jocoteles/Stellector/horus/horus_esp32/horus32/README.MD

# horus32.ino

This is the code to be loaded in the ESP32 board which is part of the Horus hardware in the Stellector project. A ESP-WROOM-32 DevKitC V1 was used for this project.
