jocoteles/Stellector/horus/horus_3d_parts/README.MD

Horus 3D parts
==============

Horus 3D parts were written with Python codes using FreeCAD libraries.

Files in *obj* format were rendered with FreeCAD using the Python codes.
