jocoteles/Stellector/horus/horus_3d_parts/spiralCoil_5v_p100.obj

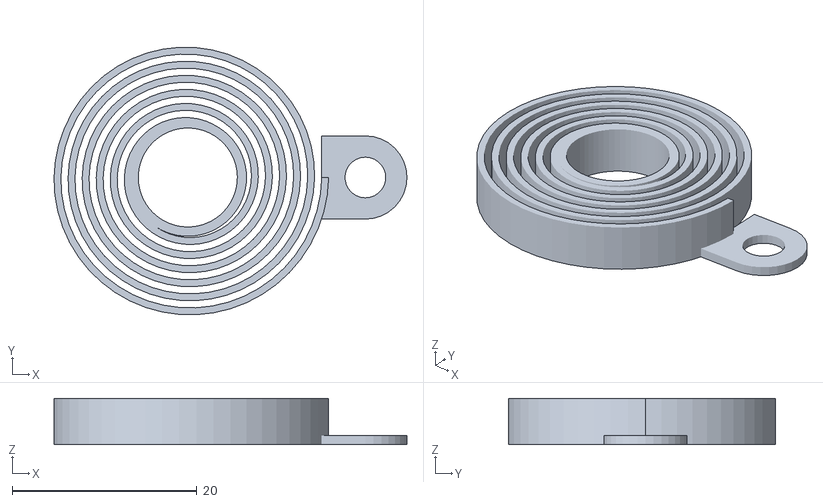
[picture p19: CAD file, 2021-11-09]
horus/horus_3d_parts/spiralCoil_5v_p100.obj
38.2 x 28.9 x 5.00
