jocoteles/Stellector/horus/horus_3d_parts/laserCase.obj

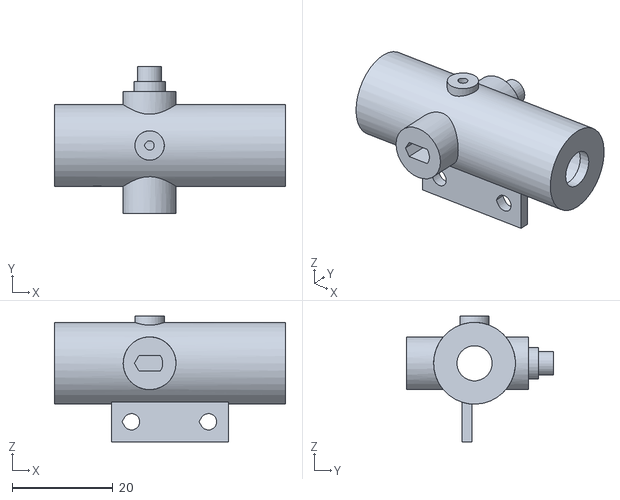
[picture p20: CAD file, 2021-11-01]
horus/horus_3d_parts/laserCase.obj
45.9 x 29.2 x 25.0
