jocoteles/Stellector/horus/horus_3d_parts/towerStepper.obj

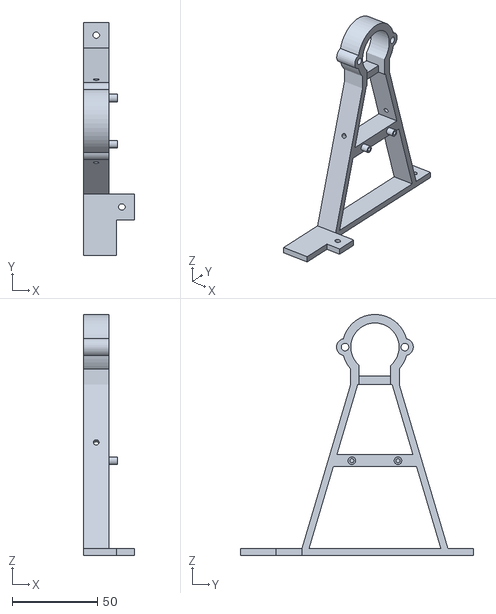
[picture p21: CAD file, 2021-11-01]
horus/horus_3d_parts/towerStepper.obj
30.0 x 136.5 x 141.1
