jocoteles/Stellector/horus/horus_3d_parts/towerBearing.obj

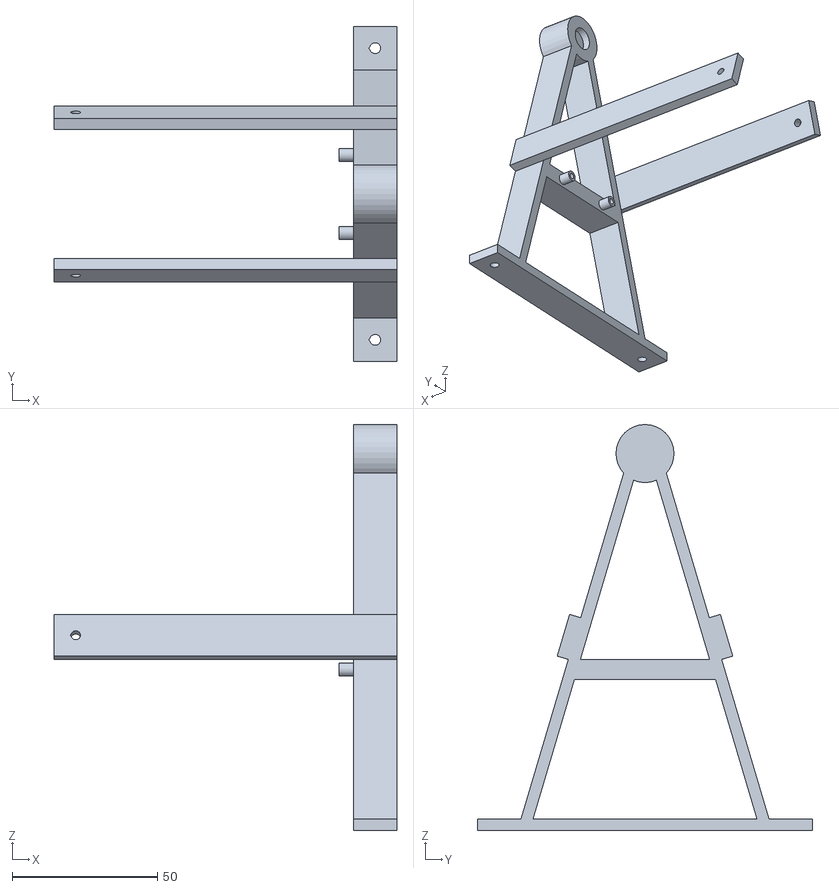
[picture p22: CAD file, 2021-11-01]
horus/horus_3d_parts/towerBearing.obj
118.2 x 115.5 x 140.0
