jocoteles/Stellector/horus/horus_3d_parts/laserShaftSupport.obj

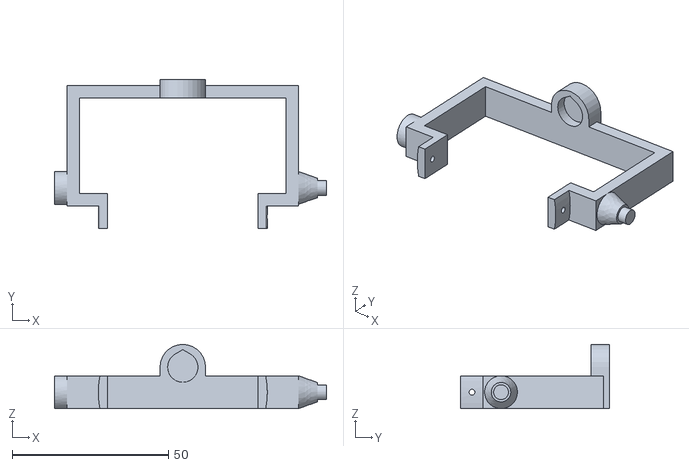
[picture p23: CAD file, 2021-11-01]
horus/horus_3d_parts/laserShaftSupport.obj
86.9 x 47.8 x 20.5
