jocoteles/Stellector/horus/horus_3d_parts/octagonalBase.obj

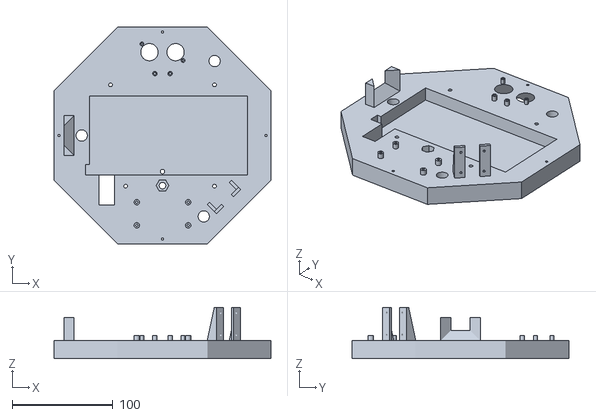
[picture p24: CAD file, 2021-11-01]
horus/horus_3d_parts/octagonalBase.obj
215.5 x 215.5 x 51.0
