jocoteles/Stellector/horus/horus_3d_parts/stepperMob.obj

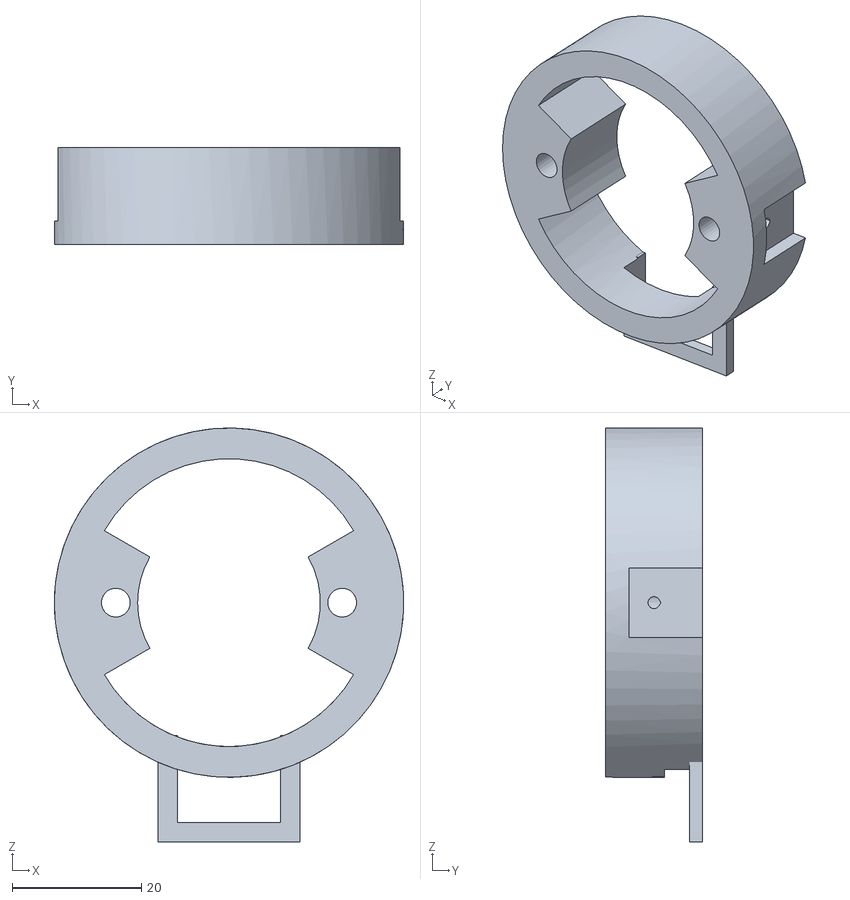
[picture p25: CAD file, 2021-11-01]
horus/horus_3d_parts/stepperMob.obj
54.0 x 15.0 x 64.0
