jocoteles/Stellector/horus/horus_electronics/Schematic_Stellector_2021-10-18.pdf

Fixed step motor | ESP32

## Fixed step motor driver

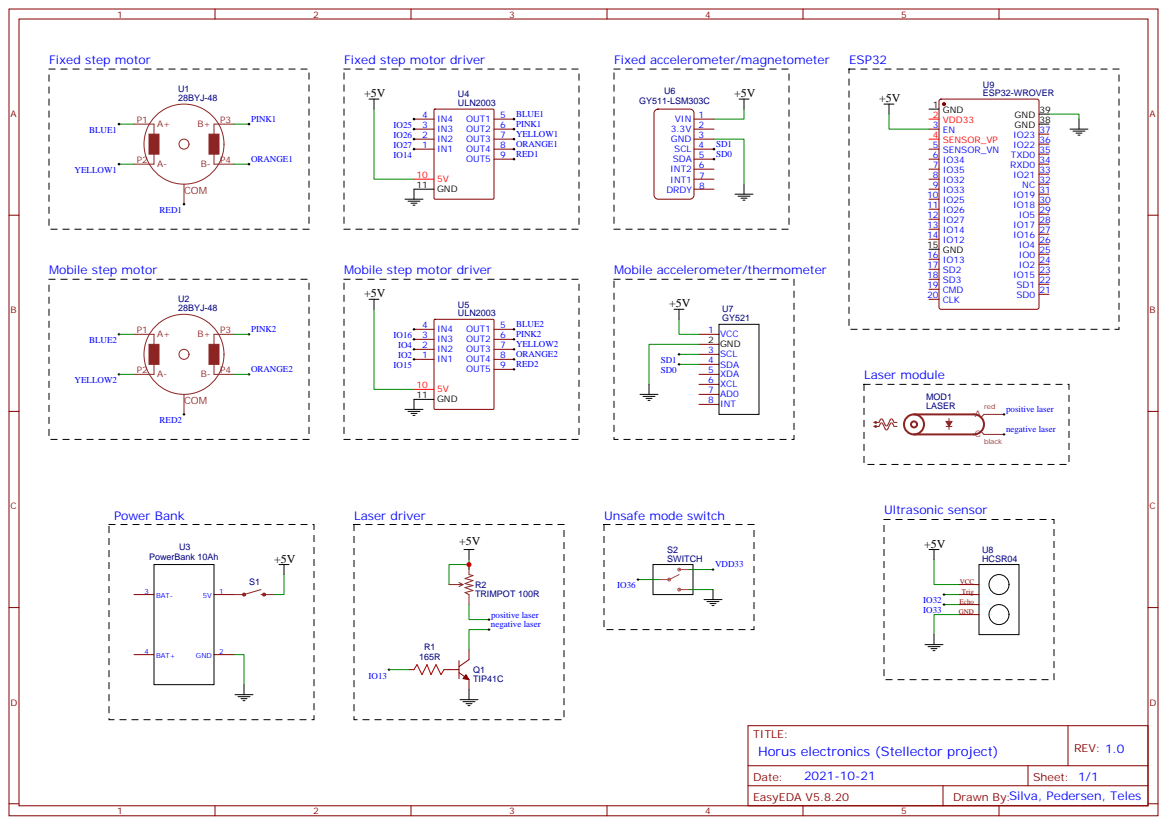
[picture p26: page 1]

TITLE:
Horus electronics (Stellector project)
