jocoteles/Stellector/images/stellector_diagram.pdf

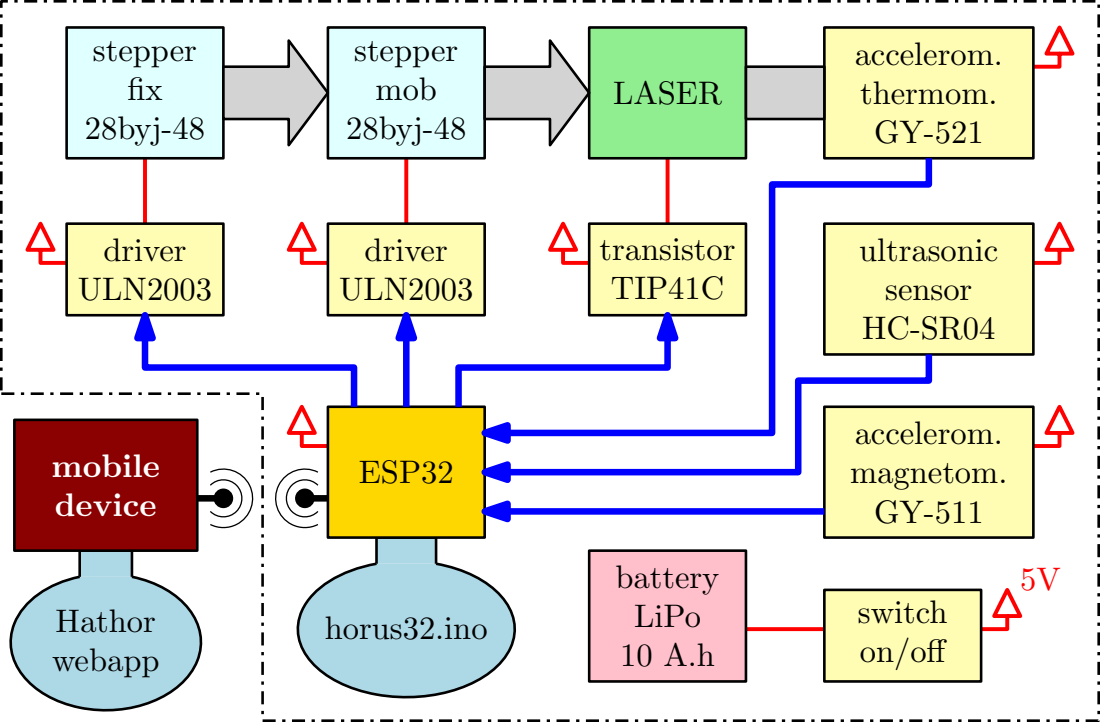
[picture p27: page 1]
stepper fix 28byj-48; stepper mob; 28byj-48; LASER; ultrasonic sensor HC-SR04; driver ULN2003; transistor TIP41C; accelerom. thermom. GY-521; accelerom. magnetom. GY-511; battery LiPo 10 A.h; switch on/off; Hathor horus32.ino webapp; mobile; device; ESP32
