jocoteles/Stellector/hathor/data/dsonames.js

/* 
Copyright (c) 2015, Olaf Frohn
All rights reserved.

Redistribution and use in source and binary forms, with or without modification, are permitted provided that the following conditions are met:

1. Redistributions of source code must retain the above copyright notice, this list of conditions and the following disclaimer.

2. Redistributions in binary form must reproduce the above copyright notice, this list of conditions and the following disclaimer in the documentation and/or other materials provided with the distribution.

3. Neither the name of the copyright holder nor the names of its contributors may be used to endorse or promote products derived from this software without specific prior written permission.

THIS SOFTWARE IS PROVIDED BY THE COPYRIGHT HOLDERS AND CONTRIBUTORS "AS IS" AND ANY EXPRESS OR IMPLIED WARRANTIES, INCLUDING, BUT NOT LIMITED TO, THE IMPLIED WARRANTIES OF MERCHANTABILITY AND FITNESS FOR A PARTICULAR PURPOSE ARE DISCLAIMED. IN NO EVENT SHALL THE COPYRIGHT HOLDER OR CONTRIBUTORS BE LIABLE FOR ANY DIRECT, INDIRECT, INCIDENTAL, SPECIAL, EXEMPLARY, OR CONSEQUENTIAL DAMAGES (INCLUDING, BUT NOT LIMITED TO, PROCUREMENT OF SUBSTITUTE GOODS OR SERVICES; LOSS OF USE, DATA, OR PROFITS; OR BUSINESS INTERRUPTION) HOWEVER CAUSED AND ON ANY THEORY OF LIABILITY, WHETHER IN CONTRACT, STRICT LIABILITY, OR TORT (INCLUDING NEGLIGENCE OR OTHERWISE) ARISING IN ANY WAY OUT OF THE USE OF THIS SOFTWARE, EVEN IF ADVISED OF THE POSSIBILITY OF SUCH DAMAGE.
*/

let dsonamesJSON = '{"18":{"name":"Calabash Nebula","ar":"‎‎سديم كالاباش‎‎","zh":"葫芦星云","fi":"Pullokurpitsasumu","fr":"Nébuleuse de la Calebasse","de":"Kürbis-Nebel","it":"Nebulosa Zucca","ko":"호리병박 성운","fa":"سحابی کدو قلیانی","es":"Nebulosa de la Calabaza","ru":"Туманность Калебаса"},"19":{"name":"Frosty Leo Nebula","ar":"‎‎سديم الأسد الصقيعي‎‎","zh":"霜狮星云","fi":"Leijonan huurresumu","fr":"Nébuleuse du Lion gelé","it":"Nebulosa Gelida del Leone","ko":"서리사자 성운","fa":"سحابی فراستی لئو","es":"Nebulosa del León Escarchado","ru":"Туманность Седой лев"},"20":{"name":"Gomez\'s Hamburger","ar":"‎‎هامبرجر جوميز‎‎","zh":"戈麦斯汉堡","fi":"Gomezin hampurilainen","fr":"Hamburger de Gomez","it":"Hamburger di Gomez","ko":"우주의 햄버거","fa":"سحابی همبرگرگومز","es":"Hamburguesa de Gomez","ru":"Гамбургер Гомеза"},"21":{"name":"Footprint Nebula","ar":"‎‎سديم أثر القدم‎‎","zh":"脚印星云","fi":"Jalanjälkisumu","fr":"Nébuleuse de l\'Empreinte de pas","de":"Fußabdruck-Nebel","it":"Nebulosa Orma","ja":"足跡星雲","ko":"발자국 성운","es":"Nebulosa de la Huella","ru":"Туманность След"},"22":{"name":"Sagittarius A East","ar":"‎‎القوس أ الشرقي‎‎","zh":"人马座东星","fi":"Sagittarius A itäinen","fr":"Sagittarius A Est","de":"Sagittarius A Ost","it":"Sagittarius A Est","ja":"いて座Aイースト","ko":"궁수자리 A 동쪽","la":"Sagittarius A orientalis","fa":"منطقه شرقی کماندار - A","es":"Sagittarius A Este","ru":"Восточный Стрелец А"},"23":{"name":"Sagittarius A West","ar":"‎‎القوس أ الغربي‎‎","zh":"人马座西星","fi":"Sagittarius A läntinen","fr":"Sagittarius A Ouest","it":"Sagittarius A Ovest","ja":"いて座Aウェスト","ko":"궁수자리 A 서쪽","la":"Sagittarius A occidentalis","fa":"منطقه غربی کماندار- A","es":"Sagittarius A Oeste","ru":"Западный Стрелец А"},"40":{"name":"Dark Doodad Nebula","ar":"‎سديم الشيء الداكن‎","zh":"黑饰品星云","fr":"Nébuleuse du Bidule sombre","de":"Dark Doodad","it":"Nebulosa Scura Marchingegno","ko":"다크 두데드 성운","es":"Nebulosa del Artilugio Oscuro","ru":"Туманность Тёмная штуковина"},"NGC 40":{"name":"Bow-Tie Nebula","ar":"‎‎سديم ربطة العنق‎‎","zh":"蝴蝶结星云","fi":"Rusettisumu","fr":"Nébuleuse du Nœud-Papillon","de":"Mascherl-Nebel","it":"Nebulosa Bow-Tie","ko":"부메랑 성운","fa":"سحابی پاپیون","es":"Nebulosa de lazo","ru":"Туманность Бабочка","tr":"Bumerang Bulutsusu"},"NGC 55":{"name":"String of Pearls","ar":"‎خيط اللؤلؤ‎","zh":"珍珠串星系","fi":"Helminauha","fr":"Collier de perles","de":"Perlenschnur","ko":"진주 고리","es":"Collar de Perlas","ru":"Жемчужная нить"},"NGC 87":{"name":"Robert\'s Quartet","ar":"‎‎رباعية روبرت‎‎","zh":"罗伯特四重星系","fi":"Robertin kvartetti","fr":"Quartette de Robert","de":"Roberts Quartett","it":"Quartetto di Robert","ko":"로버트의 사중주","fa":"چهارتایی رابرت","es":"Cuarteto de Robert","ru":"Квартет Роберта","tr":"Robert Dörtlüsü"},"NGC 88":{"name":"Robert\'s Quartet","ar":"‎‎رباعية روبرت‎‎","zh":"罗伯特四重星系","fi":"Robertin kvartetti","fr":"Quartette de Robert","de":"Roberts Quartett","it":"Quartetto di Robert","ko":"로버트의 사중주","fa":"چهارتایی رابرت","es":"Cuarteto de Robert","ru":"Квартет Роберта","tr":"Robert Dörtlüsü"},"NGC 89":{"name":"Robert\'s Quartet","ar":"‎‎رباعية روبرت‎‎","zh":"罗伯特四重星系","fi":"Robertin kvartetti","fr":"Quartette de Robert","de":"Roberts Quartett","it":"Quartetto di Robert","ko":"로버트의 사중주","fa":"چهارتایی رابرت","es":"Cuarteto de Robert","ru":"Квартет Роберта","tr":"Robert Dörtlüsü"},"NGC 92":{"name":"Robert\'s Quartet","ar":"‎‎رباعية روبرت‎‎","zh":"罗伯特四重星系","fi":"Robertin kvartetti","fr":"Quartette de Robert","de":"Roberts Quartett","it":"Quartetto di Robert","ko":"로버트의 사중주","fa":"چهارتایی رابرت","es":"Cuarteto de Robert","ru":"Квартет Роберта","tr":"Robert Dörtlüsü"},"NGC 104":{"name":"47 Tuc","ar":"‎‎47 الطوقان‎‎","zh":"杜鹃座47球状星团","de":"47 Tuc/NGC 104","el":"47 Τουκάνας","ja":"きょしちょう座47","ko":"큰부리새자리 47","fa":"47 تی یو سی","ru":"47 Тукана","he":"47 בטוקאן"},"NGC 128":{"name":"NGC 128 group","ar":"مجموعة إن جي سي ١٢٨","zh":"128星系群","fi":"NGC 128 -ryhmä","fr":"Groupe NGC 128","de":"NGC 128-Gruppe","ja":"NGC128銀河群","ko":"NGC 128 은하단","es":"Grupo NGC 128","ru":"Группа NGC 128"},"NGC 134":{"name":"Giant Squid Galaxy","ar":"‎‎مجرة الحبّار العملاق‎‎","zh":"大王乌贼星系","fi":"Jättiläiskalmarigalaksi","fr":"Galaxie du calmar géant","de":"Riesenkalmar-Galaxie","it":"NGC 134","ko":"대왕오징어 은하","fa":"کهکشان سرپاور عظیم","es":"Galaxia del calamar gigante","ru":"Галактика Гигантский кальмар"},"NGC 188":{"name":"Polarissima Cluster","ar":"‎حشد بولاريسيما‎","zh":"近极星团","fi":"Polarissima-joukko","fr":"Amas Polarissima","de":"Polarissima-Haufen","it":"Ammasso Polarissima","ko":"작은곰자리 성단","la":"Congregatio Polarissima","es":"Cúmulo Polarissima","ru":"Скопление Поляриссимы"},"NGC 206":{"name":"Great Star Cloud in Andromeda Galaxy","ar":"‎سحابة النجوم العظيمة في مجرة أندروميدا‎","zh":"仙女座星系中的大恒星云","fi":"Andromedan galaksin suuri tähtipilvi","fr":"Grand numage d\'étoiles de la Galaxie d\'Andromède","de":"Große Sternwolke in der Andromeda-Galaxie","it":"Grande Nube Stellare nella galassia di Andromeda","ja":"アンドロメダ銀河の大スタークラウド","ko":"안드로메다 은하의 대성운","la":"Magna Nubes Stellarum in Galaxia Andromedae","es":"Gran nube de estrellas en la galaxia de Andrómeda","ru":"Большое звёздное облако в галактике Андромеды","tr":"Andromeda Galaksi\'sinde Büyük Yıldız Bulutu"},"NGC 224":{"name":"Andromeda Galaxy","ar":"‎‎مجرة أندروميدا‎‎","zh":"仙女座星系","fi":"Andromedan galaksi","fr":"Galaxie d\'Andromède","de":"Andromeda-Galaxie","el":"Γαλαξίας της Ανδρομέδας","it":"Galassia di Andromeda","ja":"アンドロメダ銀河","ko":"안드로메다 은하","la":"Andromeda Nebula","fa":"کهکشان آندرومدا","es":"Galaxia Andrómeda","ru":"Галактика Андромеды","tr":"Andromeda Gökadası","he":"גלקסיית אנדרומדה"},"NGC 225":{"name":"Sailboat Cluster","ar":"‎‎حشد القارب الشراعي‎‎","zh":"帆船星团","fi":"Purjevenejoukko","fr":"Amas du Voilier","de":"Segelboot-Haufen","it":"Ammasso Barca a Vela","ko":"돛단배 성단","la":"Congregatio naviculi velati","fa":"خوشه کشتی بادبانی","es":"Cúmulo de Veleros","ru":"Скопление Парусник","tr":"Yelkenli Kümesi"},"NGC 246":{"name":"Skull Nebula","ar":"‎‎سديم الجمجمة‎‎","zh":"头骨星云","fi":"Pääkallosumu","fr":"Nébuleuse du Crâne","de":"Totenkopfnebel","it":"Nebulosa Teschio","ko":"해골 성운","fa":"سحابی جمجمه ای","es":"Nebulosa del cráneo","ru":"Туманность Череп","tr":"Kafatası Bulutsusu"},"NGC 247":{"name":"Burbidge Chain","ar":"‎سلسلة بربيدج‎","zh":"伯比奇链","fi":"Burbidgen ketju","fr":"La Chaîne de Burbidge","de":"Burbidge-Kette","it":"Catena Burbidge","ko":"버브리지의 사슬","la":"Catena Burbidgei","es":"Cadena de Burbidge","ru":"Цепочка Бербиджа","tr":"Burbidge Zinciri"},"PGC 2796":{"name":"Burbidge Chain","ar":"‎سلسلة بربيدج‎","zh":"伯比奇链","fi":"Burbidgen ketju","fr":"La Chaîne de Burbidge","de":"Burbidge-Kette","it":"Catena Burbidge","ko":"버브리지의 사슬","la":"Catena Burbidgei","es":"Cadena de Burbidge","ru":"Цепочка Бербиджа","tr":"Burbidge Zinciri"},"NGC 253":{"name":"Sculptor Galaxy","ar":"‎مجرة النحّات‎","zh":"玉夫座星系","fi":"Kuvanveistäjägalaksi","fr":"Galaxie du Sculpteur","de":"Sculptor-Galaxie","el":"Γαλαξίας του Γλύπτη","it":"Galassia dello Scultore","ja":"ちょうこくしつ座銀河","ko":"조각자리 은하","la":"Galaxia Sculptoris","fa":"کهکشان مجسمه‌ساز","es":"Galaxia del Escultor","ru":"Галактика Скульптора","tr":"Heykeltraş Gökadası","he":"גלקסיית הפסל"},"NGC 281":{"name":"Pacman Nebula","ar":"‎‎سديم باكمان‎‎","zh":"吃豆人星云","fi":"Pacman-sumu","fr":"Nébuleuse Pacman","de":"Pacman-Nebel","it":"Nebulosa Pacman","ja":"パックマン星雲","ko":"팩맨 성운","fa":"سحابی پکمن","es":"Nebulosa Pacman","ru":"Туманность Пакман"},"NGC 300":{"name":"Southern Pinwheel Galaxy","ar":"‎‎مجرة المروحة الجنوبية‎‎","zh":"南风车星系","fi":"Etelän tuulimyllygalaksi","fr":"Galaxie du Moulinet du Sud","de":"Südliche Feuerrad-Galaxie","it":"Galassia Girandola del Sud","ja":"南の回転花火銀河","ko":"남쪽바람개비 은하","fa":"کهکشان فرفره جنوبی","es":"Galaxia Molinillo Austral","ru":"Галактика Южная вертушка","tr":"Güney Fırıldak Gökadası"},"NGC 5236":{"name":"Southern Pinwheel Galaxy","ar":"‎‎مجرة المروحة الجنوبية‎‎","zh":"南风车星系","fi":"Etelän tuulimyllygalaksi","fr":"Galaxie du Moulinet du Sud","de":"Südliche Feuerrad-Galaxie","it":"Galassia Girandola del Sud","ja":"南の回転花火銀河","ko":"남쪽바람개비 은하","fa":"کهکشان فرفره جنوبی","es":"Galaxia Molinillo Austral","ru":"Галактика Южная вертушка","tr":"Güney Fırıldak Gökadası","he":"גלקסיית גלגל הרוח הדרומית"},"NGC 375":{"name":"Pisces Cloud","ar":"‎سحابة الحوت‎","zh":"双鱼座云","fi":"Kalojen pilvi","de":"Fische-Wolke","it":"Nube dei Pesci","ko":"물고기자리 성운","la":"Nubes Piscium","es":"Nube de Piscis","ru":"Облако Рыб","tr":"Balık Bulutu"},"NGC 383":{"name":"NGC 383 group","ar":"مجموعة إن جي سي ٣٨٣","zh":"383星系群","fi":"NGC 383 -ryhmä","fr":"Groupe NGC 383","de":"NGC 383-Gruppe","ja":"NGC383銀河群","ko":"NGC 383 은하단","es":"Grupo NGC 383","ru":"Группа NGC 383"},"NGC 262":{"name":"Markarian 348","ar":"‎‎ماركاريان 348‎‎","zh":"马卡良348","it":"NGC 262","ja":"マルカリアン348","ko":"마카리안 348","fa":"مارکارین 348","ru":"Маркариан 348"},"NGC 292":{"name":"Small Magellanic Cloud","ar":"‎‎السحابة الماجلانية الصغيرة‎‎","zh":"小麦哲伦云","fi":"Pieni Magellanin pilvi","fr":"Petit nuage de Magellan","de":"Kleine Magellanische Wolke","el":"Μικρό Μαγγελανικό Νέφος","it":"Piccola nube di Magellano","ja":"小マゼラン雲","ko":"소마젤란 성운","la":"Nubecula Minor","fa":"ابر کوچک ماژلانی","es":"Pequeña nube de Magallanes","ru":"Малое Магелланово облако","tr":"Küçük Macellan Bulutsusu","he":"ענן מגלן הקטן"},"NGC 404":{"name":"Mirach\'s Ghost","ar":"‎‎شبح ميراتش‎‎","zh":"奎宿九之魂","fi":"Mirachin varjo","fr":"Fantôme de Mirach","de":"Mirachs Geist","it":"Fantasma di Mirach","ko":"미라크의 유령","la":"Spiritus Mirachae","fa":"شبح میراچ","es":"Fantasma de Mirach","ru":"Призрак Мирака"},"NGC 507":{"name":"NGC 507 group","ar":"مجموعة إن جي سي ٥٠٧","zh":"507星系群","fi":"NGC 507 -ryhmä","fr":"Groupe NGC 507","de":"NGC 507-Gruppe","ja":"NGC507銀河群","ko":"NGC 507 은하단","es":"Grupo NGC 507","ru":"Группа NGC 507"},"NGC 457":{"name":"Dragonfly Cluster","ar":"‎‎حشد اليعسوب‎‎","zh":"蜻蜓星团","fi":"Sudenkorentojoukko","fr":"Amas de la Libellule","de":"Libellen-Haufen","it":"Ammasso Libellula","ko":"잠자리 성단","fa":"خوشه سنجاقک","es":"Cúmulo de la Libélula","ru":"Скопление Стрекоза","tr":"Dragonfly Kümesi"},"NGC 488":{"name":"Whirligig Galaxy","ar":"‎مجرة الدوامة‎","zh":"转马星系","fi":"Väkkärägalaksi","fr":"Galaxie de la Toupie","de":"Whirligig-Galaxie","it":"Galassia Trottola","ko":"회전목마 은하","es":"Galaxia Whirligig","ru":"Галактика Волчок"},"NGC 584":{"name":"Little Spindle Galaxy","ar":"‎مجرة المغزل الصغير‎","zh":"小主轴星系","fi":"Pieni värttinägalaksi","fr":"Galaxie du Petit Fuseau","de":"Kleine Spindel-Galaxie","it":"Galassia Piccolo Mandrino","ko":"작은방추 은하","es":"pequeña Galaxia de Spindle","ru":"Галактика Малое веретено"},"NGC 598":{"name":"Triangulum Galaxy","ar":"‎مجرة تريانجولوم‎","zh":"三角座星系","fi":"Kolmion galaksi","fr":"Galaxie du Triangle","de":"Dreiecksgalaxie","el":"Γαλαξίας του Τριγώνου","it":"Galassia del Triangolo","ja":"さんかく座銀河","ko":"삼각형자리 은하","la":"Triangulum Galaxia","fa":"کهکشان مثلثی","es":"Galaxia del Triángulo","ru":"Галактика Треугольника","tr":"Üçgen Gökadası","he":"גלקסיית המשולש"},"NGC 628":{"name":"Phantom Galaxy","ar":"‎مجرة الشبح‎","zh":"幻影星系","fi":"Kummitusgalaksi","fr":"Galaxie du Fantôme","de":"Phantom-Galaxie","it":"Galassia Fantasma","ko":"유령 은하","la":"Phantom Galaxia","es":"Galaxia del Abanico","ru":"Галактика Фантом"},"NGC 650":{"name":"Little Dumbbell Nebula","ar":"‎‎سديم الأثقال الصغير‎‎","zh":"小哑铃星云","fi":"Pieni nostopainosumu","fr":"Nébuleuse de la Petite haltère","de":"Kleiner Hantelnebel","it":"Nebulosa Piccola Campana","ja":"小亜鈴星雲","ko":"작은아령 성운","fa":"سحابی دمبل کوچک","es":"Pequeña Nebulosa Dumbbell","ru":"Туманность Малая гантель","tr":"Küçük Halter Bulutsusu","he":"ערפילית המשקולת הקטנה"},"NGC 651":{"name":"Little Dumbbell Nebula","ar":"‎‎سديم الأثقال الصغير‎‎","zh":"小哑铃星云","fi":"Pieni nostopainosumu","fr":"Nébuleuse de la Petite haltère","de":"Kleiner Hantelnebel","it":"Nebulosa Piccola Campana","ja":"小亜鈴星雲","ko":"작은아령 성운","fa":"سحابی دمبل کوچک","es":"Pequeña Nebulosa Dumbbell","ru":"Туманность Малая гантель","tr":"Küçük Halter Bulutsusu"},"NGC 654":{"name":"Fuzzy Butterfly Cluster","ar":"‎حشد الفراشة ذات الزغب‎","zh":"迷蝶星团","fi":"Sumea perhosjoukko","de":"Schmetterlingshaufen","it":"Ammasso Farfalla Sfocata","ko":"보송나비 성단","es":"Cúmulo de la Mariposa","ru":"Скопление Пушистая бабочка"},"NGC 659":{"name":"Yin-Yang Cluster","ar":"عنقود ين ويانغ","zh":"阴阳星团","fi":"Jin-Jang-joukko","fr":"Amas Yin-Yang","de":"Yin-Yang-Haufen","ko":"음양 성운","es":"Cúmulo Yin-Yang","ru":"Скопление Инь-Янь"},"NGC 663":{"name":"Lawnmower Cluster","ar":"‎حشد آلة قص العشب‎","zh":"割草机星团","fi":"Ruohonleikkurijoukko","fr":"Amas de la Tondeuse à gazon","de":"Rasenmäher-Haufen","it":"Ammasso Tagliaerba","ko":"잔디깍기 성단","es":"Cúmulo Lawnmower","ru":"Скопление Газонокосилка"},"NGC 772":{"name":"Fiddlehead Galaxy","ar":"‎مجرة نبات الفدلهيد‎","zh":"蕨菜星系","fi":"Saniaisenlehtigalaksi","fr":"Galaxie de la Crosse de fougère","de":"Fiedelkopf-Galaxie","it":"Galassia Testa di Violino","ko":"피들헤드 은하","es":"Galaxia Fiddlehead","ru":"Галактика Резное украшение на носу корабля"},"NGC 869":{"name":"h Persei","zh":"英仙座","ja":"h","ko":"NGC 869","ru":"h Персея","he":"h בפרסאוס"},"NGC 884":{"name":"χ Persei","zh":"英仙座χ","ja":"χ","ko":"페르세우스자리 X","ru":"χ Персея","he":"χ בפרסאוס"},"NGC 936":{"name":"Darth Vader\'s Starfighter","ar":"‎مقاتلة دارث فادر‎","zh":"达斯·维德的星际战舰","fi":"Darth Vaderin tähtihävittäjä","fr":"Starfighter de Dark Vador","de":"Darth Vaders Starfighter","ko":"다스베이더의 스타파이터","es":"Caza Estelar de Darth Vader","ru":"Истребитель Дарта Вейдера"},"NGC 1023":{"name":"Perseus Lenticular Galaxy","ar":"‎مجرة حامل رأس الغول العدسية‎","zh":"仙人掌星系","fi":"Perseuksen linssigalaksi","fr":"Galaxie lenticulaire de Persée","de":"Perseus-Linsengalaxie","it":"Galassia Lenticolare di Perseo","ko":"페르세우스 렌즈형 은하","es":"Galaxia Lenticular Perseo","ru":"Линзовидная галактика Персея"},"NGC 1039":{"name":"Spiral Cluster","ar":"‎‎حشد اللولب‎‎","zh":"螺旋星团","fi":"Spiraalijoukko","fr":"Amas spirale","de":"Spiral-Haufen","it":"Ammasso a Spirale","ko":"나선 성단","la":"Congregatio spiralis","fa":"خوشه مارپیچ","es":"Cúmulo Espiral","ru":"Спиральное скопление","tr":"Sarmal Yıldız Kümesi"},"NGC 1049":{"name":"Fornax Dwarf Cluster 3","ar":"‎حشد الفرن القزم 3‎","zh":"天炉座矮星系球状星团3","fi":"Sulatusuunin kääpiöjoukko 3","fr":"Amas nain du Fourneau 3","de":"Fornax Zwerghaufen 3","it":"Ammasso Nano della Fornace 3","ja":"ろ座矮小球状星団3","ko":"화로자리 왜소성단 3","es":"Cúmulo Enano de Fornax 3","ru":"3-е карликовое скопление Печи"},"NGC 1068":{"name":"Cetus A","ar":"‎‎مجرة قيطس A‎‎","zh":"鲸鱼座","fr":"Cetus A","el":"Κήτος Α","ja":"くじら座A","ko":"고래자리 알파","fa":"نهنگ A","es":"Ballena A","ru":"Кит А","tr":"Balina A"},"NGC 1232":{"name":"Eye of God Galaxy","ar":"‎مجرة العين الكبيرة‎","zh":"上帝之眼星系","fi":"Jumalan silmä","fr":"Galaxie de l\'Oeil de Dieu","de":"Auge Gottes-Galaxie","it":"Galassia Occhio di Dio","ko":"나선 성운","la":"Oculus dei galaxia","es":"Galaxia Ojo de Dios","ru":"Галактика Глаз Бога","tr":"Tanrının Gözü Gökadası"},"NGC 1245":{"name":"Patrick Starfish Cluster","ar":"‎حشد نجمة بحر باتريك‎","zh":"帕特里克海星星团","fi":"Patrick-meritähtijoukko","de":"Patrick Star-Haufen","it":"Ammasso Patrick Starfish","ko":"패트릭의 불가사리 성단","es":"Cúmulo Estrella de Mar Patrick","ru":"Скопление Морская звезда Патрик"},"NGC 1269":{"name":"Snow Collar Galaxy","ar":"‎مجرة طوق الثلج‎","zh":"雪领星系","fi":"Lumikaulusgalaksi","fr":"Galaxie du Collier de neige","de":"Schneekragen-Galaxie","ko":"스노우칼라 은하","es":"Galaxia Collar de Nieve","ru":"Галактика Снеговик"},"NGC 1275":{"name":"Perseus A","ar":"‎‎برشاوش ا‎‎","zh":"英仙座","fr":"Perseus A","el":"Περσέας Α","ja":"ペルセウス座A","ko":"페가수스 알파","fa":"پرساوش A","es":"Perseo A","ru":"Персей А","tr":"Kahraman A"},"NGC 1316":{"name":"Fornax A","ar":"‎‎الفرن ا‎‎","zh":"天炉座","fr":"Fornax A","el":"Καμίνι Α","ja":"ろ座A","ko":"화로자리 알파","fa":"کورۀ کیمیاگری A","ru":"Печь А","tr":"Ocak A"},"NGC 1317":{"name":"Fornax B","ar":"‎‎الفرن ب‎‎","zh":"天炉座","fr":"Fornax B","el":"Καμίνι B","ja":"ろ座B","ko":"화로자리 B","fa":"کوره B","ru":"Печь Б","tr":"Ocak B"},"NGC 1333":{"name":"Embryo Nebula","ar":"‎سديم الجنين‎","zh":"胚胎星云","fi":"Sikiösumu","fr":"Nébuleuse de l\'Embryon","de":"Embryo-Nebel","it":"Nebulosa Embrione","ko":"영혼 성운","es":"Nebulosa del Alma","ru":"Туманность Эмбрион"},"NGC 1342":{"name":"Little Scorpion Cluster","ar":"‎‎حشد العقرب الصغير‎‎","zh":"小蝎星团","fi":"Pieni skorpionijoukko","fr":"Amas du petit scorpion","de":"Kleiner Skorpion-Haufen","it":"Ammasso del Piccolo Scoprione","ko":"작은 전갈 성단","la":"Congregatio scorpionis parva","fa":"خوشه عقرب کوچک","es":"Cúmulo del Pequeño Escorpión","ru":"Скопление Малый скорпион","tr":"Küçük Akrep Yıldız Kümesi"},"NGC 5281":{"name":"Little Scorpion Cluster","ar":"‎‎حشد العقرب الصغير‎‎","zh":"小蝎星团","fi":"Pieni skorpionijoukko","fr":"Amas du petit scorpion","de":"Kleiner Skorpion-Haufen","it":"Ammasso del Piccolo Scoprione","ko":"작은 전갈 성단","la":"Congregatio scorpionis parva","fa":"خوشه عقرب کوچک","es":"Cúmulo del Pequeño Escorpión","ru":"Скопление Малый скорпион","tr":"Küçük Akrep Yıldız Kümesi"},"NGC 1350":{"name":"The Colossal Cosmic Eye","ar":"‎العين الكونية الهائلة‎","zh":"宇宙大眼睛星系","fi":"Suuri kosminen silmä","fr":"L’Œil cosmique colossal","de":"Kolossales Kosmisches Auge","ko":"거대한 우주의 눈","es":"El Ojo Cósmico Colosal","ru":"Колоссальный космический глаз"},"NGC 1360":{"name":"Robin\'s Egg Nebula","ar":"‎‎سديم بيضة عصفور أبو الحناء‎‎","zh":"知更鸟蛋星云","fi":"Robinin kananmunasumu","fr":"Nébuleuse de l\'Oeuf de Robin","de":"Rotkehlchenei-Nebel","it":"Nebulosa Uovo di Robin","ko":"로빈의 달걀 성운","fa":"سحابی تخم پرنده سینه سرخ","es":"Nebulosa Robin\'s Egg","ru":"Туманность Яйцо Робина"},"NGC 1365":{"name":"Great Barred Spiral Galaxy","ar":"‎المجرة الحلزونية القضيبية العظيمة‎","zh":"大棒旋星系","fi":"Suuri sauvaspiraaligalaksi","fr":"Grande Galaxie spirale barrée","de":"Große Balkenspiral-Galaxie","ko":"거대 줄무늬 나선 은하","es":"Gran Galaxia Espiral Barrada","ru":"Большая галактика с перемычкой","tr":"Büyük Çubuklu Sarmal Gökada"},"NGC 1407":{"name":"Eridanus A Group","ar":"‎مجموعة أي النهر‎","zh":"波江座星系群","fi":"Eridanus A -ryhmä","fr":"Groupe Eridanus A","de":"Eridanus A Gruppe","ja":"エリダヌス座A銀河群","ko":"에리다누스 A 은하단","es":"Grupo Eridanus A","ru":"Группа Эридан А"},"NGC 1432":{"name":"Maia Nebula","ar":"‎سديم مايا‎","zh":"昴宿四星云","fi":"Maiasumu","fr":"Nébuleuse de Maia","de":"Maia-Nebel","el":"Νεφέλωμα Μαία","it":"Nebulosa di Maia","ja":"マイア星雲","ko":"마이아 성운","fa":"سحابی مائیا","es":"Nebulosa Maia","ru":"Туманность Майи","tr":"Maia Bulutsusu"},"NGC 1435":{"name":"Merope Nebula","ar":"‎سديم ميروب‎","zh":"昴宿五星云","fi":"Meropesumu","fr":"Nébuleuse de Merope","de":"Merope-Nebel","el":"Νεφέλωμα Μερόπης","it":"Nebulosa di Merope","ja":"メローペ星雲","ko":"메로페 성운","fa":"سحابی مروپ","es":"Nebulosa de Merope","ru":"Туманность Меропы","tr":"Merope Bulutsusu"},"NGC 1491":{"name":"Fossil Footprint Nebula","ar":"‎سديم طبعة القدم الأحفورية‎","zh":"化石足迹星云","fi":"Fossiilijalanjälkisumu","fr":"Nébuleuse de l\'Empreinte fossile","de":"Fossilien-Fußabdruck-Nebel","it":"Nebulosa Orma Fossile","ko":"화석 발자국 성운","es":"Nebulosa Huella Fósil","ru":"Туманность След окаменелости"},"NGC 1499":{"name":"California Nebula","ar":"‎سديم كاليفورنيا‎","zh":"加利福尼亚星云","fi":"Kaliforniasumu","fr":"Nébuleuse de Californie","de":"Kalifornien-Nebel","el":"Νεφέλωμα Καλιφόρνια","it":"Nebulosa California","ja":"カリフォルニア星雲","ko":"캘리포니아 성운","fa":"سحابی کالیفرنیا","es":"Nebulosa de California","ru":"Туманность Калифорния","tr":"California Bulutsusu"},"NGC 1501":{"name":"Camel\'s Eye Nebula","ar":"‎‎سديم عين الجمل‎‎","zh":"骆驼之眼星云","fi":"Kamelinsilmäsumu","fr":"Nébuleuse de l\'Oeil du Chameau","de":"Kamelaugen-Nebel","it":"Nebulosa Occhio di Camello","ko":"낙타 눈 성운","la":"Oculus cameli nebula","fa":"سحابی چشم شتر","es":"Nebulosa Ojo de Camello","ru":"Туманность Верблюжий глаз","tr":"Deve\'nin Gözü Bulutsusu"},"NGC 1502":{"name":"Jolly Roger Cluster","ar":"‎حشد جولي روجر‎","zh":"海盗旗星团","fi":"Merirosvolippujoukko","fr":"Amas Jolly Roger","de":"Jolly Roger-Haufen","it":"Ammasso \\t Jolly Roger","ko":"졸리 로저 성단","la":"Congregatio Jolly Roger","fa":"خوشه پرچم دزد دریایی","es":"Cúmulo Jolly Roger","ru":"Скопление Весёлый Роджер"},"NGC 1514":{"name":"Crystal Ball Nebula","ar":"‎سديم كرة الكريستال‎","zh":"水晶球星云","fi":"Kristallipallosumu","fr":"Nébuleuse de la Boule de crystal","de":"Kristallkugel-Nebel","it":"Nebulosa Sfera di Cristallo","ko":"수정구 성운","la":"Nebula spherae crystallinae","fa":"سحابی گوی بلورین","es":"Nebulosa Bola de Cristal","ru":"Туманность Хрустальный шар"},"NGC 1528":{"name":"m & m Double Cluster","ar":"‎حشد إم & إم المزدوج‎","zh":"&双星团","fi":"m&m-kaksoisjoukko","de":"m&m Doppelhaufen","ko":"m & m 이중성단","es":"Cúmulo Doble m & m","ru":"Двойное скопление m & m"},"NGC 1545":{"name":"m & m Double Cluster","ar":"‎حشد إم & إم المزدوج‎","zh":"&双星团","fi":"m&m-kaksoisjoukko","de":"m&m Doppelhaufen","ko":"m & m 이중성단","es":"Cúmulo Doble m & m","ru":"Двойное скопление m & m"},"NGC 1535":{"name":"Cleopatra\'s Eye Nebula","ar":"‎‎سديم عين كليوباترا‎‎","zh":"埃及艳后之眼星云","fi":"Kleopatran silmä","fr":"Nébuleuse de l\'Oeil de Cléopâtre","de":"Kleopatras Auge-Nebel","it":"Nebulosa Occhio di Clepoatra","ko":"클레오파트라의 눈 성운","la":"Oculus Cleopatrae Nebula","fa":"سحابی چشم کلوپاترا","es":"Nebulosa Ojo de Cleopatra","ru":"Туманность Глаз Клеопатры","tr":"Kleopatra\'nın Gözü Bulutsusu"},"NGC 1554":{"name":"Struve\'s Lost Nebula","ar":"‎سديم ستروف المفقود‎","zh":"斯特鲁维遗失星云","fi":"Struven kadonnut kaasusumu","fr":"Nébuleuse perdue de Struve","de":"Struves Verlorener Nebel","el":"Χαμένο Νεφέλωμα του Στρούβε","it":"Nebulosa perduta di Struve","ja":"ストローブの失われた星雲","ko":"스트루브의 잃어버린 성운","fa":"سحابی مفقود اشترووه","es":"Nebulosa Perdida de Struve","ru":"Потерянная туманность Струве","tr":"Struve\'in Kayıp Bulutsusu"},"NGC 1555":{"name":"Hind\'s Variable Nebula","ar":"‎سديم هند المتغير‎","zh":"欣德变光星云","fi":"Hindin muuttuva sumu","fr":"Nébuleuse variable de Hind","de":"Hinds Variabler Nebel","it":"Nebulosa variabile di Hind","ja":"ハインドの変光星雲","ko":"하인드의 변동성운","es":"Nebulosa variable de Hind","ru":"Переменная туманность Хинда"},"NGC 1579":{"name":"Northern Trifid Nebula","ar":"‎سديم ثلاثي الفصوص الشمالي‎","zh":"北三裂星云","fi":"Pohjoinen trifidisumu","fr":"Nébuleuse Trifide septentrionale","de":"Nördlicher Trifidnebel","ko":"북쪽 삼렬성운","es":"Nebulosa Trífida del Norte","ru":"Северная трехраздельная туманность"},"NGC 1595":{"name":"Carafe Group","ar":"‎‎مجموعة مجرات القنينة‎‎","zh":"雕具座星系群","fi":"Carafe-ryhmä","fr":"Groupe Carafe","de":"Karaffen-Gruppe","el":"Σύμπλεγμα Καράφα","it":"Gruppo di Carafe","ja":"カラフェ銀河群","ko":"카라페 그룹","la":"Caetus caraffae","fa":"گروه کارافه","es":"Grupo Carafe","ru":"Группа Графина","tr":"Carafe Grubu"},"NGC 1598":{"name":"Carafe Group","ar":"‎‎مجموعة مجرات القنينة‎‎","zh":"雕具座星系群","fi":"Carafe-ryhmä","fr":"Groupe Carafe","de":"Karaffen-Gruppe","el":"Σύμπλεγμα Καράφα","it":"Gruppo di Carafe","ja":"カラフェ銀河群","ko":"카라페 그룹","la":"Caetus caraffae","fa":"گروه کارافه","es":"Grupo Carafe","ru":"Группа Графина","tr":"Carafe Grubu"},"NGC 1647":{"name":"Pirate Moon Cluster","ar":"‎حشد قمر القراصنة‎","zh":"海盗之月星团","fi":"Merirosvojoukko","de":"Piratenmond-Haufen","it":"Ammasso Luna del Pirata","ko":"해적 달 성운","es":"Cúmulo del Pirata Lunar","ru":"Скопление Пиратская луна"},"NGC 1664":{"name":"4-H cluster","ar":"‎حشد 4-H ‎","zh":"4- 星团","fi":"4-H-joukko","fr":"Amas 4-H","de":"4-H-Haufen","ko":"4-H 성단","es":"Cúmulo 4-H","ru":"Скопление 4-H"},"NGC 1788":{"name":"Cosmic Bat Nebula","ar":"سديم الخفاش الكوني","zh":"宇宙蝙蝠星云","fi":"Kosminen lepakko","fr":"Nébuleuse de la Chauve-souris Cosmique","de":"Kosmische Fledermaus-Nebel","ko":"우주 박쥐 성운","es":"Nebulosa del Murciélago Cósmico","ru":"Туманность Космическая летучая мышь"},"NGC 1807":{"name":"Poor Man\'s Double Cluster","ar":"‎حشد الرجل الفقير المزدوج‎","zh":"贫双星团","fi":"Köyhän miehen kaksoisjoukko","de":"Arme-Leute-Doppelhaufen","it":"Doppio Ammasso del Povero","ko":"거지의 이중성단","la":"Congregatio duplex viri pauperi","es":"Cúmulo Doble del Hombre Pobre","ru":"Скопление Двушка бедняка"},"NGC 1817":{"name":"Poor Man\'s Double Cluster","ar":"‎حشد الرجل الفقير المزدوج‎","zh":"贫双星团","fi":"Köyhän miehen kaksoisjoukko","de":"Arme-Leute-Doppelhaufen","it":"Doppio Ammasso del Povero","ko":"거지의 이중성단","la":"Congregatio duplex viri pauperi","es":"Cúmulo Doble del Hombre Pobre","ru":"Скопление Двушка бедняка"},"NGC 1893":{"name":"Letter Y Cluster","ar":"حشد حرف واي","zh":"字母星团","de":"Y-Haufen","it":"Ammasso Lettera Y","ko":"Y자 성단","es":"Cúmulo Letra Y","ru":"Скопление Буква Y"},"NGC 1910":{"name":"S Dor Cluster","ar":"‎حشد إس أبو سيف‎","zh":"剑鱼座星团","fi":"S Doradus -joukko","de":"S Dor-Haufen","ja":"かじき座S星団","ko":"S Dor 성단","es":"Cúmulo S Dor","ru":"Скопление S Золотой рыбы"},"NGC 1912":{"name":"Starfish Cluster","ar":"‎‎حشد سمكة النجمة‎‎","zh":"海星星团","fi":"Meritähtijoukko","fr":"Amas de l\'Étoile de mer","de":"Seestern-Haufen","it":"Amasso Stella Marina","ko":"불가사리 성단","fa":"خوشه ستاره دریایی","es":"Cúmulo Estrella de Mar","ru":"Скопление Морская звезда"},"NGC 1922":{"name":"Starfish Cluster","ar":"‎‎حشد سمكة النجمة‎‎","zh":"海星星团","fi":"Meritähtijoukko","fr":"Amas de l\'Étoile de mer","de":"Seestern-Haufen","it":"Amasso Stella Marina","ko":"불가사리 성단","fa":"خوشه ستاره دریایی","es":"Cúmulo Estrella de Mar","ru":"Скопление Морская звезда"},"NGC 6544":{"name":"Starfish Cluster","ar":"‎‎حشد سمكة النجمة‎‎","zh":"海星星团","fi":"Meritähtijoukko","fr":"Amas de l\'Étoile de mer","de":"Seestern-Haufen","it":"Amasso Stella Marina","ko":"불가사리 성단","fa":"خوشه ستاره دریایی","es":"Cúmulo Estrella de Mar","ru":"Скопление Морская звезда"},"NGC 1931":{"name":"The Fly Nebula","ar":"السديم الذبابة","zh":"苍蝇星云","fi":"Kärpässumu","fr":"Nébuleuse de la Mouche","de":"Fliegen-Nebel","ko":"파리 성운","es":"Nebulosa de la Mosca","ru":"Туманность Муха"},"NGC 1952":{"name":"Crab Nebula","ar":"‎سديم السرطان البحري‎","zh":"蟹状星云","fi":"Rapusumu","fr":"Nébuleuse du Crabe","de":"Krabben-Nebel","el":"Νεφέλωμα του Καρκίνου","it":"Nebulosa granchio","ja":"かに星雲","ko":"게 성운","la":"Cancer Nebula","fa":"سحابی خرچنگ","es":"Nebulosa del Cangrejo","ru":"Крабовидная туманность","tr":"Yengeç Bulutsusu","he":"ערפילית הסרטן"},"NGC 1960":{"name":"Pinwheel Cluster","ar":"‎حشد المروحة‎","zh":"风车星团","fi":"Tuulimyllyjoukko","fr":"Amas du Moulinet","de":"Feuerrad-Haufen","it":"Ammasso Girandola","ko":"바람개비 성단","fa":"خوشه فرفره","es":"Cúmulo del Molinillo","ru":"Скопление Вертушка","tr":"Fırıldak Yıldız Kümesi"},"NGC 1973":{"name":"Mermaid\'s Purse Nebula","ar":"‎حشد حقيبة عروس البحر‎","zh":"美人鱼的钱包星云","fi":"Merenneidon käsilaukkusumu","de":"Meerjungfraubörse-Nebel","it":"Nebulosa Borsa delle Sirena","ko":"인어의 지갑 성운","es":"Nebulosa Monedero de Sirena","ru":"Туманность Кошелек русалки"},"NGC 1975":{"name":"Running Man Nebula","ar":"‎‎سديم الرجل الراكض‎‎","zh":"跑步者星云","fi":"Juokseva mies","fr":"Nébuleuse du coureur","de":"Running Man-Nebel","it":"Nebulosa Running Man","ko":"런닝맨 성운","fa":"سحابی مرد دونده","es":"Nebulosa Hombre Corriendo","ru":"Туманность Бегущий человек","tr":"Koşan Adam Bulutsusu"},"NGC 1977":{"name":"Running Man Nebula","ar":"‎‎سديم الرجل الراكض‎‎","zh":"跑步者星云","fi":"Juokseva mies","fr":"Nébuleuse du coureur","de":"Running Man-Nebel","it":"Nebulosa Running Man","ko":"런닝맨 성운","fa":"سحابی مرد دونده","es":"Nebulosa Hombre Corriendo","ru":"Туманность Бегущий человек","tr":"Koşan Adam Bulutsusu"},"NGC 1976":{"name":"Orion Nebula","ar":"‎سديم الجبار‎","zh":"猎户座星云","fi":"Orionin sumu","fr":"Nébuleuse d\'Orion","de":"Orion-Nebel","it":"Nebulosa di Orione","ja":"オリオン星雲","ko":"오리온 성운","la":"Nebula Orionis","fa":"سحابی منظومۀ جبار","es":"Nebulosa de Orión","ru":"Туманность Ориона","tr":"Avcı Bulutsusu","he":"ערפילית אוריון"},"NGC 1980":{"name":"The Lost Jewel of Orion","ar":"‎جوهرة الجبار المفقودة‎","zh":"猎户座遗失宝石","fi":"Orionin kadonnut jalokivi","fr":"Le Joyau perdu d\'Orion","de":"Verlorenes Juwel des Orion","it":"Il Gioiello Perso di Orione","ko":"오리온의 잃어버린 장신구","es":"La joya perdida de Orión","ru":"Потерянный драгоценный камень Ориона"},"NGC 1981":{"name":"Coal Car Cluster","ar":"‎حشد سيارة الفحم‎","zh":"煤车星团","fi":"Hiilivaunujoukko","fr":"Amas du Tender","de":"Kohlewagen-Haufen","it":"Ammasso Macchhina di Carbone","ko":"탄광차 성단","es":"Cúmulo Carro de Carbón","ru":"Скопление Угольный вагон"},"NGC 1982":{"name":"de Mairan\'s Nebula","ar":"‎‎سديم دي ماريان‎‎","zh":"迪马伦星云","fi":"de Mairan’n sumu","fr":"Nébuleuse de de Mairan","de":"de Mairans Nebel","it":"Nebulosa De Mairan","ko":"드 모이란 성운","la":"Nebula de Mairanii","fa":"سحابی دی ماریان","es":"Nebulosa de Mairan\'s","ru":"Туманность де Мэйран","tr":"de Marian\'ın Bulutsusu"},"NGC 1990":{"name":"ε Ori Nebula","ar":"‎‎سديم إبسلون الجبار‎‎","zh":"参宿二星云","fi":"ε Orionis -sumu","fr":"Nébuleuse ε Ori","de":"ε Ori Nebel","it":"Nebulosa ε Ori","ja":"オリオン座ε星雲","ko":"오리온자리 엡실론 성운","fa":"سحابی اپسیلون شکارچی","es":"Nebulosa ε Ori","ru":"Туманность ε Ориона"},"NGC 1999":{"name":"13th Pearl Nebula","ar":"‎سديم اللؤلؤ الثالث عشر‎","zh":"第13珍珠星云","fi":"13. helmisumu","fr":"Nébuleuse de la 13ème perle","de":"Nebel der 13. Perle","it":"Nebulosa 13ma Perla","ko":"13번째 진주 성운","es":"Nebulosa 13ª Perla","ru":"Туманность 13-я жемчужина"},"NGC 2022":{"name":"Kissing Crescents Nebula","ar":"‎سديم الأهلة المتحابة‎","zh":"吻月星云","fi":"Suutelevat sirpit","fr":"Nébuleuse des Croissants qui s\'embrassent","de":"Sichelnebel","it":"Nebulosa Mezzelune Bacianti","ko":"입맞추는 초승달 성운","la":"Nebula osculantium crescentium","es":"Nebulosa Creciente","ru":"Туманность Целующиеся полумесяцы"},"NGC 2024":{"name":"Flame Nebula","ar":"‎‎سديم الشعلة‎‎","zh":"火焰星云","fi":"Liekkisumu","fr":"Nébuleuse de la Flamme","de":"Flammennebel","it":"Nebulosa Fiamma","ko":"화염 성운","la":"Flammae Nebula","fa":"سحابی مشتعل","es":"Nebulosa de la Flama","ru":"Туманность Пламя","he":"ערפילית הלהבה"},"NGC 2060":{"name":"30 Dor B","ar":"0 أبو سيف بي‎","zh":"剑鱼座30","fi":"30 Doradus B","ja":"かじき座30B","ko":"황새치자리 30 B","ru":"30 Золотой Рыбы B"},"NGC 2068":{"name":"Casper the Friendly Ghost Nebula","ar":"‎سديم كاسبر الشبح الودود‎","zh":"鬼马小精灵星云","fi":"Kiltti kummitus Kasper -sumu","fr":"Nébuleuse de Casper le Fantôme","de":"Casper, der freundliche Geist-Nebel","it":"Nebulosa Casper il Fantasma Amichevole","ko":"꼬마유령 캐스퍼 성운","es":"Nebulosa Gasparín","ru":"Туманность Каспер, дружелюбное привидение"},"NGC 2070":{"name":"Tarantula Nebula","ar":"‎‎سديم العنكبوت‎‎","zh":"狼蛛星云","fi":"Tarantulasumu","fr":"Nébuleuse de la Tarentule","de":"Tarantel-Nebel","it":"Nebulosa Taratola","ja":"タランチュラ星雲","ko":"타란툴라 성운","fa":"سحابی رتیل","es":"Nebulosa de la Tarántula","ru":"Туманность Тарантул","tr":"Tarantula Bulutsusu","he":"ערפילית הטרנטולה"},"NGC 2080":{"name":"Ghost Head Nebula","ar":"‎‎سديم رأس الشبح‎‎","zh":"鬼头星云","fi":"Aaveenpääsumu","fr":"Nébuleuse de la Tête de fantôme","de":"Geisterkopf-Nebel","it":"NGC 2080","ko":"유령 머리 성운","la":"Caput spiritus nebula","fa":"سحابی سر روح","es":"Nebulosa Cabeza de Fantasma","ru":"Туманность Голова привидения"},"NGC 2099":{"name":"January Salt-and-Pepper Cluster","ar":"‎حشد ملح وفلفل يناير‎","zh":"一月椒盐星团","fi":"Tammikuun suola- ja pippurijoukko","fr":"Amas Sel-et-Poivre de janvier","de":"Jänner-Salz-und-Pfeffer-Haufen","it":"Ammasso \\t January Salt-and-Pepper","ko":"1월의 소금과 후추 성단","fa":"خوشه نمک و فلفل ژانویه","es":"Cúmulo Sal y Pimienta de Enero","ru":"Скопление Январская проседь"},"NGC 2146":{"name":"Dusty Hand Galaxy","ar":"‎مجرة اليد المغبرة‎","zh":"脏手星系","fi":"Pölyinen käsi","fr":"Galaxie de la Main poussiéreuse","de":"Staubhand-Galaxie","it":"Galassia Mano Polverosa","ko":"더러운 손 은하","es":"Galaxia Mano de Polvo","ru":"Галактика Пыльная рука"},"NGC 2168":{"name":"Shoe-Buckle Cluster","ar":"‎حشدمشبك الحذاء‎","zh":"鞋扣星团","fi":"Kengänsolkijoukko","de":"Schuhschnallen-Haufen","ko":"구두 죔쇠 은하","es":"Cúmulo Hebilla de Zapato","ru":"Скопление Обувная пряжка"},"NGC 2169":{"name":"The 37 Cluster","ar":"‎‎حشد الرقم 37 النجمي‎‎","zh":"37星团","fi":"37-joukko","fr":"Le cluster 37","de":"37er-Haufen","it":"Gruppo 37","ko":"37 성단","la":"Congregatio 37","fa":"خوشه 37","es":"Cúmulo El 37","ru":"Скопление 37"},"NGC 2170":{"name":"Mon R2 IRS3","ar":"‎وحيد القرن آر 2 آي آر إس 3‎","zh":"麒麟座2","fi":"Monocretis R2 IRS3","ko":"외뿔소자리 R2 IRS3","ru":"Единорог R2 IRS3"},"NGC 2174":{"name":"Monkey Head Nebula","ar":"‎‎سديم رأس القرد‎‎","zh":"猴头星云","fi":"Apinanpääsumu","fr":"Nébuleuse de la Tête de singe","de":"Affenkopf-Nebel","it":"Nebulosa Testa di Scimmia","ko":"원숭이 머리 성운","fa":"سحابی سر میمون","es":"Nebulosa cabeza del mono","ru":"Туманность Обезьянья голова","tr":"Maymun Başı Bulutsusu"},"NGC 2194":{"name":"Intergalactic Wanderer","ar":"المتجول بين المجرات","zh":"漫游者星团","fi":"Galaksienvälinen vaeltaja","fr":"Vagabond intergalactique","de":"Intergalaktischer Wanderer","ko":"은하 사이의 방랑자","es":"Vagabundo Intergaláctico","ru":"Межгалактический странник"},"NGC 2419":{"name":"Intergalactic Wanderer","ar":"المتجول بين المجرات","zh":"漫游者星团","fi":"Galaksienvälinen vaeltaja","fr":"Vagabond intergalactique","de":"Intergalaktischer Wanderer","ko":"은하 사이의 방랑자","es":"Vagabundo Intergaláctico","ru":"Межгалактический странник"},"NGC 2232":{"name":"Double Wedge Cluster","ar":"‎حشد الوتد المزدوج‎","zh":"双锥状星团","fi":"Kaksoiskiilajoukko","de":"Doppelkeil-Haufen","ko":"이중 쐐기 성단","es":"Cúmulo Doble Cuña","ru":"Скопление Двойной клин"},"NGC 2237":{"name":"Rosette Nebula","ar":"‎سديم روزيت‎","zh":"玫瑰星云","fi":"Rosettesumu","fr":"Nébuleuse de Rosette","de":"Rosetten-Nebel","el":"Νεφέλωμα Ροζέτα","it":"Nebulosa rosetta","ja":"ばら星雲","ko":"로제타 성운","la":"Rosetta Nebula","fa":"سحابی گل کاغذی","es":"Nebulosa de Roseta","ru":"Туманность Розетка","tr":"Rozet Bulutsusu"},"NGC 2238":{"name":"Rosette Nebula","ar":"‎سديم روزيت‎","zh":"玫瑰星云","fi":"Rosettesumu","fr":"Nébuleuse de Rosette","de":"Rosetten-Nebel","el":"Νεφέλωμα Ροζέτα","it":"Nebulosa rosetta","ja":"ばら星雲","ko":"로제타 성운","la":"Rosetta Nebula","fa":"سحابی گل کاغذی","es":"Nebulosa de Roseta","ru":"Туманность Розетка","tr":"Rozet Bulutsusu"},"NGC 2244":{"name":"Rosette Nebula","ar":"‎سديم روزيت‎","zh":"玫瑰星云","fi":"Rosettesumu","fr":"Nébuleuse de Rosette","de":"Rosetten-Nebel","el":"Νεφέλωμα Ροζέτα","it":"Nebulosa rosetta","ja":"ばら星雲","ko":"로제타 성운","la":"Rosetta Nebula","fa":"سحابی گل کاغذی","es":"Nebulosa de Roseta","ru":"Туманность Розетка","tr":"Rozet Bulutsusu"},"NGC 2246":{"name":"Rosette Nebula","ar":"‎سديم روزيت‎","zh":"玫瑰星云","fi":"Rosettesumu","fr":"Nébuleuse de Rosette","de":"Rosetten-Nebel","el":"Νεφέλωμα Ροζέτα","it":"Nebulosa rosetta","ja":"ばら星雲","ko":"로제타 성운","la":"Rosetta Nebula","fa":"سحابی گل کاغذی","es":"Nebulosa de Roseta","ru":"Туманность Розетка","tr":"Rozet Bulutsusu"},"Sh2 275":{"name":"Rosette Nebula","ar":"‎سديم روزيت‎","zh":"玫瑰星云","fi":"Rosettesumu","fr":"Nébuleuse de Rosette","de":"Rosetten-Nebel","el":"Νεφέλωμα Ροζέτα","it":"Nebulosa rosetta","ja":"ばら星雲","ko":"로제타 성운","la":"Rosetta Nebula","fa":"سحابی گل کاغذی","es":"Nebulosa de Roseta","ru":"Туманность Розетка","tr":"Rozet Bulutsusu"},"DWB 26":{"name":"Rosette Nebula","ar":"‎سديم روزيت‎","zh":"玫瑰星云","fi":"Rosettesumu","fr":"Nébuleuse de Rosette","de":"Rosetten-Nebel","el":"Νεφέλωμα Ροζέτα","it":"Nebulosa rosetta","ja":"ばら星雲","ko":"로제타 성운","la":"Rosetta Nebula","fa":"سحابی گل کاغذی","es":"Nebulosa de Roseta","ru":"Туманность Розетка","tr":"Rozet Bulutsusu"},"NGC 2261":{"name":"Hubble\'s Variable Nebula","ar":"‎سديم هابل المتغير‎","zh":"哈勃变光星云","fi":"Hubblen muuttuva sumu","fr":"Nébuleuse variable de Hubble","de":"Hubbles Veränderlicher Nebel","it":"Nebulosa variabile di Hubble","ja":"ハッブル変光星雲","ko":"허블의 변광 성운","la":"Nebula Hubblei Variabilis","es":"Nebulosa variable de Hubble","ru":"Переменная туманность Хаббла","tr":"Hubble\'ın Değişken Bulutsusu"},"NGC 2264":{"name":"Fox Fur Nebula","ar":"‎سديم فرو الثعلب‎","zh":"狐皮星云","fr":"Nébuleuse de la Fourrure de Renard","de":"Fuchsfell-Nebel","it":"Nebulosa Pelliccia di Volpe","ko":"여우털 성운","es":"Nebulosa Pelaje de Zorro","ru":"Туманность Лисий мех"},"NGc 2269":{"name":"Head Hunter Cluster","ar":"‎حشد الباحث عن الموهوبين‎","zh":"猎头星团","fi":"Pääkallonmetsästäjäjoukko","fr":"Amas de la Tête du chasseur","de":"Kopfjäger-Haufen","it":"Ammasso Cacciatore di Teste","ko":"머리 사냥꾼 성단","es":"Cúmulo Cazador de Cabeza","ru":"Скопление Охотник за головами"},"NGC 2281":{"name":"Broken Heart Cluster","ar":"‎حشد القلب المكسور‎","zh":"碎心星团","fi":"Särkynyt sydän","fr":"Amas du Coeur brisé","de":"Gebrochenes-Herz-Haufen","it":"Ammasso Cuore Spezzato","ko":"부서진 하트 성단","es":"Cúmulo Corazón Roto","ru":"Скопление Разбитое сердце","tr":"Kırık Kalp Yıldız Kümesi"},"NGC 2287":{"name":"Little Beehive Cluster","ar":"‎حشد الخلية الصغيرة‎","zh":"小蜂巢星团","fi":"Pieni mehiläispesäjoukko","fr":"Amas du petit Rucher","de":"Kleiner Bienenkorb-Haufen","it":"Ammasso Piccolo Alveare","ko":"작은 벌집 성단","es":"Cúmulo de la Pequeña Colmena","ru":"Скопление Малый улей"},"NGC 2301":{"name":"Hagrid\'s Dragon Cluster","ar":"‎حشد تنين هاجريد‎","zh":"海格的龙星团","fi":"Hagridin lohikäärme","fr":"Amas du Dragon de Hagrid","de":"Hagrids Drachen-Haufen","it":"Ammasso Drago di Hagrid","ko":"해그리드의 용 성단","la":"Congregatio Draconis Hagridi","es":"Cúmulo Dragón de Hagrid","ru":"Скопление Дракон Хагрида"},"NGC 2323":{"name":"Heart-Shaped Cluster","ar":"‎‎حشد شكل القلب‎‎","zh":"心状星团","fi":"Sydänjoukko","fr":"Amas en forme de Cœur","de":"Herzförmiger Haufen","it":"Ammasso Heart-Shaped","ko":"하트 모양 성단","la":"Congregatio cordiforma","fa":"سحابی قلبی شکل","es":"Cúmulo Forma de Corazón","ru":"Сердцеобразное скопление"},"NGC 2343":{"name":"Doublemint Cluster","ar":"‎حشد النعناع المزدوج‎","zh":"箭头星团","fi":"Doublemint-joukko","de":"Doublemint-Haufen","ko":"더블민트 성단","es":"Cúmulo del Doblete","ru":"Скопление Двойная мята"},"NGC 2346":{"name":"Butterfly Nebula","ar":"‎سديم الفراشة‎","zh":"蝴蝶星云","fi":"Perhossumu","fr":"Nébuleuse du papillon","de":"Schmetterling-Nebel","el":"Νεφέλωμα Πεταλούδα","it":"Nebulosa farfalla","ja":"バタフライ星雲","ko":"나비 성운","fa":"سحابی پروانه‌ای","es":"Nebulosa de la Mariposa","ru":"Туманность Бабочка","tr":"Kelebek Bulutsusu"},"NGC 2353":{"name":"Avery\'s Island","ar":"‎جزيرة أفيري‎","zh":"艾弗里岛星团","fi":"Averyn saari","de":"Averys Insel","ko":"에이버리의 섬","es":"Isla de Avery","ru":"Остров Эйвери"},"NGC 2359":{"name":"Thor\'s Helmet","ar":"‎‎خوذة تور‎‎","zh":"雷神的头盔","fi":"Thorin kypärä","fr":"Casque de Thor","de":"Thors Helm","it":"Elmo di Thor","ko":"토르의 헬멧","la":"Galea Thori","fa":"سحابی کلاه خود ثور","es":"Casco de Thor","ru":"Шлем Тора"},"NGC 2360":{"name":"Caroline\'s Cluster","ar":"‎‎حشد كارولين‎‎","zh":"卡罗琳星团","fi":"Carolinen joukko","fr":"Amas de Caroline","de":"Carolines Haufen","it":"Amasso Caroline","ko":"캐롤라인의 성단","la":"Congregatio Carolinae","fa":"خوشه کارولین","es":"Cúmulo de Carolina","ru":"Скопление Каролины","tr":"Karolin\'in Yıldız Kümesi"},"NGC 2362":{"name":"τ CMa Cluster","ar":"‎حشد تاو الكلب الأكبر‎","zh":"弧矢增六星团","fi":"τ CMa -joukko","fr":"Amas τ CMa","de":"τ CMa Haufen","it":"Ammasso τ CMa","ja":"おおいぬ座τ星団","ko":"큰개자리 타우 성단","es":"Cúmulo τ CMa","ru":"Скопление τ Малого Пса"},"NGC 2367":{"name":"Charlie Brown\'s Christmas Tree","ar":"‎شجرة كريسمس تشارلي براون‎","zh":"查理·布朗的圣诞树","fi":"Jaska Jokusen joulukuusi","de":"Charlie Browns Weihnachtsbaum","ja":"チャーリーブラウンのクリスマスツリー","ko":"찰리 브라운의 크리스마스 트리","es":"Árbol de Navidad de Charlie Brown","ru":"Рождественское дерево Чарли Брауна","tr":"Charlie Brown\'un Yılbaşı Ağacı"},"NGC 2371":{"name":"Gemini Nebula","ar":"‎‎سديم التوأمين‎‎","zh":"双子座星云","fi":"Kaksosten sumu","fr":"Nébuleuse des Gémeaux","de":"Gemini-Nebel","ko":"쌍둥이 성운","fa":"سحابی دوپیکر","es":"Nebulosa Gemini","ru":"Туманность Близнецов","tr":"İkizler Bulutsusu"},"NGC 2392":{"name":"Eskimo Nebula","ar":"‎سديم الاسكيمو‎","zh":"爱斯基摩星云","fi":"Eskimosumu","fr":"Nébuleuse Eskimo","de":"Eskimo-Nebel","el":"Νεφέλωμα Εσκιμώος","it":"Nebulosa Eskimo","ja":"エスキモー星雲","ko":"에스키모 성운","la":"Nebula Piscivori","fa":"سحابی اسکیمو","es":"Nebulosa Esquimal","ru":"Туманность Эскимос","tr":"Eskimo Bulutsusu"},"NGC 2409":{"name":"Firsse 213","ar":"‎فيرسي 213‎","zh":"菲尔瑟213","ko":"FIRSEE 213","ru":"Фирссе 213"},"NGC 2420":{"name":"Twinkling Comet Cluster","ar":"‎حشد المذنب المتلأليء‎","zh":"彗闪星团","fi":"Tuikkiva komeetta","fr":"Amas de la Comète scintillante","de":"Blinkender Komet-Haufen","it":"Ammasso Cometa Scintillande","ko":"반짝이는 혜성 성단","es":"Cúmulo del Cometa Brillante","ru":"Скопление Мерцающая комета"},"NGC 2439":{"name":"Bold Arrow Cluster","ar":"حشد السهم السميك","zh":"宽箭头星团","de":"Dicker-Pfeil-Haufen","it":"Ammasso Freccia in Grassetto","es":"Cúmulo Flecha Negra","ru":"Скопление Жирная стрелка"},"NGC 2440":{"name":"Albino Butterfly Nebula","ar":"‎سديم فراشة ألبينو‎","zh":"白蝴蝶星云","fi":"Albiinoperhossumu","fr":"Nébuleuse du Papillon albinos","de":"Albino-Schmetterlings-Nebel","it":"Nebulosa Farfalla Albina","ko":"백색증 나비 성운","es":"Nebulosa de la Mariposa Albina","ru":"Туманность Бабочка-альбинос"},"NGC 2442":{"name":"Meathook Galaxy","ar":"‎مجرّة معلاق اللحم‎","zh":"肉钩星系","fi":"Lihakoukkugalaksi","de":"Fleischerhaken-Galaxie","ko":"정육 갈고리 은하","es":"Galaxia del Gancho Carnicero","ru":"Галактика Мясной крюк"},"NGC 2447":{"name":"Butterfly Cluster","ar":"‎تجمع الفراشة‎","zh":"蝴蝶星团","fi":"Perhosjoukko","fr":"Amas du Papillon","de":"Schmetterling-Haufen","el":"Σμήνος Πεταλούδα","it":"Ammasso farfalla","ja":"バタフライ星団","ko":"나비 성단","fa":"خوشۀ پروانه‌ای","es":"Cúmulo Mariposa","ru":"Скопление Бабочка","tr":"Kelebek Kümesi"},"NGC 6405":{"name":"Butterfly Cluster","ar":"‎تجمع الفراشة‎","zh":"蝴蝶星团","fi":"Perhosjoukko","fr":"Amas du Papillon","de":"Schmetterling-Haufen","el":"Σμήνος Πεταλούδα","it":"Ammasso farfalla","ja":"バタフライ星団","ko":"나비 성단","fa":"خوشۀ پروانه‌ای","es":"Cúmulo Mariposa","ru":"Скопление Бабочка","tr":"Kelebek Kümesi","he":"צביר הפרפר"},"NGC 2451":{"name":"Stinging Scorpion Cluster","ar":"‎حشد العقرب اللادغ‎","zh":"刺蝎星团","fi":"Pistävä skorpioni","fr":"Amas du Scorpion qui pique","de":"Stechender Skorpion-Haufen","it":"Ammasso Scorpione Pungente","ko":"쐐기 전갈 성단","es":"Cúmulo del Escorpión Ortigante","ru":"Скопление Жалящий скорпион"},"NGC 2467":{"name":"Skull and Crossbones Nebula","ar":"‎‎سديم الجمجمة والعظمتين المتقاطعتين‎‎","zh":"骷髅头星云","fi":"Pääkallo ja reisiluut","fr":"Nébuleuse de la Tête de mort","de":"Totenkopf-Nebel","it":"Skull Nebula","ko":"두개골과 대퇴골 성운","fa":"سحابی کله اسکلت و استخوان صلیبی","es":"Nebulosa de Calabera y Tibias Cruzadas","ru":"Туманность Череп и скрещенные кости"},"NGC 2477":{"name":"Electric Guitar Cluster","ar":"‎‎حشد الجيتار الكهربائي‎‎","zh":"电吉他星团","fi":"Sähkökitarajoukko","fr":"Amas de la Guitare électrique","de":"E-Gitarren-Haufen","it":"Cluster Electric Guitar","ko":"전자 기타 성단","fa":"خوشه گیتار الکتریک","es":"Cúmulo Guitarra Eléctrica","ru":"Скопление Электрогитара","tr":"Elektrik Gitar Yıldız Kümesi"},"NGC 2516":{"name":"Diamond Cluster","ar":"‎حشد الألماس‎","zh":"钻石星团","fi":"Timanttijoukko","fr":"Amas du Diamant","de":"Diamanten-Haufen","it":"Ammasso Diamante","ko":"다이아몬드 성단","es":"Cúmulo del Diamante","ru":"Скопление Бриллиант","tr":"Elmas Yıldız Kümesi"},"NGC 2537":{"name":"Bear\'s Paw Galaxy","ar":"‎‎مجرة مخالب الدب‎‎","zh":"熊掌星系","fi":"Karhunkäpäläsumu","fr":"Galaxie de la Patte d\'ours","de":"Bärentatzen-Galaxie","it":"Galassia Zampa d\'Orso","ko":"곰 발 은하","fa":"کهکشان پنجه خرس","es":"Galaxia Garra del Oso","ru":"Галактика Медвежья лапа"},"NGC 2539":{"name":"The Dish Cluster","ar":"‎حشد الطبق‎","zh":"盘状星团","fi":"Vatijoukko","fr":"Amas du Plat","de":"Schüssel-Haufen","it":"Ammasso Il Piatto","ko":"그릇 성단","es":"Cúmulo del Plato","ru":"Скопление Блюдо"},"NGC 2546":{"name":"Heart and Dagger Cluster","ar":"‎حشد القلب والخنجر‎","zh":"心与匕首星团","fi":"Sydän ja tikari","fr":"Amas Coeur et Poignard","de":"Herz-und-Dolch-Haufen","it":"Ammasso Cuore e Pugnale","ko":"심장과 단검 성단","es":"Cúmulo Corazón y Daga","ru":"Скопление Сердце и кинжал"},"NGC 2547":{"name":"Golden Earring Cluster","ar":"‎حشد القرط الذهبي‎","zh":"金耳环星团","fi":"Kultainen korvarengas","de":"Goldohrring-Haufen","ko":"금귀걸이 성단","es":"Cúmulo Pendiente Dorado","ru":"Скопление Золотая серьга"},"NGC 2557":{"name":"Malus Cluster","ar":"‎حشد مالوس‎","zh":"马吕斯星系团","fi":"Maston joukko","de":"Malus-Haufen","ko":"말루스 성단","es":"Cúmulo Malus","ru":"Скопление Малус"},"NGC 2573":{"name":"Polarissima Australis","ar":"‎‎بولاريسيما الجنوبية‎‎","zh":"南极星系","el":"Όμορος του Νότιου Πόλου","he":"פולריסימה אוסטרליס","it":"Polarissima Australe","ja":"南極銀河","ko":"남쪽의 폴라리시마","hi":"पोलारिसीमा ऑस्ट्रालिस","fa":"ستارۀ قطبی جنوبی","es":"Del Polo austral","ru":"Поляриссима Аустралис"},"NGC 2632":{"name":"Praesepe","ar":"‎‎النثرة‎‎","zh":"鬼星团","fi":"Mehiläispesäjoukko","fr":"la Crèche","de":"Krippe","el":"Σμήνος Φάτνη","he":"פרספה","it":"Presepe","ja":"プレセペ","ko":"프레세페","fa":"پری سی پی","es":"El Pesebre","ru":"Ясли","tr":"Arıkovanı kümesi"},"NGC 2682":{"name":"Golden-Eye Cluster","ar":"‎حشد العين الذهبية‎","zh":"金眼星团","fi":"Kultainen silmä","de":"Golden-Eye-Haufen","ko":"흰뺨오리 성단","es":"Cúmulo Ojo Dorado","ru":"Скопление Золотой глаз"},"NGC 2683":{"name":"UFO Galaxy","ar":"‎حشد الطبق الطائر‎","zh":"星系","fi":"Ufo-galaksi","fr":"Galaxie OVNI","de":"UFO-Galaxie","it":"Galassia UFO","ko":"UFO 은하","es":"Galaxia OVNI","ru":"Галактика НЛО"},"NGC 2685":{"name":"Helix Galaxy","ar":"‎مجرة هيلكس‎","zh":"螺旋星系","fi":"Helix-galaksi","fr":"Galaxie d\'Hélix","de":"Spiralen-Galaxie","el":"Γαλαξίας του Έλικα","it":"Galassia Elica","ja":"らせん銀河","ko":"나사 은하","la":"Helix Galaxia","fa":"کهکشان مارپیچ","es":"Galaxia Hélice","ru":"Галактика Улитка","tr":"Helis Gökadası"},"NGC 2686":{"name":"Spindle Galaxy","ar":"‎مجرة المغزل‎","zh":"纺锤星系","fi":"Värttinägalaksi","fr":"Galaxie du Fuseau","de":"Spindel-Galaxie","el":"Γαλαξίας Ατράκτου","it":"Galassia fuso","ja":"紡錘銀河","ko":"방추 은하","fa":"کهکشان دوکی","es":"Galaxia del Huso","ru":"Галактика Веретено","tr":"Mil Gökadası"},"NGC 3115":{"name":"Spindle Galaxy","ar":"‎مجرة المغزل‎","zh":"纺锤星系","fi":"Värttinägalaksi","fr":"Galaxie du Fuseau","de":"Spindel-Galaxie","el":"Γαλαξίας Ατράκτου","it":"Galassia fuso","ja":"紡錘銀河","ko":"방추 은하","fa":"کهکشان دوکی","es":"Galaxia del Huso","ru":"Галактика Веретено","tr":"Mil Gökadası"},"NGC 5866":{"name":"Spindle Galaxy","ar":"‎مجرة المغزل‎","zh":"纺锤星系","fi":"Värttinägalaksi","fr":"Galaxie du Fuseau","de":"Spindel-Galaxie","el":"Γαλαξίας Ατράκτου","it":"Galassia fuso","ja":"紡錘銀河","ko":"방추 은하","fa":"کهکشان دوکی","es":"Galaxia del Huso","ru":"Галактика Веретено","tr":"Mil Gökadası"},"NGC 2736":{"name":"Pencil Nebula","ar":"‎‎سديم المرسمة‎‎","zh":"铅笔星云","fi":"Lyijykynäsumu","fr":"Nébuleuse du Crayon","de":"Bleistift-Nebel","it":"Nebulosa Matita","ko":"연필 성운","fa":"سحابی مداد","es":"Nebulosa del lápiz","ru":"Туманность Карандаш"},"NGC 2769":{"name":"NGC 2769 Group","ar":"‎مجموعة إن جي سي 2769‎","zh":"2769星系群","fi":"NGC 2769 -ryhmä","fr":"Groupe NGC 2769","de":"NGC 2769-Gruppe","it":"Gruppo NGC 2769","ja":"NGC2769銀河群","ko":"NGC 2769 은하단","es":"Grupo NGC 2769","ru":"Группа NGC 2769"},"NGC 2770":{"name":"Supernova Factory","ar":"‎‎مصنع المستعرات العظيمة‎‎","zh":"超新星工厂星系","fi":"Supernovatehdas","fr":"L\'Usine à Supernovae","de":"Supernova-Fabrik","it":"Fabbrica di supernova","ja":"超新星工場","ko":"초신성 공장","la":"Fabrica supernovarum","fa":"کارخانه ابر نواختر","es":"Fábrica de Supernovas","ru":"Фабрика сверхновых"},"NGC 2841":{"name":"Tiger\'s Eye Galaxy","ar":"‎مجرة عين النمر‎","zh":"虎眼星系","fi":"Tiikerinsilmägalaksi","fr":"Galaxie de l\'Oeil du Tigre","de":"Tigeraugen-Galaxie","it":"Galassia Occhio di Tigre","ja":"虎の目銀河","ko":"호랑이 눈 은하","la":"Oculus Tigris Galaxia","es":"Galaxia Ojo de Tigre","ru":"Галактика Глаз тигра"},"NGC 2936":{"name":"The Penguin Galaxy","ar":"‎مجرة البطريق‎","zh":"企鹅星系","fi":"Pingviinigalaksi","fr":"Galaxie du Pingouin","de":"Pinguin-Galaxie","it":"Galassia Pinguino","ja":"ペンギン銀河","ko":"펭귄 은하","es":"Galaxia del Pingüino","ru":"Галактика Пингвин"},"NGC 2937":{"name":"The Egg Galaxy","ar":"‎مجرة البيضة‎","zh":"蛋星系","fi":"Munagalaksi","fr":"Galaxie de l\'Oeuf","de":"Ei-Galaxie","it":"Galassia Uovo","ko":"달걀 은하","es":"Galaxia del Huevo","ru":"Галактика Яйцо"},"NGC 3031":{"name":"Bode\'s Galaxy","ar":"‎مجرة بود‎","zh":"波德星系","fi":"Boden galaksi","fr":"Galaxie de Bode","de":"Bodes Galaxie","el":"Γαλαξίας του Μπόντε","it":"Galassia di Bode","ja":"ボーデの銀河","ko":"보데의 은하","la":"Galaxia Bodei","fa":"کهکشان بود","es":"Galaxia Bode","ru":"Галактика Боде","tr":"Bode\'nin Gökadası","he":"גלקסיית בודה"},"NGC 3034":{"name":"Cigar Galaxy","ar":"‎‎مجرة السيجار‎‎","zh":"雪茄星系","fi":"Sikarigalaksi","fr":"Galaxie du Cigare","de":"Zigarrengalaxie","el":"Γαλαξίας Πούρο","it":"Galassia Sigaro","ja":"葉巻銀河","ko":"시가 은하","la":"Galaxia Cigarriforma","fa":"کهکشان سیگار","es":"Galaxia del Cigarro","ru":"Галактика Сигара","he":"גלקסיית הסיגר"},"NGC 3077":{"name":"The Garland Galaxy","ar":"‎مجرة جارلاند‎","zh":"花环星系","fi":"Seppelegalaksi","fr":"Galaxie Garland","de":"Garland-Galaxie","it":"Galassia Ghirlanda","ko":"갈런드 은하","es":"Galaxia Guirnalda","ru":"Галактика Гирлянда"},"PGC 29167":{"name":"The Garland Galaxy","ar":"‎مجرة جارلاند‎","zh":"花环星系","fi":"Seppelegalaksi","fr":"Galaxie Garland","de":"Garland-Galaxie","it":"Galassia Ghirlanda","ko":"갈런드 은하","es":"Galaxia Guirnalda","ru":"Галактика Гирлянда"},"NGC 3079":{"name":"The Phantom Frisbee Galaxy","ar":"‎مجرة الفريزبي الشبح‎","zh":"幻影飞碟星系","fi":"Haamufrisbeegalaksi","fr":"Galaxie du Frisbee fantôme","de":"Phantom-Frisbee-Galaxie","it":"Galassia Frisbee Fantasma","ko":"프리스비의 환영 은하","es":"Galaxia del Frisbee Fantasma","ru":"Галактика Фантомный фрисби"},"NGC 3114":{"name":"Hand Cluster","ar":"حشد اليد","zh":"手状星团","de":"Hand-Haufen","it":"Ammasso Mano","es":"Cúmulo Mano","ru":"Скопление Рука"},"NGC 3132":{"name":"Eight-Burst Planetary Nebula","ar":"‎سديم الإنفجارات الثمانية الكوكبي‎","zh":"双环星云","fi":"Kahdeksan purkauksen planetaarinen","fr":"Nébuleuse planétaire des Huit-Poussées","de":"Südlicher Ringnebel","it":"Nebulosa Planetaria Eight-Burst","ko":"8중 폭발 행성상 성운","fa":"سحابی سیاره نمای انفجار هشتی","es":"Nebulosa Planetaria Ocho Estallidos","ru":"Планетарная туманность Восьмёрка"},"NGC 3172":{"name":"Polarissima Borealis","ar":"‎‎بولاريسيما الشمالية‎‎","zh":"北极星系","el":"Όμορος του Βόρειου Πόλου","he":"פולריסימה בוריאליס","it":"Polarissima Boreale","ja":"北極銀河","ko":"북쪽의 폴라리시마","hi":"पोलारिसिमा बोरेआलिस","fa":"ستارۀ قطبی شمالی","es":"Del Polo boreal","ru":"Поляриссима Бореалис"},"NGC 3180":{"name":"Little Pinwheel Galaxy","ar":"‎مجرة المروحة الصغيرة‎","zh":"小风车星系","fi":"Pieni tuulimyllygalaksi","fr":"Galaxie du petit Moulinet","de":"Kleine Feuerrad-Galaxie","it":"Galassia Piccola Pinza","ko":"작은 바람개비 은하","es":"Galaxia del Pequeño Molinillo","ru":"Галактика Малая вертушка"},"NGC 3185":{"name":"Leo Quartet","ar":"‎رباعية ليو‎","zh":"狮子座四重星系","fi":"Leijonan kvartetti","de":"Leo Quartett","ko":"사자자리 사중주","es":"Cuarteto de Leo","ru":"Квартет Льва"},"NGC 3187":{"name":"Leo Quartet","ar":"‎رباعية ليو‎","zh":"狮子座四重星系","fi":"Leijonan kvartetti","de":"Leo Quartett","ko":"사자자리 사중주","es":"Cuarteto de Leo","ru":"Квартет Льва"},"NGC 3193":{"name":"Leo Quartet","ar":"‎رباعية ليو‎","zh":"狮子座四重星系","fi":"Leijonan kvartetti","de":"Leo Quartett","ko":"사자자리 사중주","es":"Cuarteto de Leo","ru":"Квартет Льва"},"NGC 3189":{"name":"NGC 3190 Group","ar":"‎مجموعة إن جي سي 3190‎","zh":"3190星系群","fi":"NGC 3190 -ryhmä","fr":"Groupe NGC 3190","de":"NGC 3190-Gruppe","ja":"NGC3190銀河群","ko":"NGC 3190 은하단","es":"Grupo NGC 3190","ru":"Группа NGC 3190"},"NGC 3228":{"name":"Queen\'s Cache Cluster","ar":"‎حشد خزانة الملكة‎","zh":"女王的私藏星团","fi":"Kuningattaren kätkö","de":"Königinnenschatz-Haufen","ko":"여왕의 은닉처 성단","es":"Cúmulo Escondite de la Reina","ru":"Скопление Кэш королевы"},"NGC 3242":{"name":"Ghost of Jupiter Nebula","ar":"‎سديم شبح المشتري‎","zh":"木魂星云","fi":"Jupiterin haamu","fr":"Nébuleuse du Fantôme de Jupiter","de":"Jupiters Geist-Nebel","it":"Nebulosa Fantasma di Giove","ja":"木星状星雲","ko":"목성의 유령 성운","la":"Spiritus Jovis Nebula","fa":"سحابی شبح ژوپیتر","es":"Nebulosa del Fantasma de Júpiter","ru":"Туманность Призрак Юпитера"},"NGC 3293":{"name":"Gem Cluster","ar":"‎حشد الجوهرة‎","zh":"宝石星团","fi":"Jalokivijoukko","fr":"Amas de Gem","de":"Edelstein-Haufen","it":"Ammasso gemma","ko":"보석 성단","es":"Cúmulo de Gemas","ru":"Скопление Жемчужина"},"NGC 3324":{"name":"Keyhole Nebula","ar":"‎سديم ثقب المفتاح‎","zh":"钥匙孔星云","fi":"Avaimenreikäsumu","fr":"Nébuleuse du Trou de serrure","de":"Schlüsselloch-Nebel","it":"Nebulosa Bucco della Serratura","ja":"キーホール星雲","ko":"열쇠구멍 성운","es":"Nebulosa Ojo de Cerradura","ru":"Туманность Замочная скважина"},"NGC 3344":{"name":"Sliced Onion Galaxy","ar":"‎مجرة شرائح البصل‎","zh":"洋葱切片星系","fi":"Sipuliviipalegalaksi","fr":"Galaxie de l\'Onion coupé","de":"Zwiebelscheiben-Galaxie","it":"Galassia Fetta di Cipolla","ko":"양파조각 은하","es":"Galaxia Cebolla Rebanada","ru":"Галактика Нарезанный лук"},"NGC 3372":{"name":"η Car Nebula","ar":"‎‎سديم إيتا كارينا‎‎","zh":"船底座星云","fi":"η Carinae -sumu","fr":"Nébuleuse η Car","de":"η Car Nebel","it":"Nebulosa η Car","ja":"エータ・カリーナ星雲","ko":"용골자리 에타 성운","fa":"سحابی اتومبیل اتا","es":"Nebulosa de η Car","ru":"Туманность η Киля","he":"ערפילית שדרית"},"NGC 3432":{"name":"Knitting Needle Galaxy","ar":"‎مجرة إبرة الغزل‎","zh":"编制针星系","fi":"Sukkapuikkogalaksi","fr":"Galaxie de l\'Aiguille à tricoter","de":"Stricknadel-Galaxie","it":"Galassia Ferri da Maglia","ko":"뜨개질바늘 은하","es":"Galaxia Aguja de Tejer","ru":"Галактика Вязальная спица"},"NGC 3532":{"name":"Wishing Well Cluster","ar":"‎‎حشد بئر الأمنيات‎‎","zh":"许愿井星团","fi":"Toivomuskaivojoukko","fr":"Amas des Bons vœux","de":"Wünschelbrunnen-Haufen","it":"Ammasso Pozzo dei desideri","ko":"소원을 비는 우물 성단","fa":"خوشه چشمه آرزو","es":"Cúmulo Deseando Bien","ru":"Скопление Колодец желаний"},"NGC 3556":{"name":"Surfboard Galaxy","ar":"‎‎مجرة لوح الأمواج‎‎","zh":"冲浪板星系","fi":"Surffilautagalaksi","fr":"Galaxie de la Planche de surf","de":"Surfboard-Galaxie","it":"Galassia Tavola da Surf","ko":"서핑보드 은하","fa":"کهکشان تخته اسکی روی آب","es":"Galaxia Tabla de Surf","ru":"Галактика Доска для серфинга"},"NGC 3561":{"name":"Ambartsumian\'s Knot","ar":"‎‎مجرة عقدة أمبارتسوميا القزمة‎‎","zh":"安巴楚勉之结","fi":"Ambartsumianin solmu","fr":"Noeud d\'Ambartsumian","de":"Ambartsumians Knoten","it":"Nodo di Ambartsumian","ko":"암바트수미안의 매듭","la":"Nodus Ambartsumiani","fa":"گره آمبارتسومیان","es":"Nudo de Ambartsumian","ru":"Узел Амбарцумяна"},"NGC 3576":{"name":"Statue of Liberty Nebula","ar":"‎سديم تمثال الحرية‎","zh":"自由女神星云","fi":"Vapaudenpatsassumu","fr":"Nébuleuse de la Statue de la Liberté","de":"Freiheitsstatuen-Nebel","it":"Nebulosa  Statua della Libertà","ko":"자유의 여신상 성운","es":"Nebulosa Estatua de la Libertad","ru":"Туманность Статуя свободы"},"NGC 3587":{"name":"Owl Nebula","ar":"‎سديم البومة‎","zh":"夜枭星云","fi":"Pöllösumu","fr":"Nébuleuse de la Chouette","de":"Eulen-Nebel","el":"Νεφέλωμα της Γλαυκός","it":"Nebulosa Gufo","ja":"ふくろう星雲","ko":"올빼미 성운","fa":"سحابی جغد","es":"Nebulosa de la Lechuza","ru":"Туманность Сова","tr":"Baykuş Bulutsusu","he":"ערפילית הינשוף"},"NGC 3621":{"name":"Frame Galaxy","ar":"‎مجرة الإطار‎","zh":"眼镜框星系","fi":"Kehysgalaksi","fr":"Galaxie du Cadre","de":"Gestell-Galaxie","it":"Galassia Telaio","ko":"뼈대 은하","es":"Galaxia Marco","ru":"Галактика Рама"},"NGC 3623":{"name":"Leo Triplet","ar":"‎‎ثلاثية الأسد‎‎","zh":"狮子座三重星系","fi":"Leijonan kolmikko","fr":"Triplet du Lion","de":"Leo Triplett","it":"Gemello del Leone","ko":"사자자리 삼중주","fa":"کهکشان سه گانه برج اسد","es":"Trío de Leo","ru":"Триплет Льва"},"NGC 3627":{"name":"Leo Triplet","ar":"‎‎ثلاثية الأسد‎‎","zh":"狮子座三重星系","fi":"Leijonan kolmikko","fr":"Triplet du Lion","de":"Leo Triplett","it":"Gemello del Leone","ko":"사자자리 삼중주","fa":"کهکشان سه گانه برج اسد","es":"Trío de Leo","ru":"Триплет Льва"},"NGC 3628":{"name":"Hamburger Galaxy","ar":"‎‎مجرة الهامبرجر‎‎","zh":"汉堡星系","fi":"Hampurilaisgalaksi","fr":"Galaxie du Hamburger","de":"Hamburger-Galaxie","it":"Galassia Hamburger","ja":"ハンバーガー銀河","ko":"햄버거 은하","fa":"کهکشان همبرگر","es":"Galaxia Hamburguesa","ru":"Галактика Гамбургер"},"NGC 3745":{"name":"Copeland\'s Septet","ar":"‎‎سباعية كوبلاند‎‎","zh":"科普兰七重星系","fi":"Copelandin seitsikko","fr":"Septet de Copeland","de":"Copeland-Septett","el":"Η Επτάδα του Κόουπλαντ","it":"Settetto di Copeland","ja":"コープランドの七つ子","ko":"코프랜드의 칠중주","fa":"هفت قلوی کوپ لند","es":"Septeto de Coperland","ru":"Септет Коупленда","tr":"Copeland\'s Yedilisi"},"NGC 3746":{"name":"Copeland\'s Septet","ar":"‎‎سباعية كوبلاند‎‎","zh":"科普兰七重星系","fi":"Copelandin seitsikko","fr":"Septet de Copeland","de":"Copeland-Septett","el":"Η Επτάδα του Κόουπλαντ","it":"Settetto di Copeland","ja":"コープランドの七つ子","ko":"코프랜드의 칠중주","fa":"هفت قلوی کوپ لند","es":"Septeto de Coperland","ru":"Септет Коупленда","tr":"Copeland\'s Yedilisi"},"NGC 3748":{"name":"Copeland\'s Septet","ar":"‎‎سباعية كوبلاند‎‎","zh":"科普兰七重星系","fi":"Copelandin seitsikko","fr":"Septet de Copeland","de":"Copeland-Septett","el":"Η Επτάδα του Κόουπλαντ","it":"Settetto di Copeland","ja":"コープランドの七つ子","ko":"코프랜드의 칠중주","fa":"هفت قلوی کوپ لند","es":"Septeto de Coperland","ru":"Септет Коупленда","tr":"Copeland\'s Yedilisi"},"NGC 3750":{"name":"Copeland\'s Septet","ar":"‎‎سباعية كوبلاند‎‎","zh":"科普兰七重星系","fi":"Copelandin seitsikko","fr":"Septet de Copeland","de":"Copeland-Septett","el":"Η Επτάδα του Κόουπλαντ","it":"Settetto di Copeland","ja":"コープランドの七つ子","ko":"코프랜드의 칠중주","fa":"هفت قلوی کوپ لند","es":"Septeto de Coperland","ru":"Септет Коупленда","tr":"Copeland\'s Yedilisi"},"NGC 3751":{"name":"Copeland\'s Septet","ar":"‎‎سباعية كوبلاند‎‎","zh":"科普兰七重星系","fi":"Copelandin seitsikko","fr":"Septet de Copeland","de":"Copeland-Septett","el":"Η Επτάδα του Κόουπλαντ","it":"Settetto di Copeland","ja":"コープランドの七つ子","ko":"코프랜드의 칠중주","fa":"هفت قلوی کوپ لند","es":"Septeto de Coperland","ru":"Септет Коупленда","tr":"Copeland\'s Yedilisi"},"NGC 3753":{"name":"Copeland\'s Septet","ar":"‎‎سباعية كوبلاند‎‎","zh":"科普兰七重星系","fi":"Copelandin seitsikko","fr":"Septet de Copeland","de":"Copeland-Septett","el":"Η Επτάδα του Κόουπλαντ","it":"Settetto di Copeland","ja":"コープランドの七つ子","ko":"코프랜드의 칠중주","fa":"هفت قلوی کوپ لند","es":"Septeto de Coperland","ru":"Септет Коупленда","tr":"Copeland\'s Yedilisi"},"NGC 3754":{"name":"Copeland\'s Septet","ar":"‎‎سباعية كوبلاند‎‎","zh":"科普兰七重星系","fi":"Copelandin seitsikko","fr":"Septet de Copeland","de":"Copeland-Septett","el":"Η Επτάδα του Κόουπλαντ","it":"Settetto di Copeland","ja":"コープランドの七つ子","ko":"코프랜드의 칠중주","fa":"هفت قلوی کوپ لند","es":"Septeto de Coperland","ru":"Септет Коупленда","tr":"Copeland\'s Yedilisi"},"NGC 3766":{"name":"Pearl Cluster","ar":"‎‎حشد اللؤلؤ‎‎","zh":"珍珠星团","fi":"Helmijoukko","fr":"Amas de la Perle","de":"Perlen-Haufen","it":"Ammasso Perla","ko":"진주 은하","fa":"خوشه مروارید","es":"Cúmulo Perla","ru":"Скопление Жемчужина"},"NGC 3918":{"name":"Blue Planetary Nebula","ar":"‎السديم الكوكبي الأزرق‎","zh":"蓝行星状星云","de":"Blauer Planetarischer Nebel","it":"Nebulosa Planetaria Blu","ko":"푸른 행성상 성운","es":"Nebulosa Planetaria Azul","ru":"Голубая планетарная туманность"},"NGC 3928":{"name":"Miniature Spiral","ar":"‎‎اللولبية الصغيرة‎‎","zh":"微螺旋星系","fi":"Pienoisspiraali","fr":"Spirale miniature","de":"Miniatur-Spirale","el":"Μικρογραφεία Σπείρας","it":"Spirale in miniatura","ko":"소형 나선 은하","fa":"مارپیچ مینیاتور","es":"Espiral en Miniatura","ru":"Маленькая спираль","tr":"Minyatür Spiral"},"NGC 3992":{"name":"Vacuum Cleaner Galaxy","ar":"‎‎مجرة المكنسة الكهربائية‎‎","zh":"吸尘器星系","fi":"Pölynimurigalaksi","fr":"Galaxie de l\'Aspirateur","de":"Staubsauger-Galaxie","it":"Galassia Aspirapolvere","ko":"진공청소기 은하","fa":"کهکشان جارو برقی","es":"Galaxia de la aspiradora","ru":"Галактика Пылесос"},"NGC 4005":{"name":"NGC 4005 group","ar":"مجموعة إن جي سي ٤٠٠٥","zh":"4005星系群","fi":"NGC 4005 -ryhmä","fr":"Groupe NGC 4005","de":"NGC 4005-Gruppe","ja":"NGC4005銀河群","ko":"NGC 4005 은하단","es":"Grupo NGC 4005","ru":"Группа NGC 4005"},"NGC 4038":{"name":"Antennae","ar":"‎‎قرون الاستشعار‎‎","zh":"触须星系","fi":"Tuntosarvigalaksit","fr":"Galaxies des Antennes","de":"Antennen","el":"Κεραίες","he":"אנטנות","it":"Antenna","ja":"アンテナ銀河","ko":"안테나","fa":"توکان","es":"Antena","ru":"Антенна","tr":"Anten"},"NGC 4039":{"name":"Antennae","ar":"‎‎قرون الاستشعار‎‎","zh":"触须星系","fi":"Tuntosarvigalaksit","fr":"Galaxies des Antennes","de":"Antennen","el":"Κεραίες","he":"אנטנות","it":"Antenna","ja":"アンテナ銀河","ko":"안테나","fa":"توکان","es":"Antena","ru":"Антенна","tr":"Anten"},"NGC 4103":{"name":"The Longtail","ar":"‎الذيل الطويل‎","zh":"长尾星团","fi":"Pitkähäntä","de":"Langschwanz","ko":"롱테일","es":"La Cola Larga","ru":"Длиннохвостое"},"NGC 4147":{"name":"Kick the Can Cluster","ar":"‎حشد لعبة اركل العلبة‎","zh":"踢罐星团","de":"Versteckspiel-Haufen","ko":"깡통차기 성단","es":"Cúmulo Patear el Can","ru":"Скопление Пни банку"},"NGC 4169":{"name":"The Box","ar":"‎الصندوق‎","zh":"方盒星系群","de":"Die Kiste","ko":"상자","es":"La Caja","ru":"Коробка"},"NGC 4170":{"name":"The Box","ar":"‎الصندوق‎","zh":"方盒星系群","de":"Die Kiste","ko":"상자","es":"La Caja","ru":"Коробка"},"NGC 4174":{"name":"The Box","ar":"‎الصندوق‎","zh":"方盒星系群","de":"Die Kiste","ko":"상자","es":"La Caja","ru":"Коробка"},"NGC 4175":{"name":"The Box","ar":"‎الصندوق‎","zh":"方盒星系群","de":"Die Kiste","ko":"상자","es":"La Caja","ru":"Коробка"},"NGC 4194":{"name":"Medusa Galaxy","ar":"‎مجرة ميدوسا‎","zh":"美杜莎星系","fi":"Meduusagalaksi","fr":"Galaxie de la Méduse","de":"Medusa-Galaxie","it":"Galassia Medusa","ko":"메두사 은하","es":"Galaxia Medusa","ru":"Галактика Медуза"},"NGC 4216":{"name":"Silver Streak Galaxy","ar":"‎مجرة الوميض الفضي‎","zh":"银纹星系","fr":"Galaxie de la Trainée d\'argent","de":"Silberstreif-Galaxie","it":"Galassia Stricia di Argento","ko":"실버 스트리크 은하","es":"Galaxia Racha de Plata","ru":"Галактика Серебряная полоса"},"NGC 4254":{"name":"Virgo Cluster Pinwheel","ar":"‎‎مروحة حشد العذراء‎‎","zh":"室女座星系团风车","fi":"Neitsyen tuulimyllygalaksi","fr":"Moulinet de l\'amas de la Vierge","de":"Virgohaufen-Feuerrad","it":"Ammasso della Vergine Girandola","ko":"처녀자리 성단 바람개비","fa":"فرفره خوشه دوشیزه","es":"Molinillo del Cúmulo de Virgo","ru":"Вертушка скопления Девы"},"NGC 4276":{"name":"Faust V023","ar":"‎V023 فاوست‎","zh":"浮士德023","ko":"파우스트 V023","ru":"Фауст  V023"},"NGC 4303":{"name":"Swelling Spiral Galaxy","ar":"‎مجرة الإنتفاخ اللولبية‎","zh":"胖螺旋星系","fr":"Galaxie spirale de l\'Enflure","de":"Anschwellende Spiralgalaxie","it":"Galassia Spirale Gonfiabile","ko":"팽창 나선 은하","es":"Galaxia Espiral Hinchada","ru":"Галактика Набухающая спираль"},"NGC 4321":{"name":"Blowdryer Galaxy","ar":"‎‎مجرة المجفف الهوائي‎‎","zh":"吹风机星系","fi":"Hiustenkuivaingalaksi","fr":"Galaxie du Sèche-cheveux","de":"Haarföhn-Galaxie","it":"Galassia Asciugacapelli","ko":"헤어드라이어 은하","fa":"کهکشان سشوار","es":"Galaxia Secadora de Cabello","ru":"Галактика Фен"},"NGC 4325":{"name":"Galaxy Cluster","ar":"‎‎حشد المجرة‎‎","zh":"室女座星系团","fi":"Galaksijoukko","fr":"Amas de galaxies","de":"Galaxienhaufen","it":"Ammasso di Galassie","ko":"은하단","fa":"خوشه کهکشانی","es":"Cúmulo de Galaxia","ru":"Скопление галактик"},"NGC 4361":{"name":"Lawn Sprinkler Nebula","ar":"‎سديم رشاش الماء‎","zh":"洒水器星云","fr":"Nébuleuse de l\'Arroseur de gazon","de":"Rasensprenger-Nebel","it":"Nebulosa Irrigatore da Prato","ko":"잔디밭의 스프링쿨러 성운","es":"Nebulosa Rociador de Césped","ru":"Туманность Машина для поливки газонов"},"NGC 4374":{"name":"Markarian\'s Chain","ar":"‎‎سلسلة ماكاريان‎‎","zh":"马卡良星系链","fi":"Markarianin ketju","fr":"Chaîne de Markarian","de":"Markarjansche Kette","it":"Catena di Markarian","ja":"マルカリアンの鎖","ko":"마카리안의 사슬","fa":"سلسله مارکارین","es":"Cadena de Markarian","ru":"Цепочка Маркаряна"},"NGC 4473":{"name":"Markarian\'s Chain","ar":"‎‎سلسلة ماكاريان‎‎","zh":"马卡良星系链","fi":"Markarianin ketju","fr":"Chaîne de Markarian","de":"Markarjansche Kette","it":"Catena di Markarian","ja":"マルカリアンの鎖","ko":"마카리안의 사슬","fa":"سلسله مارکارین","es":"Cadena de Markarian","ru":"Цепочка Маркаряна"},"NGC 4477":{"name":"Markarian\'s Chain","ar":"‎‎سلسلة ماكاريان‎‎","zh":"马卡良星系链","fi":"Markarianin ketju","fr":"Chaîne de Markarian","de":"Markarjansche Kette","it":"Catena di Markarian","ja":"マルカリアンの鎖","ko":"마카리안의 사슬","fa":"سلسله مارکارین","es":"Cadena de Markarian","ru":"Цепочка Маркаряна"},"NGC 4387":{"name":"Great Galactic Face","ar":"‎الوجه المجرّي العظيم‎","zh":"星系构成的脸","de":"Großes Galaktisches Gesicht","ko":"은하계의 거대한 얼굴","es":"Gran Rostro Galáctico","ru":"Большое галактическое лицо"},"NGC 4406":{"name":"Faust V051","ar":"‎‎ V051 سديم فاوست‎‎","zh":"浮士德051","ko":"파우스트 V051","fa":"فاوست V051","ru":"Фауст V051"},"NGC 4435":{"name":"The Eyes","ar":"‎‎العينان‎‎","zh":"双眼星系","fi":"Silmät","fr":"Galaxie des Yeux","el":"Γαλαξίες Μάτια","it":"Gli Occhi","ko":"눈","la":"Oculi","fa":"چشمها","es":"los ojos","ru":"Глаза","tr":"Gözler"},"NGC 4438":{"name":"The Eyes","ar":"‎‎العينان‎‎","zh":"双眼星系","fi":"Silmät","fr":"Galaxie des Yeux","el":"Γαλαξίες Μάτια","it":"Gli Occhi","ko":"눈","la":"Oculi","fa":"چشمها","es":"los ojos","ru":"Глаза","tr":"Gözler"},"NGC 4486":{"name":"Virgo Galaxy","ar":"‎‎مجرة العذراء‎‎","zh":"室女座星系","fi":"Neitsyen galaksi","fr":"Galaxie Virgo","de":"Virgo-Galaxie","it":"Galassia della Vergine","ja":"おとめ座銀河","ko":"처녀자리 은하","fa":"کهکشان دوشیزه","es":"Galaxia Virgo","ru":"Галактика Девы","he":"בתולה A"},"NGC 4490":{"name":"Cocoon Galaxy","ar":"‎‎مجرة الشرنقة‎‎","zh":"茧星系","fi":"Kotelosumu","fr":"Galaxie du Cocon","de":"Kokon-Galaxie","it":"Galassia Bozzolo","ja":"まゆ銀河","ko":"번대기 은하","fa":"کهکشان پیله ابریشم","es":"galaxia Cocoon","ru":"Галактика Кокон"},"NGC 4990":{"name":"Cocoon Galaxy","ar":"‎‎مجرة الشرنقة‎‎","zh":"茧星系","fi":"Kotelosumu","fr":"Galaxie du Cocon","de":"Kokon-Galaxie","it":"Galassia Bozzolo","ja":"まゆ銀河","ko":"번대기 은하","fa":"کهکشان پیله ابریشم","es":"galaxia Cocoon","ru":"Галактика Кокон"},"NGC 4507":{"name":"Shapley-Ames 2","ar":"‎شابلي أيمز 2‎","zh":"夏普利-艾姆斯2","fi":"Shapley–Ames 2","ko":"셰이프리-에임스 2","fa":"شپلی-ایمز 2","ru":"Шепли-Эймс 2"},"NGC 4526":{"name":"Lost Galaxy","ar":"‎‎المجرة الضائعة‎‎","zh":"遗失星系","fi":"Kadonnut galaksi","fr":"Galaxie perdue","de":"Verlorene Galaxie","it":"Galassia Persa","ko":"잃어버린 은하","fa":"کهکشان گمشده","es":"Galaxia Perdida","ru":"Потерянная галактика"},"NGC 4535":{"name":"The Lost Galaxy of Copeland","ar":"‎مجرة كوبلاند المفقودة‎","zh":"科普兰遗失星系","fr":"Galaxie perdue de Copeland","de":"Copelands verlorene Galaxie","it":"La Galassia Persa di Copeland","ko":"코프랜드의 잃어버린 은하","es":"Galaxia Perdida de Copeland","ru":"Потерянная галактика Коупленда"},"NGC 4559":{"name":"Koi Fish Galaxy","ar":"‎مجرة سمكة كوي‎","zh":"锦鲤星系","fr":"Galaxie de la Carpe Koï","de":"Koi-Fisch-Galaxie","it":"Galassia Pesce Koi","ko":"비단잉어 은하","es":"Galaxia Pez Koi","ru":"Галактика Полосатая зубатка"},"NGC 4565":{"name":"Needle Galaxy","ar":"‎‎مجرة الإبرة‎‎","zh":"针状星系","fi":"Neulagalaksi","fr":"Galaxie de l\'Aiguille","de":"Nadel-Galaxie","it":"Galassia Ago","ko":"바늘 은하","fa":"کهکشان سوزن","es":"Galaxia de la Aguja","ru":"Галактика Игла"},"NGC 4567":{"name":"Siamese Twins","ar":"‎‎التوأم السيامي‎‎","zh":"双胞胎星系","fi":"Siamilaiset kaksoset","fr":"Frères siamois","de":"Siamesische Zwillinge","el":"Σιαμαίοι Δίδυμοι","he":"תאומים סיאמיים","it":"Gemelli siamesi","ja":"シャム双生児銀河","ko":"샴쌍둥이","hi":"सियामी जुड़वां","fa":"دوقلوهای تایلندی","es":"Gemelos siameses","ru":"Сиамские близнецы","tr":"Siyam İkizleri"},"NGC 4568":{"name":"Siamese Twins","ar":"‎‎التوأم السيامي‎‎","zh":"双胞胎星系","fi":"Siamilaiset kaksoset","fr":"Frères siamois","de":"Siamesische Zwillinge","el":"Σιαμαίοι Δίδυμοι","he":"תאומים סיאמיים","it":"Gemelli siamesi","ja":"シャム双生児銀河","ko":"샴쌍둥이","hi":"सियामी जुड़वां","fa":"دوقلوهای تایلندی","es":"Gemelos siameses","ru":"Сиамские близнецы","tr":"Siyam İkizleri"},"NGC 4594":{"name":"Sombrero Galaxy","ar":"‎مجرة سمبرورو‎","zh":"草帽星系","fi":"Sombrerogalaksi","fr":"Galaxie du Sombrero","de":"Sombrero-Galaxie","el":"Γαλαξίας Σομπρέρο","it":"Galassia sombrero","ja":"ソンブレロ銀河","ko":"솜브레오 은하","fa":"کهکشان کلاه اسپانیولی","es":"Galaxia del Sombrero","ru":"Галактика Сомбреро","tr":"Meksikalı Şapkası Gökadası","he":"גלקסיית הסומבררו"},"NGC 4605":{"name":"Faberge Egg Galaxy","ar":"‎مجرة بيض فابرجيه‎","zh":"俄罗斯彩蛋星系","fr":"Galaxie de l\'Oeuf de Fabergé","de":"Faberge-Ei-Galaxie","it":"Galassia Uovo di Faberge","ko":"파르베제 달걀 은하","es":"Galaxia Huevo Faberge","ru":"Галактика Яйцо Фаберже"},"NGC 4609":{"name":"Coalsack Cluster","ar":"‎حشد كيس الفحم‎","zh":"煤袋星团","fi":"Hiilisäkkijoukko","fr":"Amas du Sac à charbon","de":"Kohlensack-Haufen","it":"Ammasso Sacco di Carbone","ja":"コールサック星団","ko":"콜색 성단","es":"Cúmulo Saco de Carbón","ru":"Скопление Угольный мешок"},"NGC 4622":{"name":"Centaurus Chain","ar":"‎سلسلة قنطورس‎","zh":"半人马座星系链","de":"Centaurus-Kette","ko":"센타우루스 사슬","es":"Cadena de Centaurus","ru":"Цепочка Центавра"},"NGC 4650":{"name":"Centaurus Chain","ar":"‎سلسلة قنطورس‎","zh":"半人马座星系链","de":"Centaurus-Kette","ko":"센타우루스 사슬","es":"Cadena de Centaurus","ru":"Цепочка Центавра"},"PGC 42911":{"name":"Centaurus Chain","ar":"‎سلسلة قنطورس‎","zh":"半人马座星系链","de":"Centaurus-Kette","ko":"센타우루스 사슬","es":"Cadena de Centaurus","ru":"Цепочка Центавра"},"NGC 4631":{"name":"Whale Galaxy","ar":"‎‎مجرة الحوت‎‎","zh":"鲸鱼星系","fi":"Valasgalaksi","fr":"Galaxie de la Baleine","de":"Wal-Galaxie","it":"Galassia Balena","ko":"고래 은하","fa":"کهکشان نهنگ","es":"Galaxia de la ballena","ru":"Галактика Кит"},"NGC 4651":{"name":"Umbrella Galaxy","ar":"‎مجرة المظلة‎","zh":"伞星系","fr":"Galaxie de l\'Ombrelle","de":"Regenschirm-Galaxie","it":"Galassia Ombrello","ko":"우산 은하","es":"Galaxia de la Sombrilla","ru":"Галактика Зонт"},"NGC 4656":{"name":"Crowbar Galaxy","ar":"‎‎مجرة العتلة‎‎","zh":"撬棒星系","fi":"Sorkkarautagalaksi","fr":"Galaxie du Levier","de":"Brecheisen-Galaxie","it":"Galassia Piede di Porco","ko":"쇠지렛대 은하","fa":"کهکشان اهرم","es":"Galaxia de la Palanca","ru":"Галактика Лом"},"NGC 4657":{"name":"Fishhook Galaxy","ar":"‎مجرة خطاف صيد السمك‎","zh":"鱼钩星系","fr":"Galaxie du Hameçon","de":"Angelhaken-Galaxie","it":"Galassia Amo da Pesca","ko":"낚싯바늘 은하","es":"Galaxia del Anzuelo","ru":"Галактика Рыболовный крючок"},"NGC 4666":{"name":"Superwind-Galaxy","ar":"‎‎مجرة الريح الشديدة‎‎","zh":"超级风星系","fi":"Supertuuligalaksi","fr":"Galaxie à Super-vent","de":"Superwind-Galaxie","it":"Supervento della galassia","ko":"강풍 은하","fa":"کهکشان ابر باد","es":"Galaxia Superviento","ru":"Галактика-суперветер"},"NGC 4676":{"name":"Mice Galaxies","ar":"‎‎مجرات الفئران‎‎","zh":"双鼠星系","fi":"Hiirigalaksit","fr":"Galaxies des Souris","de":"Die Mäuse","it":"Galassie Topo","ja":"ねずみ銀河","ko":"생쥐 은하","fa":"کهکشان موشها","es":"Galaxias Ratones","ru":"Галактики Мыши"},"NGC 4669":{"name":"Vinyl LP Galaxy","ar":"‎مجرة فينيل إل بي‎","zh":"黑胶唱片星系","fr":"Galaxie du disque vinyle","de":"Vinyl-LP-Galaxie","it":"Galassia LP in Vinile","ko":"비닐 LP 은하","es":"Galaxia Vinilo LP","ru":"Галактика Виниловая грамппалстинка"},"NGC 4736":{"name":"Croc\'s Eye Galaxy","ar":"‎مجرة عين كروك‎","zh":"鳄鱼眼星系","fr":"Galaxie de l\'Oeil du Crocodile","de":"Crocs Auge-Galaxie","it":"Galassia Occhio di Coccodrillo","ko":"악어의 눈 은하","es":"Galaxia Ojo de Cocodrilo","ru":"Галактика Глаз крокодила"},"NGC 4753":{"name":"Dust Devil Galaxy","ar":"‎مجرة شيطان الغبار‎","zh":"尘卷暴星系","de":"Sandteufel-Galaxie","ko":"회오리바람 은하","es":"Galaxia Polvo del Diablo","ru":"Галактика Пыльный дьявол"},"NGC 4755":{"name":"Jewel Box","ar":"‎‎صندوق المجوهرات‎‎","zh":"宝盒星团","fi":"Korulipas","fr":"Boîte à Bijoux","de":"Schmuckkästchen","el":"Κοσμηματοθήκη","he":"קופסת התכשיטים","it":"Scrigno di Gioie","ja":"宝石箱","ko":"보석 상자","hi":"ज्वेल बक्सा","fa":"جعبۀ جواهر","es":"Joyero","ru":"Шкатулка","tr":"Mücevher Kutusu"},"NGC 4762":{"name":"Paper-Kite Galaxy","ar":"‎مجرة الطائرة الورقية‎","zh":"纸风筝星系","de":"Papierdrachen-Galaxie","ko":"종이연 은하","es":"Galaxia Cometa de Papel","ru":"Галактика Воздушный змей"},"NGC 4774":{"name":"Kidney Bean Galaxy","ar":"‎مجرة لوبياء‎","zh":"腰豆星系","fi":"Kidney Beanin galaksi","fr":"Galaxie du Haricot","de":"Kidney-Bohnen-Galaxie","el":"Γαλαξίας του Νεφρίτη","it":"Galassia fagiolo bianco","ja":"キドニー・ビーン銀河","ko":"강낭콩 은하","fa":"کهکشان Kidney Bean","es":"Galaxia de la Judía","ru":"Галактика Фасоль","tr":"Barbunya Fasulyesi Gökadası"},"NGC 4826":{"name":"Black Eye Galaxy","ar":"‎مجرة العين السوداء‎","zh":"黑眼星系","fi":"Mustasilmägalaksi","de":"Blaues Auge-Galaxie","ja":"黒眼銀河","ko":"검은 눈 은하","es":"Galaxia Ojo Negro","ru":"Галактика Чёрный Глаз","he":"גלקסיית העין השחורה"},"NGC 4833":{"name":"The Southern Butterfly","ar":"‎الفراشة الجنوبية‎","zh":"南天蝴蝶星团","de":"Südlicher Schmetterling","ko":"남쪽 나비","es":"Mariposa del Sur","ru":"Южная бабочка"},"NGC 4889":{"name":"Coma B","ar":"‎‎الذؤابة ب‎‎","zh":"后发座","it":"NGC 4889","ja":"かみのけ座B","ko":"머리털자리 B","fa":"برج گیسو B","ru":"Волосы Вероники B"},"NGC 4898":{"name":"Z Coma Coma","ar":"‎زي الذؤابة‎","zh":"后发座彗发星系","it":"Chioma Z Coma","ko":"Z 코마 코마","ru":"Кома Z Волос Вероники"},"NGC 4945":{"name":"The Tweezers Galaxy","ar":"‎مجرة الملقاط‎","zh":"镊子星系","de":"Pinzetten-Galaxie","ko":"핀셋 은하","es":"Galaxia de las Pinzas","ru":"Галактика Пинцет"},"NGC 5033":{"name":"Waterbug Galaxy","ar":"‎مجرة حشرة الماء‎","zh":"田鳖星系","de":"Wasserkäfer-Galaxie","ko":"수생곤충 은하","es":"Galaxia Bicho de Agua","ru":"Галактика Водяной клоп"},"NGC 5044":{"name":"NGC 5044 group","ar":"‎مجموعة إن جي سي 5044‎","zh":"5044星系群","fi":"NGC 5044 -ryhmä","fr":"Groupe NGC 5044","de":"NGC 5044-Gruppe","ja":"NGC5044銀河群","ko":"NGC 5044 은하단","es":"Grupo NGC 5044","ru":"Группа NGC 5044"},"NGC 5055":{"name":"Sunflower Galaxy","ar":"‎مجرة عبّاد الشمس‎","zh":"向日葵星系","fi":"Auringonkukkagalaksi","fr":"Galaxie du Tournesol","de":"Sonnenblumen-Galaxie","el":"Γαλαξίας Ηλιοτρόπιο","it":"Galassia girasole","ja":"ひまわり銀河","ko":"해바라기 은하","fa":"کهکشان گل آفتاب‌گردان","es":"Galaxia del Girasol","ru":"Галактика Подсолнечник","tr":"Ayçiçeği Gökadası","he":"גלקסיית החמניה"},"NGC 5102":{"name":"Iota\'s Ghost","ar":"‎شبح أيوتا‎","zh":"柱十一之魂","fr":"Fantôme du Iota","de":"Iotas Geist","it":"Fantasma di Iota","ko":"이오타의 유령","es":"Fantasma de Iota","ru":"Призрак йоты"},"NGC 5128":{"name":"Centaurus A","ar":"‎‎قنطورس A‎‎","zh":"半人马座","fr":"Centaurus A","el":"Κένταυρος Α","ja":"ケンタウルス座A","ko":"센타우루스 알파","fa":"آ قنطروس","es":"Centauro A","ru":"Центавр А","tr":"Erboğa A","he":"קנטאור A"},"NGC 5139":{"name":"ω Cen Cluster","ar":"‎‎حشد أوميغا قنطورس‎‎","zh":"半人马座奥米茄星团","fi":"ω Centauri -joukko","fr":"Amas ω Cen","de":"ω Cen Haufen","it":"Ammasso ω Cen","ja":"ω星団","ko":"센타우루스자리 오메가 성단","fa":"خوشه امگا قنطورس","es":"Cluster ω Cen","ru":"Скопление ω Центавра","he":"אומגה בקנטאור"},"NGC 5189":{"name":"Spiral Planetary Nebula","ar":"‎السديم الحلزوني الكوكبي‎","zh":"螺旋行星状星云","de":"Spiralförmiger planetarer Nebel","ko":"나선형 행성상 성운","es":"Nebulosa Planetaria Espiral","ru":"Планетарная туманность Спираль"},"NGC 5194":{"name":"Whirlpool Galaxy","ar":"‎المجرة الدوّامة‎","zh":"涡状星系","fi":"Pyörregalaksi","fr":"Galaxie du Tourbillon","de":"Whirlpool-Galaxie","el":"Γαλαξίας της Δίνης","it":"Galassia vortice","ja":"子持ち銀河","ko":"소용돌이 은하","fa":"کهکشان گردابی","es":"Galaxia del Remolino","ru":"Галактика Водоворот","tr":"Girdap Gökadası","he":"גלקסיית המערבולת"},"NGC 5195":{"name":"A Justifiable Replacement for M51","ar":"‎بديل مبرر لـ M51‎","zh":"51替代者","de":"Ein gerechtfertigter Ersatz für M51","ko":"M51의 정당한 교체품","es":"Un reemplazo justificable para M51","ru":"Обоснованная замена для M51"},"NGC 5216":{"name":"Keenan\'s System","ar":"‎‎نظام كينان‎‎","zh":"基南系统","fi":"Keenanin järjestelmä","fr":"Système de Keenan","de":"Keenans System","el":"Σύστημα του Κίναν","it":"Sistema di Keenan","ja":"キーナンの系","ko":"키난의 시스템","fa":"سامانه کینان","es":"Sistema de Keenan","ru":"Система Кинана","tr":"Keenan Sistemi"},"NGC 5218":{"name":"Keenan\'s System","ar":"‎‎نظام كينان‎‎","zh":"基南系统","fi":"Keenanin järjestelmä","fr":"Système de Keenan","de":"Keenans System","el":"Σύστημα του Κίναν","it":"Sistema di Keenan","ja":"キーナンの系","ko":"키난의 시스템","fa":"سامانه کینان","es":"Sistema de Keenan","ru":"Система Кинана","tr":"Keenan Sistemi"},"NGC 5291":{"name":"Seashell Galaxy","ar":"‎‎مجرة الصدفة‎‎","zh":"贝壳星系","fi":"Näkinkenkägalaksi","fr":"Galaxie du Coquillage","de":"Seemuschel-Galaxie","it":"Galassia Conchiglia","ja":"貝殻銀河","ko":"조개 은하","fa":"کهکشان صدفی","es":"Galaxia de la Concha","ru":"Галактика Морская ракушка"},"IC 4321":{"name":"Seashell Galaxy","ar":"‎‎مجرة الصدفة‎‎","zh":"贝壳星系","fi":"Näkinkenkägalaksi","fr":"Galaxie du Coquillage","de":"Seemuschel-Galaxie","it":"Galassia Conchiglia","ja":"貝殻銀河","ko":"조개 은하","fa":"کهکشان صدفی","es":"Galaxia de la Concha","ru":"Галактика Морская ракушка"},"NGC 5353":{"name":"NGC 5353 group","ar":"‎مجموعة إن جي سي 5353‎","zh":"5353星系群","fi":"NGC 5353 -ryhmä","fr":"Groupe NGC 5353","de":"NGC 5353-Gruppe","ja":"NGC5353銀河群","ko":"NGC 5353 은하단","es":"Grupo NGC 5353","ru":"Группа NGC 5353"},"NGC 5394":{"name":"The Heron Galaxy","ar":"‎مجرة البلشون‎","zh":"苍鹭星系","fr":"Galaxie de Héron","de":"Heron-Galaxie","it":"Galassia Erone","ko":"왜가리 은하","es":"Galaxia de la Garza","ru":"Галактика Цапля"},"NGC 5395":{"name":"The Heron Galaxy","ar":"‎مجرة البلشون‎","zh":"苍鹭星系","fr":"Galaxie de Héron","de":"Heron-Galaxie","it":"Galassia Erone","ko":"왜가리 은하","es":"Galaxia de la Garza","ru":"Галактика Цапля"},"NGC 5416":{"name":"NGC 5416 group","ar":"‎مجموعة إن جي سي 5416‎","zh":"5416星系群","fi":"NGC 5416 -group","fr":"Groupe NGC 5416","de":"NGC 5416-Gruppe","ja":"NGC5416銀河群","ko":"NGC 5416 은하단","es":"Grupo NGC 5416","ru":"Группа NGC 5416"},"NGC 5457":{"name":"Pinwheel Galaxy","ar":"‎مجرة بينويل‎","zh":"风车星系","fi":"Tuulimyllygalaksi","fr":"Galaxie du Moulinet","de":"Pinwheel-Galaxie","el":"Γαλαξίας Ανεμόμυλος","it":"Galassia girandola","ja":"回転花火銀河","ko":"바람개비 은하","fa":"کهکشان فرفره‌ای","es":"Galaxia de Molinillo","ru":"Галактика Вертушка","tr":"Fırıldak Gökadası","he":"גלקסיית גלגל הרוח"},"NGC 5466":{"name":"Snowglobe Cluster","ar":"‎حشد الكرة الثلجية‎","zh":"雪球星团","de":"Schneekugel-Haufen","ko":"스노 글로브 성단","es":"Cúmulo Globo de Nieve","ru":"Скопление Снежный шар"},"NGC 5617":{"name":"Dracula Cluster","ar":"عنقود دراكولا","zh":"德古拉星团","de":"Dracula-Haufen","ko":"드라큘라 성단","es":"Cúmulo Drácula","ru":"Скопление Дракула"},"NGC 5623":{"name":"Dragon Nebula","ar":"‎‎سديم التنين‎‎","zh":"龙星云","fi":"Lohikäärmesumu","fr":"Nébuleuse du Dragon","de":"Drachen-Nebel","it":"Nebulosa Drago","ko":"용 성운","fa":"سحابی اژدها","es":"Nebulosa del Dragón","ru":"Туманность Дракон"},"NGC 5629":{"name":"NGC 5629 group","ar":"‎مجموعة إن جي سي 5629‎","zh":"5629星系群","fi":"NGC 5629 -ryhmä","fr":"Groupe NGC 5629","de":"NGC 5629-Gruppe","ja":"NGC5629銀河群","ko":"NGC 5629 은하단","es":"Grupo NGC 5629","ru":"Группа NGC 5629"},"NGC 5662":{"name":"Gypsy Moth Cluster","ar":"‎حشد فراشة الغجر‎","zh":"舞毒蛾星团","de":"Schwammspinner-Haufen","ko":"유럽매미나방 성단","es":"Cúmulo Polilla Gitana","ru":"Скопление Цыганская моль"},"NGC 5746":{"name":"Blade and Pearl Galaxy","ar":"‎مجرة الموس واللؤلؤة‎","zh":"刃珠星系","fr":"Galaxie de la Lame et de la Perle","de":"Klinge und Perle-Galaxie","it":"Galassia Spada e Perla","ko":"칼과 진주 은하","es":"Galaxia Cuchilla y Perla","ru":"Туманность Лезвие и жемчуг"},"NGC 5882":{"name":"Ghost of Uranus","ar":"شبح أورانوس","zh":"天王星之魂星云","fi":"Uranuksen haamu","de":"Geist des Uranus","ko":"우라노스의 유령","es":"Fantasma de Urano","ru":"Призрак Урана"},"NGC 5892":{"name":"Fath 703","ar":"‎‎فاذ 703‎‎","zh":"法思703","ko":"패덤 703","fa":"فاد 703","ru":"Фатх 703"},"NGC 5897":{"name":"Ghost Globular Cluster","ar":"‎حشد الشبح الكروي‎","zh":"鬼魂球状星团","fr":"Amas globulaire du Fantôme","de":"Geist-Kugelsternhaufen","it":"Ammasso Globulare Fantasma","ko":"유령 구상성단","es":"Cúmulo Fantasma Globular","ru":"Шаровое скопление Призрак"},"NGC 5904":{"name":"Rose Cluster","ar":"‎حشد الوردة‎","zh":"玫瑰星团","fr":"Amas de la Rose","de":"Rosenhaufen","it":"Ammasso Rosa","ko":"장미 성단","es":"Cúmulo Rosa","ru":"Скопление Роза"},"NGC 5906":{"name":"Splinter Galaxy","ar":"‎مجرة الشظية‎","zh":"分裂星系","fi":"Sirpalegalaksi","fr":"Galaxie de l\'Écharde","de":"Splitter-Galaxie","it":"Galassia Scheggia","ko":"조각 은하","fa":"کهکشان باريکه چوب","es":"Galaxia de la astilla","ru":"Галактика Осколок"},"NGC 6027":{"name":"Seyfert\'s Sextet","ar":"‎‎سداسية سيفيرت‎‎","zh":"赛弗特六重星系","fi":"Seyfertin kuusikko","fr":"Sextuor de Seyfert","de":"Seyferts Sextett","it":"Sestetto di Seyfert","ja":"セイファートの六つ子","ko":"세이퍼트의 육중주","fa":"شش‌قلوی سیفرت","es":"Sexteto Seyfert","ru":"Секстет Сейферта"},"NGC 6087":{"name":"S Nor Cluster","ar":"‎حشد إس مسطرة النقاش‎","zh":"矩尺座星团","fi":"S Nor -joukko","fr":"Amas S Nor","de":"S Nor-Haufen","it":"Ammasso S Nor","ko":"직각자자리 S 성단","es":"Cúmulo S Nor","ru":"Скопление S Наугольника"},"NGC 6121":{"name":"Crab Globular Cluster","ar":"‎حشد السرطان الكروي‎","zh":"蟹状星团","fr":"Amas globulaire du Crabe","de":"Krebs-Kugelsternhaufen","it":"Ammasso Globulare Granchio","ko":"게 구상성단","es":"Cúmulo Globular del Cangrejo","ru":"Шаровое скопление Краб"},"NGC 6134":{"name":"Little Pincushion","ar":"‎وسادة الدبابيس الصغيرة‎","zh":"小枕星团","de":"Kleines Nadelkissen","ko":"작은 바늘꽂이","es":"Pequeño Cojín de Alfiler","ru":"Булавочная подушечка"},"NGC 6171":{"name":"The Crucifix Cluster","ar":"‎حشد الصليب‎","zh":"十字架星团","fr":"Amas du Crucifix","de":"Kruzifix-Haufen","it":"Ammasso Crocifisso","ko":"십자가상 성단","es":"Cúmulo del Crucifijo","ru":"Скопление Распятие"},"NGC 6188":{"name":"Rim Nebula","ar":"‎‎سديم الإطار‎‎","zh":"环星云","fi":"Vannesumu","fr":"Nébuleuse de l\'arête","de":"Randnebel","it":"Nebulosa Orlo","ko":"테 성운","fa":"سحابی حاشیه دار","es":"nebulosa Rim","ru":"Туманность Обод"},"NGC 6169":{"name":"μ Normae Cluster","ar":"‎‎حشد ميو مسطرة النقاش‎‎","zh":"矩尺座μ星团","fi":"μ Normae -joukko","fr":"Amas de μ Normae","de":"μ Normae-Haufen","it":"Ammasso μ Normae","ja":"じょうぎ座μ星団","ko":"직각가자리 뮤 성단","fa":"خوشه مو-گونیا","es":"Cúmulo μ Normae","ru":"Скопление μ Наугольника"},"NGC 6205":{"name":"Great Star Cluster in Hercules","ar":"‎حشد النجوم العظيم في هرقل‎","zh":"武仙座球状星团","fi":"Herkuleksen suuri pallomainen tähtijoukko","de":"Großer Sternhaufen im Herkules","ja":"ヘルクレス座大球状星団","ko":"허큘레스자리 대성단","es":"Gran Cúmulo Estelar en Hércules","ru":"Большое звёздное скопление в Геркулесе","he":"צביר הרקולס"},"NGC 6210":{"name":"Turtle Nebula","ar":"‎سديم السلحفاة‎","zh":"乌龟星云","fi":"Kilpikonnasumu","de":"Schildkröten-Nebel","ko":"거북 성운","es":"Nebulosa de la Tortuga","ru":"Туманность Черепаха"},"NGC 6218":{"name":"Gumball Globular Cluster","ar":"حشد كرة العلك الكروي","zh":"口香糖球状星团","de":"Gummiball-Kugelsternhaufen","it":"Ammasso  Globulare Pallina di Gomma","es":"Cúmulo Globular Gumball","ru":"Шаровое скопление Жвачка"},"NGC 6229":{"name":"Prize Comet Globular Cluster","ar":"‎حشد مذنب برايز الكروي‎","zh":"彗星奖球状星团","de":"Siegerkomet-Kugelsternhaufen","ko":"상 혜성 구상성단","es":"Cúmulo Globular Cometa Premiado","ru":"Шаровое скопление Призовая комета"},"NGC 6231":{"name":"False Comet Nebula","ar":"‎سديم المذنب المزيف‎","zh":"伪彗星星云","fi":"Valekomeettasumu","fr":"Nébuleuse de la Fausse comète","de":"Scheinkomet-Nebel","it":"Nebulosa Falsa Cometa","ko":"가짜 혜성 성단","es":"Nebulosa del Cometa Falso","ru":"Туманность Ложная комета"},"NGC 6266":{"name":"Flickering Globular Cluster","ar":"‎الحشد الكروي المومض‎","zh":"闪球星团","fr":"Amas globulaire vacillant","de":"Flimmernder Kugelsternhaufen","it":"Ammasso Globulare Tremolante","ko":"깜빡이는 구상성단","es":"Cúmulo Globular del Parpadeo","ru":"Мигающее шаровое скопление"},"NGC 6281":{"name":"Moth Wing Cluster","ar":"‎حشد جناح الفراشة‎","zh":"蛾翼星团","fr":"Amas de l\'Aile de papillon","de":"Mottenflügel-Haufen","it":"Ammasso delle Falene","ko":"모스윙나방 성단","es":"Cúmulo Ala de Polilla","ru":"Скопление Крыло моли"},"NGC 6302":{"name":"Bug Nebula","ar":"‎سديم البقِّة‎","zh":"小虫星云","fi":"Ludesumu","fr":"Nébuleuse de l\'Insecte","de":"Wanzen-Nebel","el":"Νεφέλωμα Έντομο","it":"Nebulosa insetto","ja":"バグ星雲","ko":"벌레 성운","fa":"سحابی حشره","es":"Nebulosa del Insecto","ru":"Туманность Жук","tr":"Böcek Bulutsusu"},"NGC 6309":{"name":"Box Nebula","ar":"‎سديم بوكس‎","zh":"方盒星云","fi":"Box-sumu","fr":"Nébuleuse de la Boîte","de":"Boxen-Nebel","el":"Νεφέλωμα Κουτί","it":"Nebulosa scatola","ja":"ボックス星雲","ko":"상자 성운","fa":"سحابی جعبه‌ای","es":"Nebulosa de la Caja","ru":"Туманность Коробки","tr":"Box Bulutsusu"},"NGC 6334":{"name":"Cat\'s Paw Nebula","ar":"‎‎سديم مخلب القط‎‎","zh":"猫掌星云","fi":"Kissankäpäläsumu","fr":"Nébuleuse de la Patte de chat","de":"Katzenpfoten-Nebel","it":"Nebulosa Zampa di Gatto","ko":"고양이 발 성운","fa":"سحابی پنجه گربه","es":"Nebulosa Pata de  Gato","ru":"Туманность Кошачья лапа","he":"ערפילית טלף החתול"},"NGC 6337":{"name":"Cheerio Nebula","ar":"‎‎سديم الطارة‎‎","zh":"麦圈星云","fi":"Cheeriosumu","fr":"Nébuleuse Cheerio","de":"Cheerio-Nebel","it":"Nebulosa Ciao","ko":"건배 성운","fa":"سحابی خداحافظ","es":"Nebulosa Cheerio","ru":"Туманность Салют"},"NGC 6357":{"name":"Lobster Nebula","ar":"‎‎سديم سرطان البحر‎‎","zh":"龙虾星云","fi":"Hummerisumu","fr":"Nébuleuse du Homard","de":"Hummer-Nebel","it":"Nebulosa Aragosta","ja":"ロブスター星雲","ko":"바닷가재 성운","fa":"سحابی خرچنگ دریایی","es":"Nebulosa de la Langosta","ru":"Туманность Омар"},"NGC 6369":{"name":"Little Ghost Nebula","ar":"‎‎سديم الشبح الصغير‎‎","zh":"小鬼魂星云","fi":"Pieni aavesumu","fr":"Nébuleuse du Petit fantôme","de":"Kleiner Geistnebel","it":"Nebulosa Piccolo Fantasma","ko":"작은 유령 성운","fa":"سحابی شبح کوچک","es":"Nebulosa Pequeño Fantasma","ru":"Туманность Малый призрак"},"NGC 6380":{"name":"Tonantzintla 1","ar":"‎تونانتزينتلا 1‎","zh":"托南钦特拉1球状星团","ko":"토넌틴트라 1","ru":"Тонантзинтла 1"},"NGC 6400":{"name":"Phantom Cluster","ar":"‎حشد الشبح‎","zh":"幻影星团","fr":"Amas du Fantôme","de":"Phantom-Haufen","it":"Ammasso Fantasma","ko":"유령 성단","es":"Cúmulo Fantasma","ru":"Скопление Фантом"},"NGC 6441":{"name":"Silver Nugget Cluster","ar":"‎حشد البيضة الفضية‎","zh":"银块星团","fr":"Amas de la Pépite d\'argent","de":"Silbernugget-Haufen","it":"Ammasso Pepita d\'Argento","ko":"은덩이 성단","es":"Cúmulo Pepita Plateada","ru":"Скопление Серебряный самородок"},"NGC 6445":{"name":"Little Gem Nebula","ar":"‎‎سديم الجوهرة الصغيرة‎‎","zh":"小宝石星云","fi":"Pieni jalokivisumu","fr":"Nébuleuse de la Petite pierre précieuse","de":"Kleiner Edelstein-Nebel","it":"Nebulosa Piccolo Gioiello","ko":"작은 보석 성단","fa":"سحابی گوهر کوچک","es":"Nebulosa Pequeña Gema","ru":"Туманность Малая жемчужина"},"NGC 6818":{"name":"Little Gem Nebula","ar":"‎‎سديم الجوهرة الصغيرة‎‎","zh":"小宝石星云","fi":"Pieni jalokivisumu","fr":"Nébuleuse de la Petite pierre précieuse","de":"Kleiner Edelstein-Nebel","it":"Nebulosa Piccolo Gioiello","ko":"작은 보석 성단","fa":"سحابی گوهر کوچک","es":"Nebulosa Pequeña Gema","ru":"Туманность Малая жемчужина"},"NGC 6451":{"name":"Tom Thumb Cluster","ar":"‎حشد إصبع توم‎","zh":"汤姆拇指星团","fi":"Tom Thumb -joukko","fr":"Amas Tom Pouce","de":"Däumlings-Haufen","it":"Ammasso Pollicino","ko":"톰 텀브 성단","fa":"خوشه آدم کوتوله","es":"Cúmulo Tom Thumb","ru":"Скопление Пальчик"},"NGC 6475":{"name":"Ptolemy\'s Cluster","ar":"‎عنقود بتوليمي‎","zh":"托勒密星团","fi":"Ptolemaioksen tähtijoukko","fr":"Amas de Ptolémée","de":"Ptolemäus-Haufen","el":"Σμήνος του Πτολεμαίου","it":"Ammasso di Tolomeo","ja":"トレミー星団","ko":"프톨레미 성단","fa":"خوشۀ بطلیموس","es":"Cúmulo de Ptolomeo","ru":"Скопление Птолемея","tr":"Ptolemy Kümesi","he":"צביר תלמי"},"NGC 6503":{"name":"Lost in Space Galaxy","ar":"‎المجرة الضائعة في الفضاء‎","zh":"太空迷航星系","fr":"Galaxie Perdue dans l\'espace","de":"Verloren-im-Raum-Galaxie","it":"Galassia Persi nello Spazio","ko":"로스트 인 스페이스 은하","es":"Galaxia Perdida en el Espacio","ru":"Затерянная в космосе галактика"},"NGC 6514":{"name":"Trifid Nebula","ar":"‎سديم تريفيد‎","zh":"三裂星云","fi":"Trifidsumu","fr":"Nébuleuse de Trifid","de":"Trifid-Nebel","el":"Τρισχιδές Νεφέλωμα","it":"Nebulosa trifida","ja":"三裂星雲","ko":"삼렬 성운","fa":"سحابی سه جزئی","es":"Nebulosa Trífida","ru":"Трёхраздельная туманность","tr":"Üç Boğumlu Bulutsu","he":"ערפילית הטריפיד"},"NGC 6520":{"name":"Dead Man\'s Chest Cluster","ar":"‎حشد صدر الرجل الميت‎","zh":"亡灵宝藏星团","fr":"Amas de la Poitrine du mort","de":"Brust des Toten Mannes-Haufen","it":"Ammasso della Scatola dell\'Uomo Morto","ko":"죽은 사람의 상자 성단","es":"Cúmulo el Cofre del Hombre Muerto","ru":"Скопление Сундук мертвеца"},"NGC 6522":{"name":"Baade\'s Window","ar":"نافذة باد","zh":"巴德窗","de":"Baade-Fenster","it":"Finestra di Baade","ko":"바데의 창","es":"Ventana de Baade","ru":"Окно Бааде"},"NGC 6523":{"name":"Lagoon Nebula","ar":"‎كجرة لاجون‎","zh":"礁湖星云","fi":"Laguunisumu","fr":"Nébuleuse du Lagon","de":"Lagunen-Nebel","el":"Νεφέλωμα Λίμνης","it":"Nebulosa Laguna","ja":"干潟星雲","ko":"석호 석운","la":"Laguna Nebula","fa":"سحابی مرداب","es":"Nebulosa del Lago","ru":"Туманность Лагуна","tr":"Deniz Kulağı Bulutsusu","he":"ערפילית הלגונה"},"M 8":{"name":"Lagoon Nebula","ar":"‎كجرة لاجون‎","zh":"礁湖星云","fi":"Laguunisumu","fr":"Nébuleuse du Lagon","de":"Lagunen-Nebel","el":"Νεφέλωμα Λίμνης","it":"Nebulosa Laguna","ja":"干潟星雲","ko":"석호 석운","la":"Laguna Nebula","fa":"سحابی مرداب","es":"Nebulosa del Lago","ru":"Туманность Лагуна","tr":"Deniz Kulağı Bulutsusu"},"NGC 6530":{"name":"Herschel 36","ar":"‎هرشل 36‎","zh":"赫歇尔36","ja":"ハーシェル36","ko":"허셜 36","fa":"هرشل 36","ru":"Гершель 36"},"NGC 6531":{"name":"Webb\'s Cross","ar":"‎صليب ويب‎","zh":"韦伯的十字架","fr":"Croix de Webb","de":"Webbs Kreuz","it":"Croce di Webb","ko":"웹의 십자가","es":"Cruz de Webb","ru":"Крест Вебба"},"NGC 6537":{"name":"Red spider Nebula","ar":"‎‎سديم العنكبوت الأحمر‎‎","zh":"红蜘蛛星云","fi":"Punainen hämähäkkisumu","fr":"Nébuleuse de l\'Araignée rouge","de":"Rote-Spinnen-Nebel","it":"Nebulosa Ragno Rosso","ko":"붉은 거미 성운","fa":"سحابی عنکبوت قرمز","es":"Nebulosa de la Araña Roja","ru":"Туманность Красный паук"},"NGC 6541":{"name":"Cacciatore Cluster","ar":"‎حشد الصياد‎","zh":"砂锅星团","de":"Cacciatore-Haufen","ko":"카시아토레 성단","es":"Cúmulo Cacciatore","ru":"Скопление Охотник"},"NGC 6543":{"name":"Cat\'s Eye Nebula","ar":"‎‎سديم عين القط‎‎","zh":"猫眼星云","fi":"Kissansilmäsumu","fr":"Nébuleuse de l\'Oeil de chat","de":"Katzenaugen-Nebel","it":"Nebulosa Occhio di Gatto","ja":"キャッツアイ星雲","ko":"고양이 눈 성운","fa":"سحابی چشم گربه","es":"Nebulosa Ojo de Gato","ru":"Туманность Кошачий глаз","he":"ערפילית עין החתול"},"NGC 6563":{"name":"Southern Ring Nebula","ar":"‎سديم الحلقة الجنوبي‎","zh":"南指环星云","fi":"Etelän rengassumu","fr":"Nébuleuse de l\'Anneau du Sud","de":"Südlicher Ringnebel","it":"Nebulosa Anello del Sud","ja":"南のリング星雲","ko":"남쪽 고리 성운","la":"Nebula Anularis Australis","fa":"سحابی حلقه جنوبی","es":"Nebulosa Anillo del Sur","ru":"Туманность Южное кольцо"},"NGC 6572":{"name":"Blue Racquetball Nebula","ar":"‎‎سديم كرة المضرب الزرقاء‎‎","zh":"蓝壁球星云","fi":"SIninen racquetballsumu","fr":"Nébuleuse de la Racquetball bleue","de":"Blauer Racquetball-Nebel","it":"Nebulosa Blue Racquetball","ko":"파란 라켓볼 성운","fa":"سحابی توپ تنیس آبی","es":"Nebulosa Racquetball Azul","ru":"Туманность Синий ракетбол"},"NGC 6611":{"name":"Eagle Nebula","ar":"‎سديم النسر‎","zh":"鹰星云","fi":"Kotkasumu","fr":"Nébuleuse de l\'Aigle","de":"Adler-Nebel","el":"Νεφέλωμα Αετός","it":"Nebulosa aquila","ja":"わし星雲","ko":"독수리 성운","fa":"سحابی عقاب","es":"Nebulosa del Águila","ru":"Туманность Орёл","tr":"Kartal Bulutsusu","he":"ערפילית הנשר"},"NGC 6613":{"name":"Black Swan Cluster","ar":"‎حشد البجعة السوداء‎","zh":"黑天鹅星团","fr":"Amas du Cygne noir","de":"Schwarzer Schwan-Haufen","it":"Ammasso Cigno Nero","ko":"흑고니 성단","es":"Cúmulo Cisne Negro","ru":"Скопление Черный лебедь"},"NGC 6618":{"name":"Omega Nebula","ar":"‎‎سديم أوميجا‎‎","zh":"奥米茄星云","fi":"Omegasumu","fr":"Nébuleuse Oméga","de":"Omega-Nebel","it":"Nebulosa Omega","ja":"オメガ星雲","ko":"오메가 성운","fa":"سحابی اومگا","es":"Nebulosa Omega","ru":"Туманность Омега","he":"ערפילית אומגה"},"NGC 6621":{"name":"Edward\'s Galaxy","ar":"‎مجرة إدوارد‎","zh":"爱德华星系","fr":"Galaxie de Edward","de":"Edwards Galaxie","it":"Galassia di Edward","ko":"에드워드의 은하","la":"Galaxia Edwardi","es":"Galaxia de Edward","ru":"Галактика Эдварда"},"NGC 6622":{"name":"Edward\'s Galaxy","ar":"‎مجرة إدوارد‎","zh":"爱德华星系","fr":"Galaxie de Edward","de":"Edwards Galaxie","it":"Galassia di Edward","ko":"에드워드의 은하","la":"Galaxia Edwardi","es":"Galaxia de Edward","ru":"Галактика Эдварда"},"NGC 6633":{"name":"Tweedledum Cluster","ar":"‎حشد تويتلدم‎","zh":"双胞胎星团","de":"Tweedledum-Haufen","ko":"트위들덤 성단","es":"Cúmulo Tweedledum","ru":"Скопление Труляля"},"NGC 6642":{"name":"Tadpole Cluster","ar":"‎حشد الشرغوف‎","zh":"蝌蚪星团","fi":"Nuijapääjoukko","de":"Kaulquappen-Haufen","ko":"올챙이 성단","es":"Cúmulo Renacuajo","ru":"Скопление Головастик"},"NGC 6656":{"name":"Great Sagittarius Cluster","ar":"‎حشد القوس العظيم‎","zh":"人马座大星团","fr":"Grand Amas du Sagittaire","de":"Großer Sagittarius-Haufen","it":"Ammasso del Gran Sagittario","ko":"궁수자리 대성단","la":"Congregatio magna Sagittarii","es":"Gran Cúmulo de Sagitario","ru":"Большое скопление Стрельца"},"NGC 6664":{"name":"Santa\'s Sleigh Cluster","ar":"‎حشد سانتا سلي‎","zh":"圣诞雪橇星团","fr":"Amas du Traineau du Père Noël","de":"Weihnachtsmannschlitten-Haufen","it":"Ammasso Slitta di Babbo Natale","ko":"산타의 썰매 성단","es":"Cúmulo Trineo de Santa Claus","ru":"Скопление Санки Санты"},"NGC 6705":{"name":"Wild Duck Cluster","ar":"‎‎حشد البطة البرية‎","zh":"野鸭星团","fi":"Villisorsajoukko","fr":"Amas du Canard Sauvage","de":"Wilde Enten-Cluster","el":"Σμήνος Αγριόπαπιας","it":"Ammasso anatra selvatica","ja":"わし星団","ko":"야생오리 성단","la":"Congregatio anatis ferae","fa":"خوشۀ مرغابی وحشی","es":"Cúmulo del Pato salvaje","ru":"Скопление Дикая утка","tr":"Vahşi Ördek Kümesi","he":"צביר ברווז הבר"},"NGC 6709":{"name":"Flying Unicorn Cluster","ar":"‎حشد وحيد القرن الطائر‎","zh":"飞独角兽星团","de":"Fliegendes-Einhorn-Haufen","ko":"나는 유니콘 성단","es":"Cúmulo Unicornio Volador","ru":"Скопление Летящий единорог"},"NGC 6720":{"name":"Ring Nebula","ar":"‎سديم الخاتم‎","zh":"指环星云","fi":"Lyyran rengassumu","fr":"Nébuleuse de l\'Anneau","de":"Ring-Nebel","el":"Νεφέλωμα Δακτυλίου","it":"Nebulosa anello","ja":"環状星雲","ko":"고리 성운","la":"Anulus nebula","fa":"سحابی حلقه","es":"Nebulosa del Anillo","ru":"Туманность Кольцо","tr":"Halka Bulutsusu","he":"ערפילית הטבעת"},"NGC 6723":{"name":"Chandelier Cluster","ar":"‎حشد ثريا الإنارة‎","zh":"吊灯星团","fr":"Amas du Chandelier","de":"Armleuchter-Haufen","it":"Ammasso Lampadario","ko":"샹들리에 성단","la":"Congregatio candelabriforma","es":"Cúmulo del Candelabro","ru":"Скопление Канделябр"},"NGC 6729":{"name":"R CrA Nebula","ar":"‎‎سديم آر الإكليل الجنوبي‎‎","zh":"南冕座星云","fi":"R Coronae Australis -sumu","fr":"Nébuleuse R CrA","de":"R CrA Nebel","it":"Nebulosa R CrA","ja":"かんむり座R星雲","ko":"R CrA 성운","fa":"سحابی آر-اکلیل جنوبی","es":"Nebulosa de R CrA","ru":"Туманность R Южной короны"},"NGC 6741":{"name":"Phantom Streak Nebula","ar":"‎‎سديم الشعاع الشبحي‎‎","zh":"幻影条纹星云","fi":"Aavejuovasumu","fr":"Nébuleuse de la Trace de fantôme","de":"Phantomstreifen-Nebel","it":"Nebulosa Phantom Streak","ko":"유령 흔적 성운","es":"Nebulosa Racha Fantasma","ru":"Туманность Фантомная жилка"},"NGC 6745":{"name":"Bird\'s Head","ar":"‎‎رأس الطير‎‎","zh":"鸟头星系","fi":"Linnunpää","fr":"Galaxie de ka tête d\'oiseau","de":"Vogelkopf","it":"Testa di Uccello","ko":"새의 머리","la":"Caput avis","fa":"سر پرنده","es":"Cabeza de pájaro","ru":"Птичья голова"},"NGC 6751":{"name":"Dandelion Puffball Nebula","ar":"‎سديم زهرة الهندباء‎","zh":"蒲公英星云","fi":"Haivenpallosumu","fr":"Nébuleuse des Aigrettes de pissenlit","de":"Pusteblumen-Nebel","it":"Nebulosa Dandelion Puffball","ko":"민들레 홀씨 성운","es":"Nebulosa Puffball Diente de León","ru":"Туманность Одуванчик"},"NGC 6752":{"name":"Pavo Globular Cluster","ar":"‎‎حشد الطاووس الكروي‎‎","zh":"孔雀座球状星团","fi":"Riikinkukon pallomainen joukko","fr":"Amas globulaire du Paon","de":"Pavo-Kugelsternhaufen","it":"Ammasso Globulare Pavone","ja":"くじゃく座球状星団","ko":"파보 구상성단","la":"Congregatio globiforma Pavonis","fa":"خوشه کروی طاووس","es":"Cúmulo Globular del Pavo","ru":"Шаровое скопление Павлина"},"NGC 6755":{"name":"Possible Binary Cluster","ar":"‎احتمال حشد مزدوج‎","zh":"可能的双星团","de":"Möglicher Doppelhaufen","ko":"이중성단 추정 천체","es":"Posible Cúmulo Binario","ru":"Возможно двойное скопление"},"NGC 6756":{"name":"Possible Binary Cluster","ar":"‎احتمال حشد مزدوج‎","zh":"可能的双星团","de":"Möglicher Doppelhaufen","ko":"이중성단 추정 천체","es":"Posible Cúmulo Binario","ru":"Возможно двойное скопление"},"NGC 6776":{"name":"Pentagon","ar":"‎الخماسي‎","zh":"五角星系","fr":"Pentagone","de":"Fünfeck","it":"Pentagono","ko":"오각형","es":"Pentágono","ru":"Пентагон"},"NGC 6778":{"name":"Son of M76","ar":"إبن م ٧٦","zh":"76之子","de":"Sohn von M76","ja":"M76の息子","ko":"M76의 아들","es":"Hijo de M76","ru":"Сын M76"},"NGC 6781":{"name":"Snowball Nebula","ar":"‎سديم كرة الثلج‎","zh":"雪球星云","fi":"Lumipallosumu","fr":"Nébuleuse de la Boule de neige","de":"Schneeball-Nebel","it":"Nebulosa Palla di Neve","ko":"눈덩이 성운","la":"Sphaera nivis nebula","fa":"سحابی گلوله برفی","es":"Nebulosa Bola de Nieve","ru":"Туманность Снежок"},"NGC 6804":{"name":"Incredible Shrinking Nebula","ar":"‎السديم المتقلص الغريب‎","zh":"收缩星云","de":"Unfassbar schrumpfender Nebel","ko":"엄청나게 가라앉는 성운","es":"Nebulosa Encogimiento Increíble","ru":"Туманность Невероятное сокращение"},"NGC 6809":{"name":"Specter Cluster","ar":"‎حشد سبكتر‎","zh":"幽灵星团","fr":"Amas du Spectre","de":"Gespenst-Haufen","it":"Ammasso Spettro","ko":"망령 성단","es":"Cúmulo Espectro","ru":"Скопление Призрак"},"NGC 6811":{"name":"Hole in a Cluster","ar":"‎‎ثقب في الحشد‎‎","zh":"洞穴星团","fi":"Reikäjoukko","fr":"Le Trou dans un amas","de":"Loch im Haufen","it":"Buco in un Ammasso","ko":"성단의 구멍","la":"Lacuna in Congregatio","es":"Agujero en un Cúmulo","ru":"Дыра в скоплении"},"NGC 6819":{"name":"The Foxhead Cluster","ar":"‎‎حشد رأس الثعلب‎‎","zh":"狐头星团","fi":"Ketunpääjoukko","fr":"Amas de la Tête de renard","de":"Fuchskopf-Haufen","it":"Ammasso Testa di Volpe","ko":"여우 머리 성단","la":"Caput vulpeculae congregatio","fa":"خوشه کله روباه","es":"Cúmulo Cabeza de Zorro","ru":"Скопление Лисья голова"},"NGC 6822":{"name":"Barnard\'s Galaxy","ar":"‎مجرة برنارد‎","zh":"巴纳德星系","fi":"Barnardin galaksi","fr":"Galaxie de Barnard","de":"Barnards Galaxie","el":"Γαλαξίας του Μπάρναρντ","it":"Galassia di Barnard","ja":"バーナード銀河","ko":"버나드 은하","la":"Galaxia Barnardi","fa":"کهکشان بارنارد","es":"Galaxia de Barnard","ru":"Галактика Барнарда","tr":"Barnard\'s Gökadası","he":"גלקסיית ברנרד"},"NGC 6826":{"name":"Blinking Planetary Nebula","ar":"‎السديم الكوكبي المومض‎","zh":"眨眼行星状星云","de":"Blinkender Planetarischer Nebel","it":"Nebulosa Planetaria Intermittente","ko":"깜빡이는 행성상 성운","es":"Nebulosa Planetaria Parpadeante","ru":"Мигающая планетарная туманность"},"NGC 6830":{"name":"Poodle Cluster","ar":"‎حشد كلب البودل‎","zh":"贵宾犬星团","fr":"Amas du Caniche","de":"Pudel-Haufen","it":"Ammasso Barboncino","ko":"푸들 성단","es":"Cúmulo Poodle","ru":"Скопление Пудель"},"NGC 6838":{"name":"Angelfish Cluster","ar":"‎حشد سمك الزينة‎","zh":"神仙鱼星团","fr":"Amas du Poisson scalaire","de":"Anglerfisch-Haufen","it":"Ammasso Squatina","ko":"에인절피시 성단","es":"Cúmulo Angelote","ru":"Скопление Рыба-ангел"},"NGC 6845":{"name":"Klemola 30","ar":"‎كليمولا 30‎","zh":"克莱莫拉30","ko":"클레몰라 30","ru":"Клемола 30"},"NGC 6853":{"name":"Dumbbell Nebula","ar":"‎سديم الأثقال","zh":"哑铃星云","fi":"Nostopainosumu","fr":"Nébuleuse de Dumbbell","de":"Hantel-Nebel","el":"Νεφέλωμα Αλτήρα","it":"Nebulosa manubrio","ja":"亜鈴状星雲","ko":"아령 성운","fa":"سحابی دمبل","es":"Nebulosa de Dumbbell","ru":"Туманность Гантель","tr":"Halter Bulutsusu","he":"ערפילית המשקולת"},"NGC 6866":{"name":"Kite Cluster","ar":"‎حشد الطائرة الورقية‎","zh":"风筝星团","fi":"Leijajoukko","fr":"Amas du Cerf-volant","de":"Flugdrachen-Haufen","it":"Ammasso Aquilone","ko":"연 성단","es":"Cúmulo del Cometa","ru":"Скопление Коршун"},"NGC 6872":{"name":"Condor Galaxy","ar":"‎‎مجرة الكندور‎‎","zh":"秃鹰星系","fi":"Kondorigalaksi","fr":"Galaxie du condor","de":"Kondor Galaxie","it":"NGC 6872","ja":"コンドル銀河","ko":"콘도르 은하","la":"Condor Galaxia","fa":"کهکشان کرکس آمریکایی","es":"Galaxia Condor","ru":"Галактика Кондор"},"NGC 6885":{"name":"20 Vulpeculae Cluster","ar":"‎‎حشد 20 الثعلب‎‎","zh":"狐狸座20星团","fi":"20 Vulpeculae -joukko","fr":"Amas 20 Vulpeculae","de":"20 Vulpeculae Haufen","it":"Ammasso 20 Vulpeculae","ja":"こぎつね座20星団","ko":"여우자리 20 성단","la":"Congregatio 20 Vulpeculae","fa":"خوشه 20 روباهک","es":"Cúmulo 20 Vulpeculae","ru":"Скопление 20 Лисички"},"NGC 6888":{"name":"Crescent Nebula","ar":"‎سديم الهلال‎","zh":"眉月星云","fi":"Sirppisumu","fr":"Nébuleuse du Croissant","de":"Mondsichel-Nebel","el":"Νεφέλωμα Ημισελήνου","it":"Nebulosa crescent","ja":"三日月星雲","ko":"초승달 성운","la":"Crescens Nebula","fa":"سحابی هلالی","es":"Nebulosa del Creciente","ru":"Туманность Полумесяц","tr":"Ayça Bulutsusu"},"NGC 6894":{"name":"Little Ring Nebula","ar":"‎سديم الخاتم الصغير‎","zh":"小指环星云","fi":"Pieni rengassumu","fr":"Nébuleuse du Petit anneau","de":"Kleiner Ringnebel","it":"Nebulosa Piccolo Anello","ko":"작은 고리 성운","la":"Anulus minor nebula","fa":"سحابی حلقه کوچک","es":"Nebulosa del Pequeño Anillo","ru":"Туманность Малое кольцо"},"NGC 6905":{"name":"Blue Flash Nebula","ar":"‎سديم الوميض الازرق‎","zh":"蓝闪星云","fi":"Sinivälähdyssumu","fr":"Nébuleuse de l\'Éclair bleu","de":"Blauer Blitz-Nebel","el":"Νεφέλωμα Μπλε Λάμψης","it":"Nebulosa lampo blu","ja":"青い閃光星雲","ko":"푸른 섬광 성운","fa":"سحابی دارای درخشش آبی","es":"Nebulosa del Destello azul","ru":"Туманность Голубая вспышка","tr":"Mavi flaş Bulutsusu"},"NGC 6907":{"name":"Giant Behemoth Galaxy","ar":"‎مجرة الوحش الضخم‎","zh":"巨兽星系","fi":"Jättiläisgalaksi","fr":"Galaxie du Béhémoth géant","de":"Gigantische Ungeheuer-Galaxie","it":"Galassia Gigante Behemoth","ko":"거대한 베헤모스 은하","es":"Galaxia Behemoth Gigante","ru":"Галактика Гигантский бегемот"},"NGC 6910":{"name":"The Inchworm Cluster","ar":"‎حشد اليسروع‎","zh":"尺蠖星团","fr":"Amas du vert","de":"Spannerraupen-Haufen","it":"Ammasso Bruco di Geometride","ko":"자벌레 성단","es":"Cúmulo El Gusano","ru":"Скопление Землемер"},"NGC 6913":{"name":"Cooling Tower","ar":"‎‎حشد برج التبريد النجمي‎‎","zh":"冷却塔星团","fi":"Jäähdytystorni","fr":"Tour de refroidissement","de":"Kühlturm","it":"Torre di raffreddamento","ko":"냉각탑","fa":"برج سردکننده","es":"Torre de enfriamiento","ru":"Градирня"},"NGC 6939":{"name":"Ghost Bush Cluster","ar":"‎حشد الشجيرة الشبح‎","zh":"鬼套星团","fr":"Amas du Buisson fantôme","de":"Geisterbusch-Haufen","it":"Ammasso Fantasma Cespuglio","ko":"유령 덤불 성단","es":"Cúmulo Zarza Fantasma","ru":"Скопление Призрачный куст"},"NGC 6940":{"name":"Mothra Cluster","ar":"‎حشد موذرا‎","zh":"魔斯拉星团","fr":"Amas Mothra","de":"Mothra-Haufen","it":"Ammasso Mothra","ko":"모스라 성단","la":"Mothra Congregatio","es":"Cúmulo Mothra","ru":"Скопление Мотра"},"NGC 6946":{"name":"Fireworks Galaxy","ar":"‎‎مجرة الألعاب النارية‎‎","zh":"烟花星系","fi":"Ilotulitussumu","fr":"Galaxie du Feu d\'artifice","de":"Feuerwerks-Galaxie","it":"Galassia Fuochi d\'Artificio","ko":"불꽃놀이 은하","fa":"کهکشان آتش بازی","es":"Galaxia de los Fuegos Artificiales","ru":"Галактика Фейрверк"},"NGC 6960":{"name":"Filamentary Nebula","ar":"‎‎سديم الفتيل‎‎","zh":"纤维星云","fi":"Säiesumu","fr":"Nébuleuse filamentaire","de":"Filament-Nebel","it":"Nebulosa Filamentosa","ko":"실 모양 성운","la":"Filamentarica nebula","fa":"سحابی رشته ای","es":"Nebulosa Filamentosa","ru":"Волокнистая туманность"},"NGC 6979":{"name":"Fleming\'s Triangular Wisp","ar":"‎خصلة شعر فلمنج المثلثة‎","zh":"弗莱明三角星云","de":"Flemings Dreieckswisch","ko":"플레밍의 세 줄기","es":"Mechón Triangular de Fleming","ru":"Трёхгранный клок Флеминга"},"NGC 6990":{"name":"Witch\'s Broom Galaxy","ar":"‎مجرة مكنسة الساحرة‎","zh":"女巫扫帚星系","fr":"Galaxie du Balai de sorcière","de":"Hexenbesen-Galaxie","it":"Galassia Spada della Strega","ko":"마녀의 빗자루 은하","es":"Galaxia Escoba de la Bruja","ru":"Галактика Помело ведьмы"},"NGC 6992":{"name":"East Veil Nebula","ar":"‎‎سديم الحجاب الشرقي‎‎","zh":"东面纱星云","fi":"Itäinen harsosumu","fr":"Nébuleuse du Voile est","de":"Östlicher Schleiernebel","it":"Nebulosa Velo dell\'Est","ja":"網状星雲","ko":"동쪽 면사포 성운","fa":"سحابی پرده شرقی","es":"Nebulosa Velo del Este","ru":"Восточная туманность Вуаль"},"NGC 6995":{"name":"Network Nebula","ar":"‎‎سديم الشبكة‎‎","zh":"网星云","fi":"Verkkosumu","fr":"Nébuleuse du Réseau","de":"Netzwerk-Nebel","it":"Nebulosa Rete","ko":"망 성운","fa":"سحابی شبکه","es":"Nebulosa Red","ru":"Туманность Сеть"},"NGC 6996":{"name":"Bird\'s Nest","ar":"‎عش الطير‎","zh":"鸟巢","de":"Vogelnest","ko":"새 둥지","es":"Nido de Pájaro","ru":"Птичье гнездо"},"NGC 7000":{"name":"North America Nebula","ar":"‎‎سديم أمريكا الشمالية‎‎","zh":"北美洲星云","fi":"Pohjois-Amerikka-sumu","fr":"Nébuleuse Amérique du Nord","de":"Nordamerika-Nebel","it":"Nebulosa Nord America","ja":"北アメリカ星雲","ko":"북아메리카 성운","la":"America borealis nebula","fa":"سحابی آمریکای شمالی","es":"Nebulosa Norteamérica","ru":"Туманность Северная Америка"},"NGC 7008":{"name":"Fetus Nebula","ar":"‎‎سديم الجنين‎‎","zh":"胎儿星云","fi":"SIkiösumu","fr":"Nébuleuse du Foetus","de":"Fötus-Nebel","it":"Nebulosa Feto","ko":"태아 성운","la":"Fetus nebula","fa":"سحابی جنین","es":"Nebulosa del Feto","ru":"Туманность Зародыш"},"NGC 7009":{"name":"Saturn Nebula","ar":"‎سديم زحل‎","zh":"土星状星云","fi":"Saturnussumu","fr":"Nébuleuse de Saturne","de":"Saturn-Nebel","el":"Νεφέλωμα Κρόνου","it":"Nebulosa Saturno","ja":"土星状星雲","ko":"토성 성운","fa":"سحابی کیوان","es":"Nebulosa de Saturno","ru":"Туманность Сатурн","tr":"Satürn Bulutsusu"},"NGC 7023":{"name":"Iris Nebula","ar":"‎‎سديم السوسن‎‎","zh":"鸢尾花星云","fi":"Iirissumu","fr":"Nébuleuse de l\'Iris","de":"Iris-Nebel","it":"Nebulosa Arcobaleno","ko":"아이리스 성운","fa":"سحابی عنبیه","es":"Nebulosa Iris","ru":"Туманность Ирис"},"NGC 7026":{"name":"Cheeseburger Nebula","ar":"‎سديم برجر الجبن‎","zh":"乳酪汉堡星云","fi":"Juustohampurilaisgalaksi","fr":"Nébuleuse du Cheeseburger","de":"Cheeseburger-Nebel","it":"Nebulosa Cheeseburger","ko":"치즈버거 성운","fa":"سحابی چیزبرگر","es":"Nebulosa Quesoburguesa","ru":"Туманность Чизбургер"},"NGC 7027":{"name":"Pink Pillow Nebula","ar":"‎سديم المخدة الزهرية‎","zh":"粉枕星云","fr":"Nébuleuse du Coussin rose","de":"Rosa-Kissen-Nebel","it":"Nebulosa Cuscino Rosa","ko":"분홍 베개 성운","es":"Nebulosa Almohada Rosa","ru":"Туманность Розовая подушка"},"NGC 7048":{"name":"Peek-a-Boo Nebula","ar":"‎سديم الغميضة‎","zh":"躲猫猫星云","de":"Kuckuck!-Nebel","ko":"까꿍 성운","es":"Nebulosa Peek-a-Boo","ru":"Туманность Ку-ку"},"NGC 7078":{"name":"Pegasus Cluster","ar":"‎حشد الفرس الأعظم‎","zh":"飞马座星团","fi":"Pegasuksen joukko","fr":"Amas de Pégase","de":"Pegasus-Haufen","it":"Ammasso di Pegaso","ko":"페가수스 성단","la":"Congregatio Pegasi","es":"Cúmulo de Pegaso","ru":"Скопление Пегаса","tr":"Kanatlı At Kümesi","he":"צביר פגסוס"},"NGC 7099":{"name":"Jellyfish Cluster","ar":"‎حشد قنديل البحر‎","zh":"海蜇星团","fi":"Meduusajoukko","fr":"Amas de la Méduse","de":"Quallen-Haufen","it":"Ammasso Medusa","ko":"해파리 성단","es":"Cúmulo Medusa","ru":"Скопление Медуза"},"NGC 7129":{"name":"Small Cluster Nebula","ar":"‎سديم الحشد الصغير‎","zh":"小星团星云","fi":"Pieni rykelmäsumu","fr":"Nébuleuse du Petit Amas","de":"Kleiner Haufen-Nebel","it":"Nebulosa Piccolo Ammasso","ko":"소성단 성운","la":"Congregatio minor nebula","fa":"سحابی خوشه کوچک","es":"Nebulosa Cúmulo Pequeño","ru":"Туманность Малое скопление"},"NGC 7160":{"name":"Swimming Alligator Cluster","ar":"‎حشد التمساح السابح‎","zh":"短吻鳄星团","de":"Schwimmender-Alligator-Haufen","ko":"해엄치는 악어 성단","es":"Cúmulo Caimán Nadador","ru":"Скопление Плывущий аллигатор"},"NGC 7209":{"name":"Star Lizard Cluster","ar":"‎حشد سحلية النجم‎","zh":"飞蜥星团","fr":"Amas de l\'Étoile du Lézard","de":"Sterneidechsen-Haufen","it":"Ammasso Stella Lucertola","ko":"별 도마뱀 성단","la":"Congregatio stellatae lacertae","es":"Cúmulo Lagarto Estrella","ru":"Скопление Звёздная ящерица"},"NGC 7252":{"name":"Atoms for Peace Galaxy","ar":"‎ذرّات لمجرة السّلام‎","zh":"核和平星系","fi":"Rauhanatomit-galaksi","fr":"Galaxie des Atomes pour la paix","de":"Atoms for Peace-Galaxie","el":"Γαλαξίας Σήμα της Ειρήνης","it":"Galassia atomi per la pace","ko":"평화를 위한 원자 은하","fa":"اتمها برای کهکشان پیس","es":"Galaxia de Átomos para la Paz","ru":"Галактика Мирный атом","tr":"Barış için atom Gökadası"},"NGC 7293":{"name":"Helix Nebula","ar":"‎سديم هيلكس‎","zh":"螺旋星云","fi":"Helix-sumu","fr":"Nébuleuse de l\'Hélice","de":"Helix-Nebel","el":"Νεφέλωμα Έλικα","it":"Nebulosa Elica","ja":"らせん状星雲","ko":"나사 성운","la":"Helix nebula","fa":"سحابی مارپیچ","es":"Nebulosa de la Hélice","ru":"Туманность Улитка","tr":"Helis Bulutsusu","he":"ערפילית הסליל"},"NGC 7317":{"name":"Stephan\'s Quintet","ar":"‎‎خماسية ستيفان‎‎","zh":"史蒂芬五重星系","fi":"Stephanin viisikko","fr":"Quintette de Stephan","de":"Stephans Quintett","el":"Κουιντέτο του Στέφαν","it":"Quintetto di Stephan","ja":"ステファンの五つ子","ko":"스테판의 사중주","hi":"स्टीफन क्विंटेट","fa":"پنجگانۀ استفان","es":"Quinteto de Stephan","ru":"Квинтет Стефана","tr":"Stephan\'ın Beşlisi"},"NGC 7318":{"name":"Stephan\'s Quintet","ar":"‎‎خماسية ستيفان‎‎","zh":"史蒂芬五重星系","fi":"Stephanin viisikko","fr":"Quintette de Stephan","de":"Stephans Quintett","el":"Κουιντέτο του Στέφαν","it":"Quintetto di Stephan","ja":"ステファンの五つ子","ko":"스테판의 사중주","hi":"स्टीफन क्विंटेट","fa":"پنجگانۀ استفان","es":"Quinteto de Stephan","ru":"Квинтет Стефана","tr":"Stephan\'ın Beşlisi"},"NGC 7319":{"name":"Stephan\'s Quintet","ar":"‎‎خماسية ستيفان‎‎","zh":"史蒂芬五重星系","fi":"Stephanin viisikko","fr":"Quintette de Stephan","de":"Stephans Quintett","el":"Κουιντέτο του Στέφαν","it":"Quintetto di Stephan","ja":"ステファンの五つ子","ko":"스테판의 사중주","hi":"स्टीफन क्विंटेट","fa":"پنجگانۀ استفان","es":"Quinteto de Stephan","ru":"Квинтет Стефана","tr":"Stephan\'ın Beşlisi"},"NGC 7320":{"name":"Stephan\'s Quintet","ar":"‎‎خماسية ستيفان‎‎","zh":"史蒂芬五重星系","fi":"Stephanin viisikko","fr":"Quintette de Stephan","de":"Stephans Quintett","el":"Κουιντέτο του Στέφαν","it":"Quintetto di Stephan","ja":"ステファンの五つ子","ko":"스테판의 사중주","hi":"स्टीफन क्विंटेट","fa":"پنجگانۀ استفان","es":"Quinteto de Stephan","ru":"Квинтет Стефана","tr":"Stephan\'ın Beşlisi"},"NGC 7331":{"name":"Deer Lick Group","ar":"‎‎لعق الغزال‎‎","zh":"鹿舔星系群","fi":"Nuolukivijoukko","fr":"Groupe Deer Lick","de":"NGC 7331 Gruppe","it":"Gruppo Deer Lick","ko":"디어 릭 은하단","la":"Caetus Deer Lick","fa":"گروه کهکشانی در فرس اعظم","es":"Grupo de Ciervos Lamiéndose","ru":"Солончаковая группа"},"NGC 7380":{"name":"The Wizard Nebula","ar":"‎‎سديم الساحر‎‎","zh":"巫师星云","fi":"Velhosumu","fr":"Nébuleuse du Sorcier","de":"Wizard-Nebel","it":"Nebulosa Mago","ko":"마법사 성운","la":"Nebula magici","fa":"سحابی جادوگر","es":"La Nebulosa Mago","ru":"Туманность Колдун"},"NGC 7385":{"name":"NGC 7385 group","ar":"مجموعة إن جي سي ٧٣٨٥","zh":"7385 星系群","fi":"NGC 7385 -joukko","fr":"Groupe NGC 3785","de":"NGC 7385-Gruppe","ja":"NGC7385銀河群","ko":"NGC 7385 은하단","es":"Grupo NGC 7385","ru":"Группа NGC 7385"},"NGC 7424":{"name":"Grand Design Galaxy","ar":"‎‎مجرة التصميم العظيم‎‎","zh":"大设计星系","fi":"Kehittynyt spiraaligalaksi","fr":"Galaxie de grand style","de":"Grand Design-Galaxie","it":"Galassia Gran Disegno","ko":"대설계 은하","fa":"کهکشان طراحی باشکوه","es":"Galaxia Gran Diseño","ru":"Галактика Великий замысел"},"NGC 7479":{"name":"Superman Galaxy","ar":"‎مجرة سوبرمان‎","zh":"超人星系","fr":"Galaxie de Superman","de":"Superman-Galaxie","it":"Galassia Superman","ko":"슈퍼맨 은하","es":"Galaxia Superman","ru":"Галактика Супермэн"},"NGC 7510":{"name":"The Dormouse Cluster","ar":"‎حشد الفأرة‎","zh":"睡鼠星团","fr":"Amas du Loir","de":"Siebenschläfer-Haufen","it":"Ammasso Ghiro","ko":"동면쥐 성단","la":"Congregatio glidis","es":"Cúmulo del Soñador","ru":"Скопление Соня"},"NGC 7538":{"name":"Northern Lagoon Nebula","ar":"‎سديم البركة الشمالية‎","zh":"北礁湖星云","fi":"Pohjoinen laguunisumu","de":"Nördlicher Lagunennebel","ja":"北の干潟星雲","ko":"북쪽 석호 성운","es":"Nebulosa del Lago del Norte","ru":"Туманность Северная лагуна"},"NGC 7552":{"name":"Grus Quartet","ar":"‎‎رباعية الكركي‎‎","zh":"天鹤座四重星系","fi":"Kurjen nelikko","fr":"Quatuor de la Grue","de":"Grus-Quartett","el":"Κουαρτέτο του Γερανού","it":"Quartetto della Gru","ja":"つる座の四重星","ko":"두루미자리 사중주","fa":"چهارقلوی دُرنا","es":"Cuarteto Grus","ru":"Квартет Журавля","tr":"Turna Dörtlüsü"},"NGC 7582":{"name":"Grus Quartet","ar":"‎‎رباعية الكركي‎‎","zh":"天鹤座四重星系","fi":"Kurjen nelikko","fr":"Quatuor de la Grue","de":"Grus-Quartett","el":"Κουαρτέτο του Γερανού","it":"Quartetto della Gru","ja":"つる座の四重星","ko":"두루미자리 사중주","fa":"چهارقلوی دُرنا","es":"Cuarteto Grus","ru":"Квартет Журавля","tr":"Turna Dörtlüsü"},"NGC 7590":{"name":"Grus Quartet","ar":"‎‎رباعية الكركي‎‎","zh":"天鹤座四重星系","fi":"Kurjen nelikko","fr":"Quatuor de la Grue","de":"Grus-Quartett","el":"Κουαρτέτο του Γερανού","it":"Quartetto della Gru","ja":"つる座の四重星","ko":"두루미자리 사중주","fa":"چهارقلوی دُرنا","es":"Cuarteto Grus","ru":"Квартет Журавля","tr":"Turna Dörtlüsü"},"NGC 7599":{"name":"Grus Quartet","ar":"‎‎رباعية الكركي‎‎","zh":"天鹤座四重星系","fi":"Kurjen nelikko","fr":"Quatuor de la Grue","de":"Grus-Quartett","el":"Κουαρτέτο του Γερανού","it":"Quartetto della Gru","ja":"つる座の四重星","ko":"두루미자리 사중주","fa":"چهارقلوی دُرنا","es":"Cuarteto Grus","ru":"Квартет Журавля","tr":"Turna Dörtlüsü"},"NGC 7635":{"name":"Bubble Nebula","ar":"‎سديم الفقاعة‎","zh":"气泡星云","fi":"Kuplasumu","fr":"Nébuleuse de la Bulle","de":"Blasen-Nebel","el":"Νεφέλωμα Φυσαλίδα","it":"Nebulosa bolla","ja":"バブル星雲","ko":"버블 성운","fa":"سحابی حبابی","es":"Nebulosa de la Burbuja","ru":"Туманность Пузырь","tr":"Kabarcık Bulutsusu","he":"ערפילית הבועה"},"NGC 7654":{"name":"Cassiopeia Salt-and-Pepper Cluster","ar":"‎حشد ملح وفلفل ذات الكرسي‎","zh":"仙后座椒盐星团","fi":"Kassiopeian suola- ja pippurijoukko","fr":"Amas Sel-et-Poivre de Cassiopée","de":"Cassiopeia-Salz-und-Pfeffer-Haufen","it":"Ammasso Cassiopea Sale e Pepe","ko":"카시오페이아자리 소금과 후추 성단","fa":"خوشه نمک و فلفل ذات الکرسی","es":"Cúmulo Cassiopeia Sal y Pimienta","ru":"Скопление Проседь Кассиопеи"},"NGC 7662":{"name":"Blue Snowball","ar":"‎‎كرة الثلج الزرقاء‎‎","zh":"蓝雪球星云","fi":"Sininen lumipallo","fr":"Boule de neige bleue","de":"Blauer Schneeball","el":"Μπλε Χιονόμπαλα","it":"Palla di neve blu","ja":"青い雪だるま","ko":"푸른 눈덩이","hi":"ब्लू स्नोबाल","fa":"گلوله‌برفی آبی","es":"Bola de nieve azul","ru":"Голубой снежок","tr":"Mavi Kartopu"},"NGC 7742":{"name":"Fried-egg Galaxy","ar":"‎‎مجرة البيض المقلي‎‎","zh":"荷包蛋星系","fi":"Paistettu muna -galaksi","fr":"Galaxie de l\'Oeuf au plat","de":"Spiegelei-Galaxie","it":"Galassia Uovo Fritto","ko":"삶은 달걀 은하","fa":"کهکشان تخم مرغ نیمرو","es":"Galaxia Huevo Frito","ru":"Галактика Яичница"},"NGC 7789":{"name":"Caroline\'s Rose Cluster","ar":"‎‎حشد وردة كارولين‎‎","zh":"卡洛琳玫瑰星团","fi":"Carolinen ruusu","fr":"Amas de la Rose de Caroline","de":"Carolines Rosen-Haufen","it":"Ammasso Rosa di Carolina","ko":"캐로라인의 장미 성단","la":"Congregatio Rosae Carolinae","fa":"خوشه رز کارولین","es":"Cúmulo Rosa de Carolina","ru":"Скопление Роза Каролины"},"NGC 7790":{"name":"The Widow\'s Web Cluster","ar":"‎حشد نسيج العنكبوت‎","zh":"寡妇的网星团","fr":"Amas de la Toile de la Veuve","de":"Witwennetz-Haufen","it":"Ammasso Ragnatela della Vedova","ko":"위도우의 웹 성단","es":"Cúmulo Tela de Viuda Negra","ru":"Скопление Лента вдовы"},"NGC 7793":{"name":"Bond\'s Galaxy","ar":"مجرة بوند","zh":"邦德星系","de":"Bonds Galaxie","ko":"본드의 은하","es":"Galaxia de Bond","ru":"Галактика Бонда"},"NGC 7814":{"name":"The Little Sombrero Galaxy","ar":"‎مجرة القبعة المكسيكية الصغيرة‎","zh":"小墨西哥帽星系","fi":"Pieni sombrerogalaksi","fr":"Galaxie du Petit Sombrero","de":"Kleine Sombrero-Galaxie","it":"Galassia del Piccolo Sombrero","ko":"작은 솜브레오 은하","la":"Sombrero minor galaxia","es":"Galaxia del Pequeño Sombrero","ru":"Галактика Маленькое сомбреро"},"IC 10":{"name":"Starburst Galaxy","ar":"‎مجرة الإنفجار النجمي‎","zh":"星爆星系","fi":"Tähtiryöppygalaksi","fr":"Galaxie de l\'Éclat d\'Étoile","de":"Starburst-Galaxie","it":"Galassia Esplosione di Stella","ko":"스타버스트 은하","es":"Galaxia Estallido Estelar","ru":"Галактика звездообразования"},"IC 59":{"name":"γ Cas Nebula","ar":"‎‎سديم جاما ذات الكرسي‎‎","zh":"策星云","fi":"γ Cassiopeia -sumu","fr":"Nébuleuse γ Cas","de":"γ Cas-Nebel","it":"Nebulosa γ Cas","ja":"カシオペヤ座γ星雲","ko":"카시오페이아자리 감마 성운","fa":"سحابی گاما-ذات الکرسی","es":"Nebulosa γ Cas","ru":"Туманность γ Кассиопеи"},"IC 63":{"name":"γ Cas Nebula","ar":"‎‎سديم جاما ذات الكرسي‎‎","zh":"策星云","fi":"γ Cassiopeia -sumu","fr":"Nébuleuse γ Cas","de":"γ Cas-Nebel","it":"Nebulosa γ Cas","ja":"カシオペヤ座γ星雲","ko":"카시오페이아자리 감마 성운","fa":"سحابی گاما-ذات الکرسی","es":"Nebulosa γ Cas","ru":"Туманность γ Кассиопеи"},"IC 342":{"name":"Maffei 1 Group","ar":"‎مجموعة مافي 1‎","zh":"马费伊1星系群","fi":"Maffei 1 -ryhmä","de":"Maffei 1 Gruppe","ja":"マフェイ1銀河群","ko":"마페이 1 은하단","es":"Grupo Maffei 1","ru":"Группа Маффей 1"},"IC 348":{"name":"ο Per Cloud","ar":"‎سحابة أوميكرون حامل رأس الغول‎","zh":"卷舌五星云","fr":"Nuage ο Per","de":"ο Per-Wolke","it":"Ammasso ο Per","ja":"ペルセウス座ο星雲","ko":"페가수스자리 오미크론 성운","es":"Nube ο Per","ru":"Облако ο Персея"},"IC 349":{"name":"Barnard\'s Merope Nebula","ar":"‎سديم بارنارد ميروب‎","zh":"巴纳德昴宿五星云","fi":"Barnardin Merope-sumu","fr":"Nébuleuse de Mérope de Barnard","de":"Barnards Merope-Nebel","it":"Nebulosa Merope di Barnard","ja":"バーナードのメローペ星雲","ko":"바너드의 메로페 성운","es":"Nebulosa Merope de Barnard","ru":"Туманность Меропа Барнарда"},"IC 405":{"name":"Flaming Star Nebula","ar":"‎السّديم اللامع الملتهب‎","zh":"火焰之星星云","fi":"Liekehtivä tähtisumu","fr":"Nébuleuse de l\'Étoile flamboyante","de":"Flammender Stern-Nebel","el":"Νεφέλωμα Φλεγόμενος Αστέρας","it":"Nebulosa stella fiammeggiante","ja":"曲玉星雲","ko":"불꽃별 성운","fa":"سحابی ستارۀ Flaming","es":"Nebulosa de la Estrella llameante","ru":"Туманность Пылающая звезда","tr":"Parlayan Yıldız Bulutsusu"},"IC 410":{"name":"The Tadpoles","ar":"‎الشراغيف‎","zh":"小蝌蚪星云","fi":"Nuijapäät","fr":"Les Têtards","de":"Kaulquappen","it":"I Girini","ko":"올챙이","es":"Los Renacuajos","ru":"Головастики"},"IC 417":{"name":"Spider Nebula","ar":"‎‎سديم العقرب‎‎","zh":"蜘蛛星云","fi":"Hämähäkkisumu","fr":"Nébuleuse de l\'araignée","de":"Spinnennebel","it":"Nebulosa Ragno","ko":"거미 성운","fa":"سحابی عنکبوت","es":"Nebulosa de la Araña","ru":"Туманность Паук"},"IC 418":{"name":"Spirograph Nebula","ar":"‎‎سديم الراسم اللولبي‎‎","zh":"万花尺星云","fi":"Spirografisumu","fr":"Nébuleuse du Spirographe","de":"Spirograph-Nebel","it":"Nebulosa Spirografo","ko":"스피로그래프 성운","fa":"سحابی دم نگار","es":"Nebulosa Espirógrafo","ru":"Туманность Спирограф"},"IC 443":{"name":"Jellyfish Nebula","ar":"‎‎سديم قنديل البحر‎‎","zh":"水母星云","fi":"Meduusasumu","fr":"Nébuleuse de la Méduse","de":"Quallen-Nebel","it":"Nebulosa Medusa","ko":"해파리 성운","fa":"سحابی ستاره دریایی","es":"Nebulosa Medusa","ru":"Туманность Медуза"},"IC 708":{"name":"Papillon","ar":"‎‎الفراشة‎‎","zh":"蝴蝶犬星系","fi":"Perhonen","de":"Schmetterling","el":"Πάπιλλον","he":"פפילון","it":"Farfalla","ko":"빠삐용","la":"Papilio","fa":"پاپیلون","es":"Mariposa","ru":"Папиллон","tr":"Papyon"},"IC 1318":{"name":"γ Cyg Nebula","ar":"‎سديم جاما البجعة‎","zh":"天津一星云","fi":"γ Cyg -sumu","fr":"Nébuleuse γ Cyg","de":"γ Cyg-Nebel","it":"Nebulosa γ Cyg","ja":"はくちょう座γ星雲","ko":"백조자리 감마 성운","es":"Nebulosa γ Cyg","ru":"Туманность γ Лебедя"},"DWB 63":{"name":"γ Cyg Nebula","ar":"‎سديم جاما البجعة‎","zh":"天津一星云","fi":"γ Cyg -sumu","fr":"Nébuleuse γ Cyg","de":"γ Cyg-Nebel","it":"Nebulosa γ Cyg","ja":"はくちょう座γ星雲","ko":"백조자리 감마 성운","es":"Nebulosa γ Cyg","ru":"Туманность γ Лебедя"},"IC 1365":{"name":"ZW II 108 Group","ar":"‎ZW II 108 مجموعة‎","zh":"108星系群","fi":"ZW II 108 -ryhmä","fr":"Groupe ZW II 108","de":"ZW II 108 Gruppe","it":"Gruppo γ Cyg","ja":"ZW II 108銀河群","ko":"ZW II 108 은하단","es":"Grupo ZW II 108","ru":"Группа ZW II 108"},"IC
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
