jocoteles/Stellector/(commit log)

2020-08-20 The first working version. Full steppers control from the web interface with acellerometer feedback to self correct orientation toward zenith. The accelerometer orientation information is sent back t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
2020-08-25 Implementation of star search procedures in the calibration field.
2020-12-19 Class VecSP, CommSP, PathSP modified and saved at /modules/StarPointer.module.js. Lib lalolib.js was discarded. Lib optimization.js is used instead. Python server file for https local access with sel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
2021-01-21 Starnames.js was modified in order to exclude the solar system objects, which were not included in the original file. Instead, the solar system objects were included in the json object inside the scr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
2021-04-15 The Coordinates Tab in the Navigation window was redesigned. Separate fields for equatorial and steppers coordinates were created. A goSteps button was created besides de goEquatorial button. The equ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
2021-04-21 A combo list with sky object types was created for the Calib and Nav Objects tab. Filter inputs are shown as function of the object type option selected. Deep sky objects (dso) database from celestia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
2021-05-04 Sky track items tab added. Sky track data added as constellation borders, constellation lines, ecliptic, and asterisms. The next step will be tring to avoid using timeout function in the readActSteps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
2021-05-05 The initial purpose of this branch is to try to stablish a bluetooth characteristic that informs the ESP32 server status to the webapp client. For that the statusC characteristic was created. Next st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
2021-05-07 The laser activation function was modified. The LASER_ON and LASER_OFF communication options were replaced by only one LASER_SWITCH option. The client App laser button now displays the laser status r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
2021-05-08 Laser state is being correctly comnunicated. Next step is to correct the setZenith communication which is not working.
2021-05-13 Sequence of circular paths, go to zenith and turn on and off laser were sucessfully tested. The ESP32 server returned the correct command send to it for all those cases. Next step is to improve the m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
2021-05-15 Laser switch and Idle status implemented. Unfortunately, even with the idle status flag, it is hard to check the actual laser state. In the next commit, the Idle status will be removed and the laser 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
2021-05-15 Laser button was replaced by a switch button. Therefore, it doesn't display the laser status in the button color and text. The PRECISE_PATH_OPT was created in order to tell the ESP32 server that the 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
2021-05-15 Main operations of Sky Tracks tab were debuged and are working fine. Track at date-time and execute cyclically were not tested yet.
2021-05-17 Calibration window procedures debuged and tested. There is a flutuation in the angle deviation obtatined from optimization. One hypotesys is a poor optimization algorithm choice and other is the read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
2021-05-25 Free navigation was improved by keeping the steppers on. A timer procedure was implemented in the ESP32 server that turns off the steppers and the laser after a given interval when idle.
2021-06-03 For this branch, the directional accelerometer was discarded. The steppers angles are given by the steps history sent to the steppers. Another important modification was the use of three independent 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
2021-06-04 A more simple calibration procedure assuming the fix and mobile axes always perpendicular was implemented with excelent results. An error in the Calibration.calcCalib was found where the ra time corr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
2021-06-11 The zero calibration option was modified to include a scale factor for both fix and mobile angles. Experimental tests showed that the optimization convergence was harder and gave diffent results with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
2021-06-15 Simulation functions were added to the script.js file under the namespace Sim. A temporary button called Add Sim was added right bellow the Add Star button in the calibration tab in the index .html f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
2021-07-06 Changes to the calibration routines were made. Experimental tests showed very nice results with maximum deviations of 0.5 steps for four to five calibration stars. The goNow procedure has some bug. A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
2021-07-08 The bug in the goNow procedure was corrected. The goTrack procedures were also tested. They have some problems, where the first star of the series is not showed and the step back and step forw have a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
2021-07-08 The calc calib with func1 was removed, since it presented inferior performance relatively to func0. Fuc0 optimizes the euler angles and the linear transform of the motors step size to rad step size. 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
2021-07-12 Important errors in Sky Track procedures were found: lack of normalized vector in vector3.cross product and vector mistake indexing, both in the PathSP.makeGeodesic procedure.
2021-07-23 Calibration options with angle stretch and mob axis tilt were implemented, but not tested yet.
2021-07-23 Calibration procedure was strongly changed to provide the optional optimization of the tilt angles of laser and stepper mob axes. The simulation procedures were removed.
2021-08-06 First sucessfully test with hc-sr04 ultrasonic sensor. Code included in StarProjector.ino file.
2021-08-07 Sensors gy521 and gy511 were installed and sucessfully tested.
2021-08-10 setZenith function implemented. It takes the laser to the zenith direction using a very simple procedure.
2021-08-12 All safety procedures, including accelerometer level, laser above horizon and ultrasonic measurement distance from ground were implemented and tested. It was found a problem when a cyclic path is sub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
2021-10-25 Namespaces redifined. All specific project code for the Hathor webapp concentrated in a single file at hathor.js. JsDoc with toaster generated. ESP32 server renamed to Horus.
2021-11-01 FreeCAD python scripting codes for Horus 3D parts added.
    [laserCase.obj, laserShaftSupport.obj, octagonalBase.obj, stepperMob.obj, towerBearing.obj, towerStepper.obj]
2021-11-09 README.MD and LICENSE.txt files added. Progressive web app files for Hathor software added.
    [laserCase.obj, laserShaftSupport.obj, octagonalBase.obj, spiralCoil_5v_p100.obj, stepperMob.obj, towerBearing.obj, towerStepper.obj]
2021-11-10 DOI badge cut and pasted to v.0.1.0-alpha release
